6haitandimon/BSUSat2_simulator/docs/КД_CМКА/Файлы заказа/GNSS/StackUp_2L.jpg

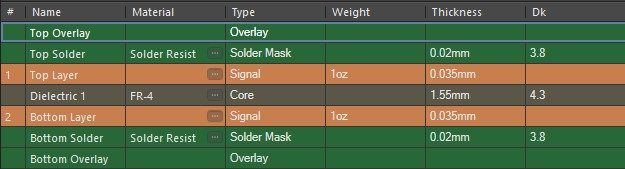
docs/КД_CМКА/Файлы заказа/GNSS/StackUp_2L.jpg
