6haitandimon/BSUSat2_simulator/docs/КД_CМКА/1_Ведомость-ВС_v1.docx

| | | Документация общая
| A4 | BY.ФДБИ 955.00.00.00 ПЗ | Пояснительная записка | 44
| A4 | BY.ФДБИ 955.00.00.00 ВО | Инженерная модель СМКА. Чертеж Общего вида | 1
| A4 | BY.ФДБИ 955.00.00.00 Э1 | Инженерная модель СМКА. Схема электрическая структурная | 2
| | | Документация по сборочным единицам
| A4 | BY.ФДБИ 955.01.00.00 СБ | Каркас инженерной модели СМКА. Сборочный чертеж | 2
| A2 | BY.ФДБИ 955.01.01.00 | Боковая сторона | 1
| A2 | BY.ФДБИ 955.01.02.00 | Верхняя сторона | 1
| A4 | BY.ФДБИ 955.01.03.00 | Опора | 1
| А2 | BY.ФДБИ 955.01.04.00 | Переборка | 1
| А4 | BY.ФДБИ 955.01.05.00 | Крепление датчика направления на солнце | 1
| *) | BY.ФДБИ 955.02.00.00 Э1 | Бортовая система энергоснабжения и коммуникации. Схема электрическая структурная | 9 | | А3, А4
| *) | BY.ФДБИ 955.02.00.00 Э3 | Бортовая система энергоснабжения и коммуникации. Схема электрическая принципиальная | 11 | | А3, А4
| А4 | BY.ФДБИ 955.02.00.00 ПЭ3 | Бортовая система энергоснабжения и коммуникации. Перечень элементов | 4
| А4 | BY.ФДБИ 955.02.00.00 СБ | Бортовая система энергоснабжения и коммуникации. Сборочный чертеж | 2
| А4 | BY.ФДБИ 955.02.01.00 Э1 | Модуль аккумуляторных батарей. Схема электрическая структурная | 2
| А4 | BY.ФДБИ 955.02.01.00 Э3 | Модуль аккумуляторных батарей. Схема электрическая принципиальная | 5
| А4 | BY.ФДБИ 955.02.01.00 ПЭ3 | Модуль аккумуляторных батарей. Перечень элементов | 3
| А4 | BY.ФДБИ 955.02.01.00 СБ | Модуль аккумуляторных батарей. Сборочный чертеж | 2
| А4 | BY.ФДБИ 955.03.00.00 Э1 | Модуль бортовой системы радиосвязи. Схема электрическая структурная | 2
| А4 | BY.ФДБИ 955.03.00.00 Э3 | Модуль бортовой системы радиосвязи. Схема электрическая принципиальная | 5
| А4 | BY.ФДБИ 955.03.00.00 ПЭ3 | Модуль бортовой системы радиосвязи. Перечень элементов | 2
| А4 | BY.ФДБИ 955.03.00.00 СБ | Модуль бортовой системы радиосвязи. Сборочный чертеж | 2
| А4 | BY.ФДБИ 955.04.00.00 Э1 | Модуль системы радионавигации. Схема электрическая структурная | 2
| А4 | BY.ФДБИ 955.04.00.00 Э3 | Модуль системы радионавигации. Схема электрическая принципиальная | 7
| А4 | BY.ФДБИ 955.04.00.00 ПЭ3 | Модуль системы радионавигации. Перечень элементов | 2
| А4 | BY.ФДБИ 955.04.00.00 СБ | Модуль системы радионавигации. Сборочный чертеж | 2
| А4 | BY.ФДБИ 955.05.00.00 Э1 | Модуль электромагнитной ориентации и стабилизации. Схема электрическая структурная | 2
| А4 | BY.ФДБИ 955.05.00.00 Э3 | Модуль электромагнитной ориентации и стабилизации. Схема электрическая принципиальная | 7
| А4 | BY.ФДБИ 955.05.00.00 ПЭ3 | Модуль электромагнитной ориентации и стабилизации. Перечень элементов | 3
| А4 | BY.ФДБИ 955.05.00.00 СБ | Модуль электромагнитной ориентации и стабилизации. Сборочный чертеж | 2
| А4 | BY.ФДБИ 955.06.00.00 Э1 | Модуль датчиков направления на Солнце и системы оптического трекинга. Схема электрическая структурная | 1
| А4 | BY.ФДБИ 955.06.00.00 Э3 | Модуль датчиков направления на Солнце и системы оптического трекинга. Схема электрическая принципиальная | 5
| А4 | BY.ФДБИ 955.06.00.00 ПЭ3 | Модуль датчиков направления на Солнце и системы оптического трекинга. Перечень элементов | 2
| А4 | BY.ФДБИ 955.06.00.00 СБ | Модуль датчиков направления на Солнце и системы оптического трекинга. Сборочный чертеж | 2
| А4 | BY.ФДБИ 955.07.00.00 Э1 | Модуль системы бортового компьютера Схема электрическая структурная | 2
| А4 | BY.ФДБИ 955.07.00.00 Э3 | Модуль системы бортового компьютера Схема электрическая принципиальная | 9
| А4 | BY.ФДБИ 955.07.00.00 ПЭ3 | Модуль системы бортового компьютера. Перечень элементов | 3
| А4 | BY.ФДБИ 955.07.00.00 СБ | Модуль системы бортового компьютера. Сборочный чертеж | 2

BY.ФДБИ 955.00.00.00 ВС Копировал: Лист 2 Изм Формат А4 Лист № докум. Подпись Дата Форма 8а ГОСТ 2.106-96

BY.ФДБИ 955.00.00.00 ВС Изм Лист № докум. Подпись Дата Разраб. Суровцев Инженерная модель СМКА Ведомость спецификаций Лит. Лист Листов Пров. Стецко О 1 2 БГУ Н. контр. Огурцов Утв. Копировал: Формат А4 Семенович Форма 8 ГОСТ 2.106-96

№ строки Формат Обозначение Наименование Кол. листов № экз. Приме- чание

№ строки Формат Обозначение Наименование Кол. листов № эк Приме- чание
