6haitandimon/BSUSat2_simulator/docs/КД_CМКА/Документы/Титул_ПЗ.pdf

Инв. № подл. Подп. и дата Взам. инв. № Инв. № дубл. Подп. и дата

УТВЕРЖДЕН
ФДБИ 955.00.00.00.053

Разработать аппаратно-программный комплекс инженерных моделей СМКА и НКУ для отработки группового полёта

Рабочая конструкторская документация на опытный образец инженерной модели сверхмалого космического аппарата

Пояснительная записка

договор № 395/15 от 03.08.2021

ФДБИ 955.00.00.00.053
