6haitandimon/BSUSat2_simulator/docs/КД_CМКА/Документы/Титул_РКД_СМКА.pdf

Инв. № подл. Подп. и дата Взам. инв. № Инв. № дубл. Подп. и дата

УТВЕРЖДЕН
ФДБИ 955.00.00.00.053

Разработать аппаратно-программный комплекс инженерных моделей СМКА И НКУ
для отработки группового полета

Комплект рабочей конструкторской документации
на опытный образец инженерной модели СМКА с литерой «О»

к договору № 395/15 от 03.08.2021

ФДБИ 955.00.00.00.053
