6haitandimon/BSUSat2_simulator/docs/КД_CМКА/Файлы заказа/Mainboard/Diff_pair_90.jpg

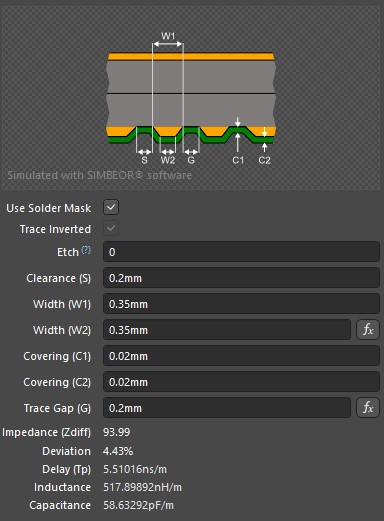
docs/КД_CМКА/Файлы заказа/Mainboard/Diff_pair_90.jpg
