6haitandimon/BSUSat2_simulator/docs/КД_CМКА/Файлы заказа/Mainboard/StackUp_4L.jpg

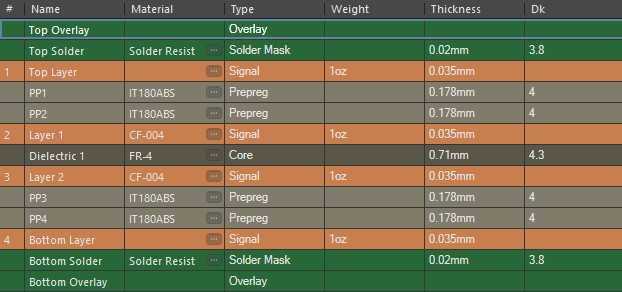
docs/КД_CМКА/Файлы заказа/Mainboard/StackUp_4L.jpg
