6haitandimon/BSUSat2_simulator/docs/КД_CМКА/Схемы/BY.ФДБИ 955.02.00.00 Э1_Э3.pdf

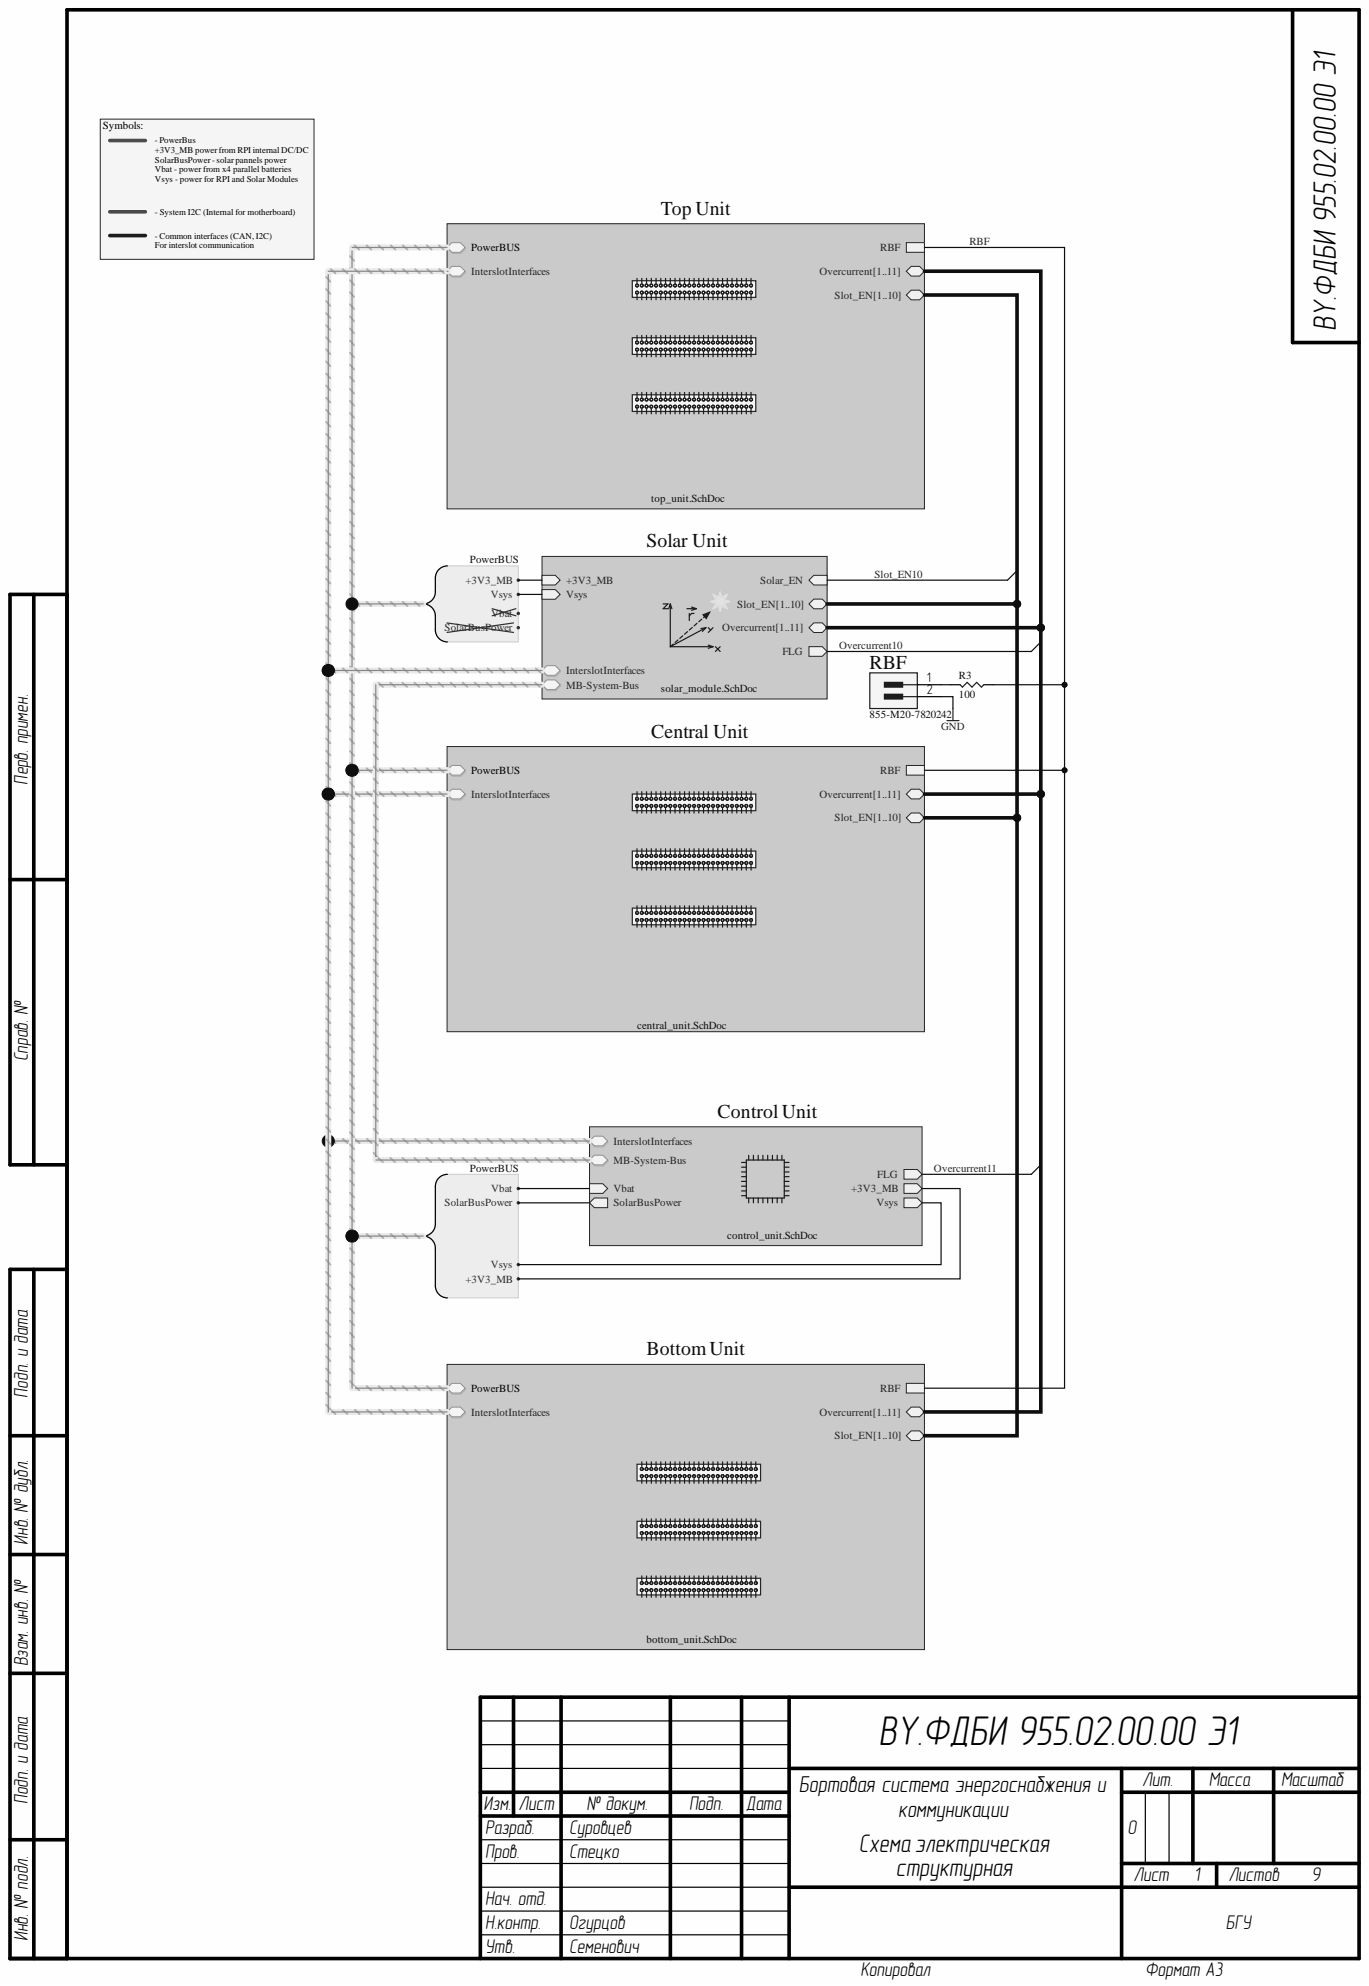
[picture p64: page 1]

- PowerBus
+3V3_MB power from RPI internal DC/DC
SolarBusPower -solar pannels power
Vbat - power from x4 parallel batteries
Vsys - power for RPI and Solar Modules

- System I2C (Internal for motherboard)

SolarBusPower Vsys

control_unit.SchDoc

BY.ФДБИ 955.02.00.00 Э1

Лит. | Масса | Масштаб

Изм. | Лист | № докум. | Подп. | Дата | | О
Разраб. | | Суровцев
Пров. | | Стецко

Лист | Листов 9

Нач. отд. | | | | | БГУ
Н.контр. | Огурцов
Утв. | Семенович

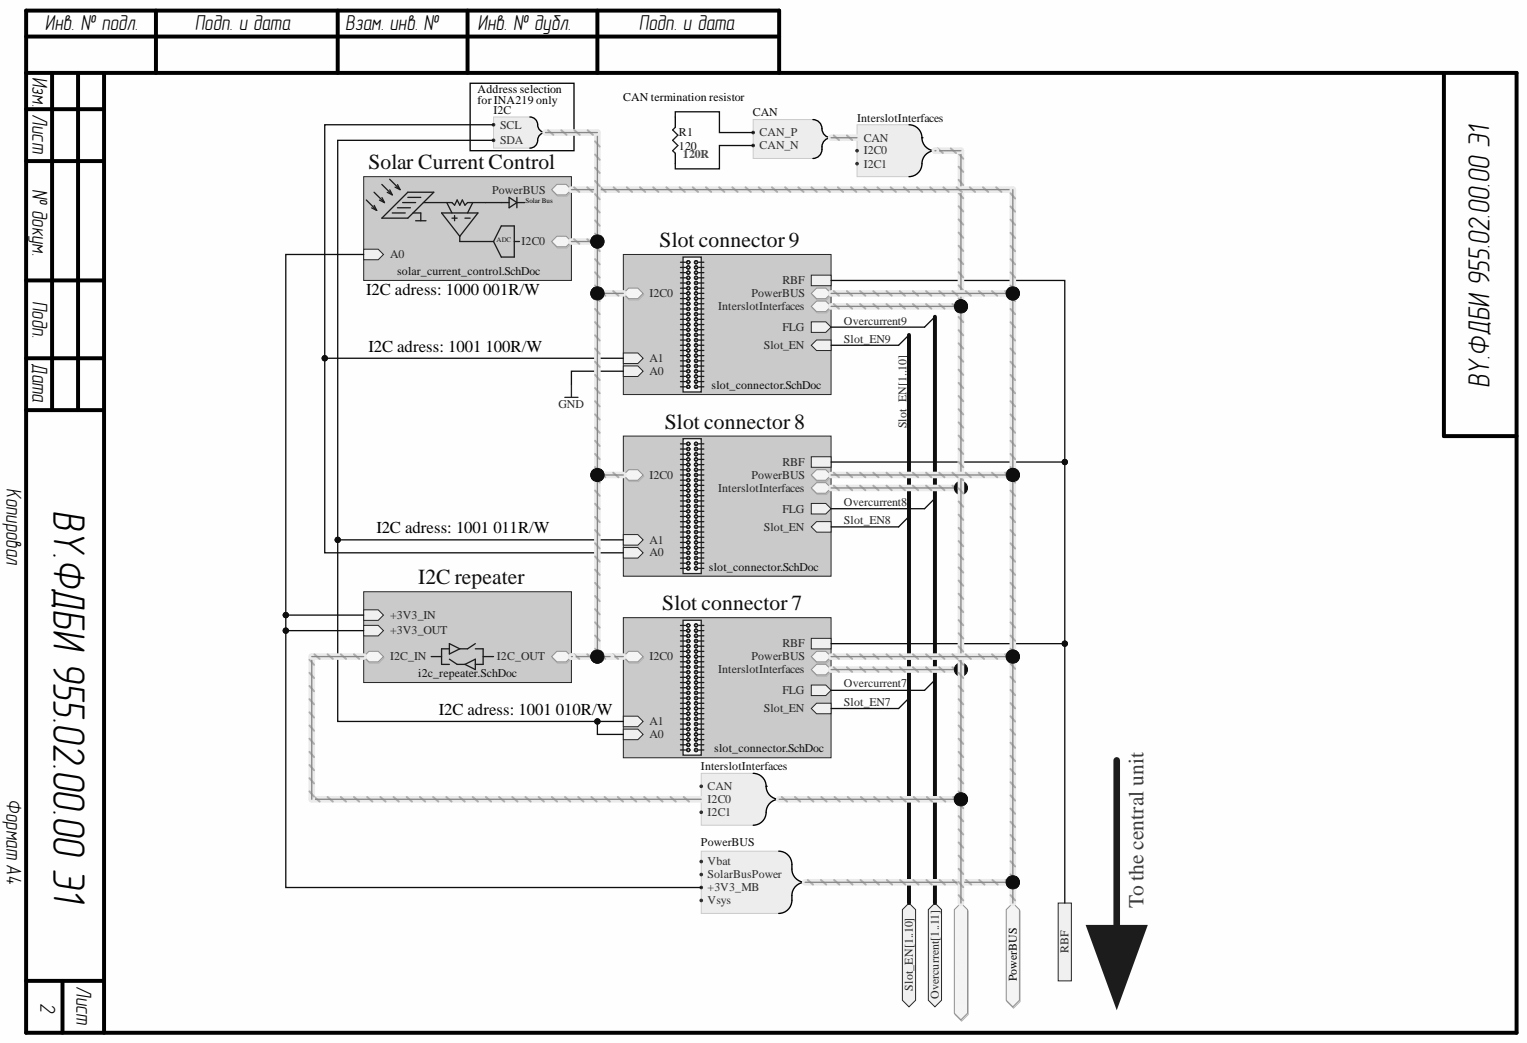
[picture p65: page 2]

Solar Current Control

PowerBUS

Slot connector 9

I2C0 A1 A0 | PowerBUS InterslotInterfaces FLG Slot_EN slot_connector.SchDoc

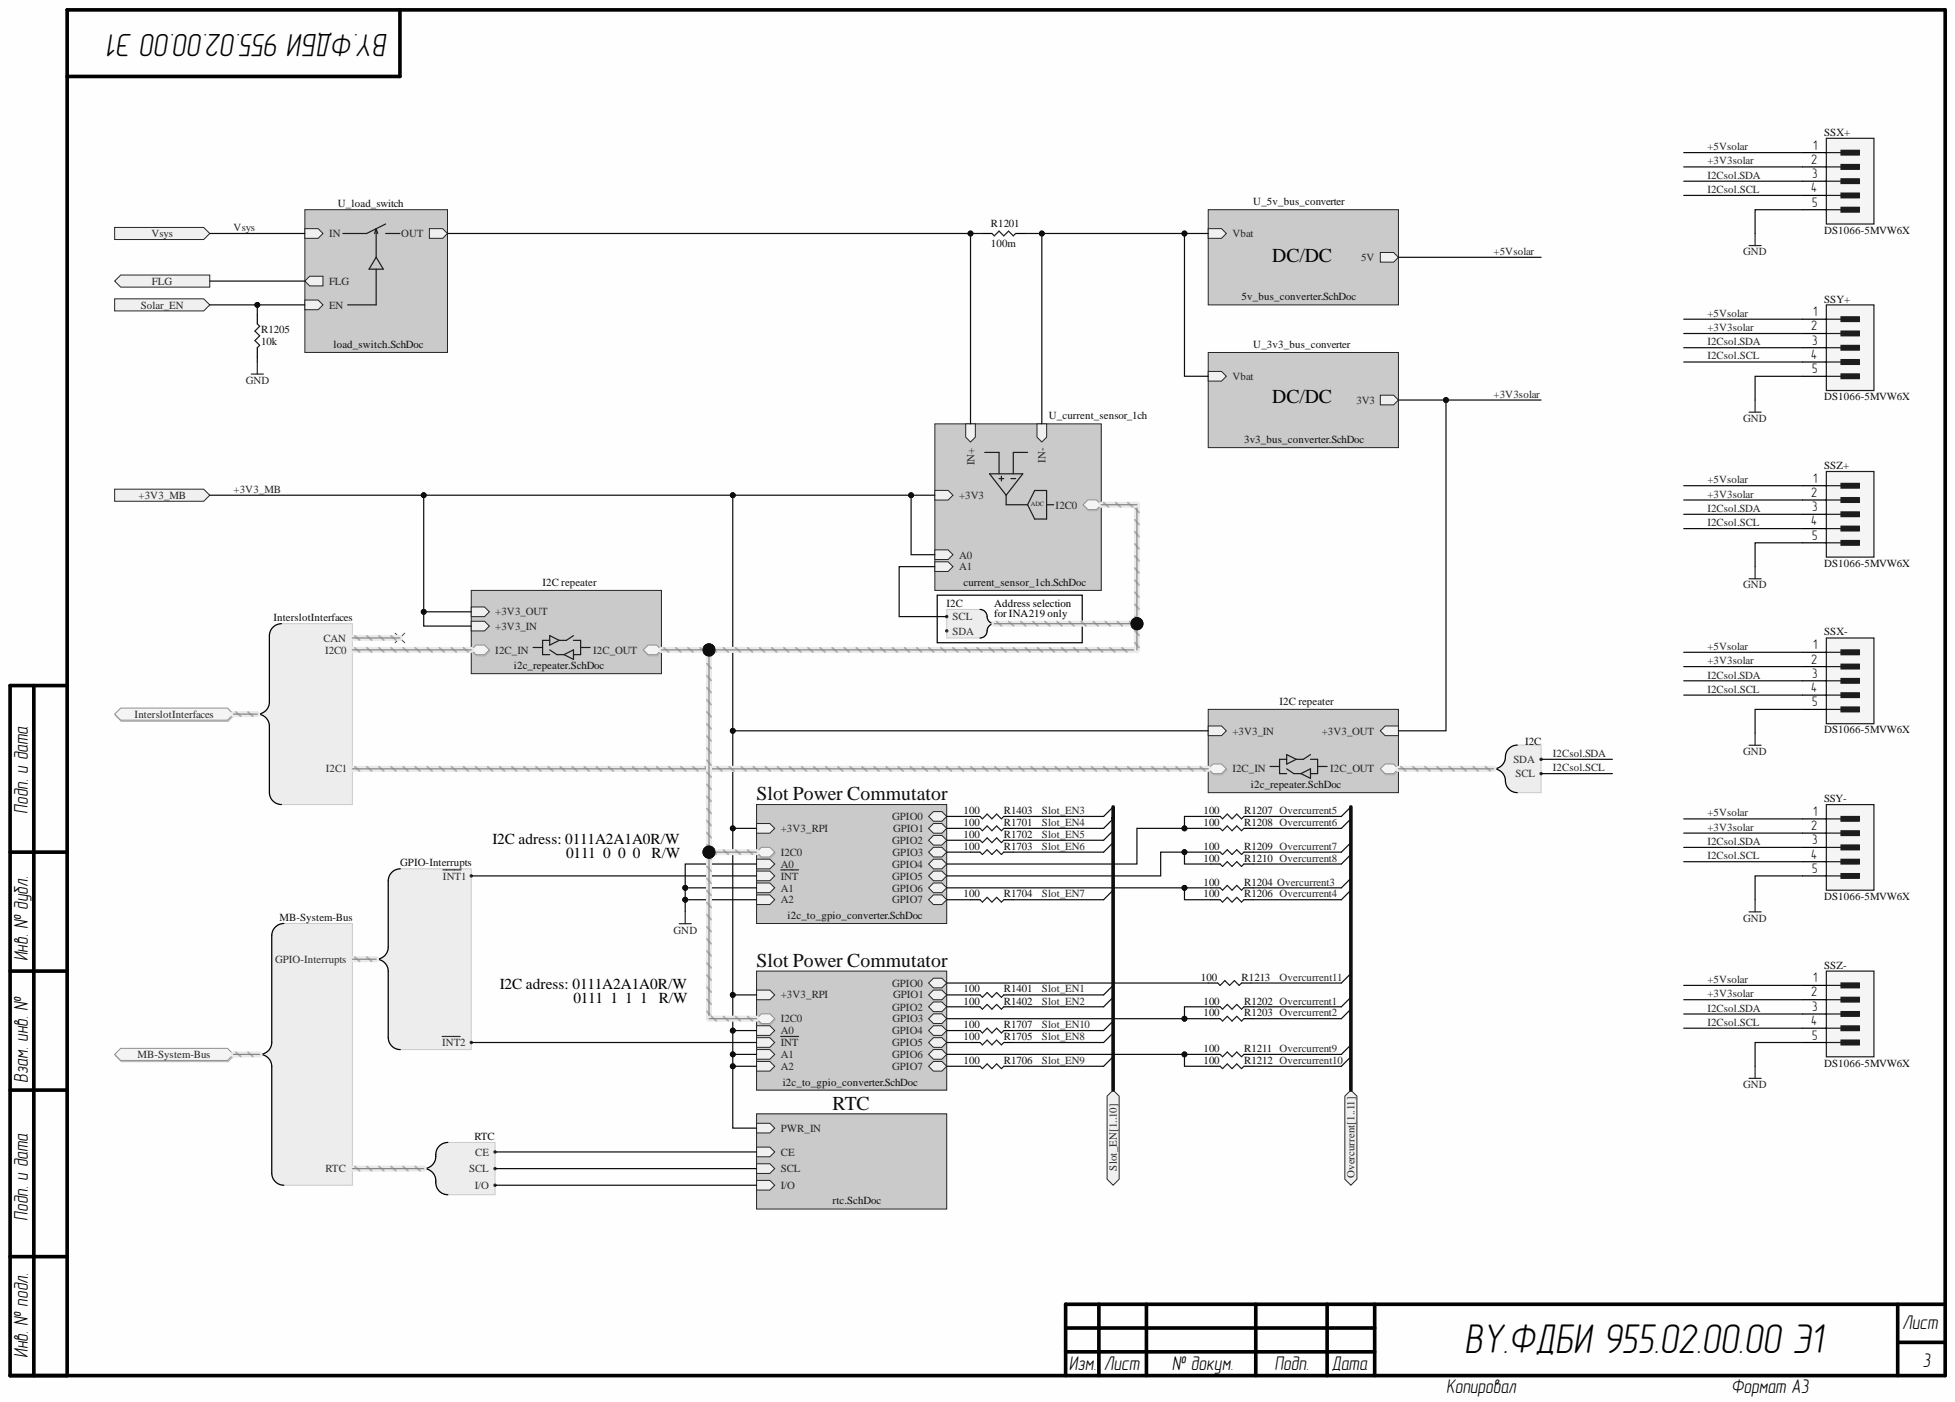
[picture p66: page 3]

Инв. № подл. Инв. № дубл. Подп. и дата Взам. инв. № Подп. и дата

BY.ФДБИ 955.02.00.00 Э1

Изм. Лист | № докум. | Подп. | Дата

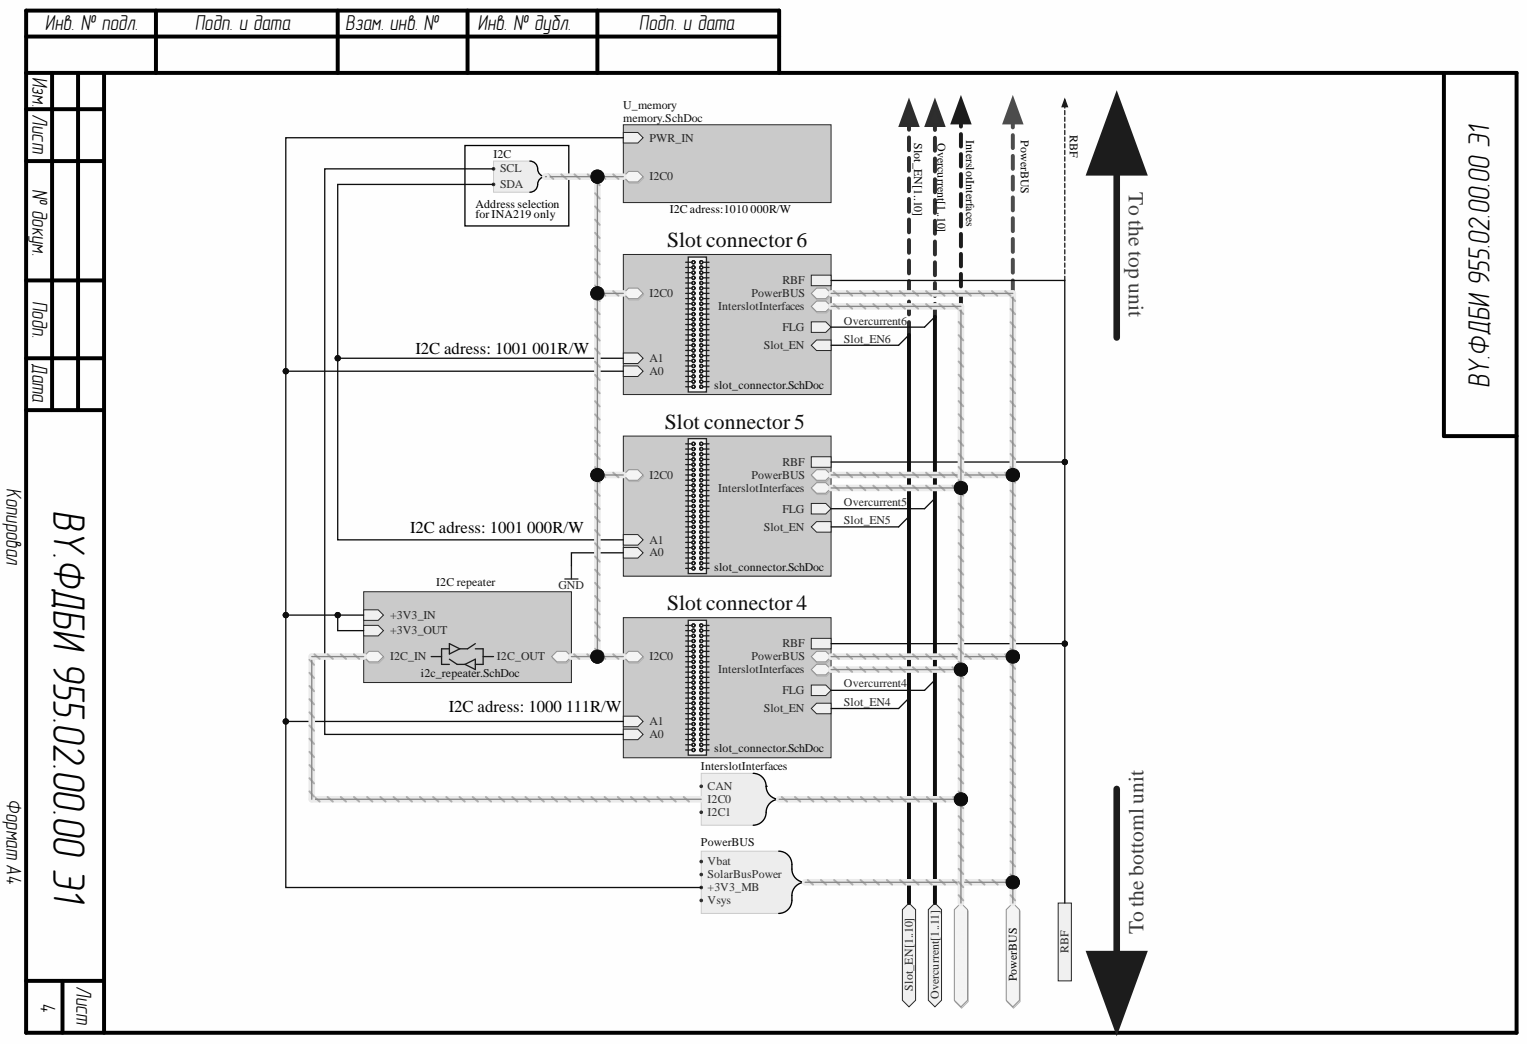
[picture p67: page 4]

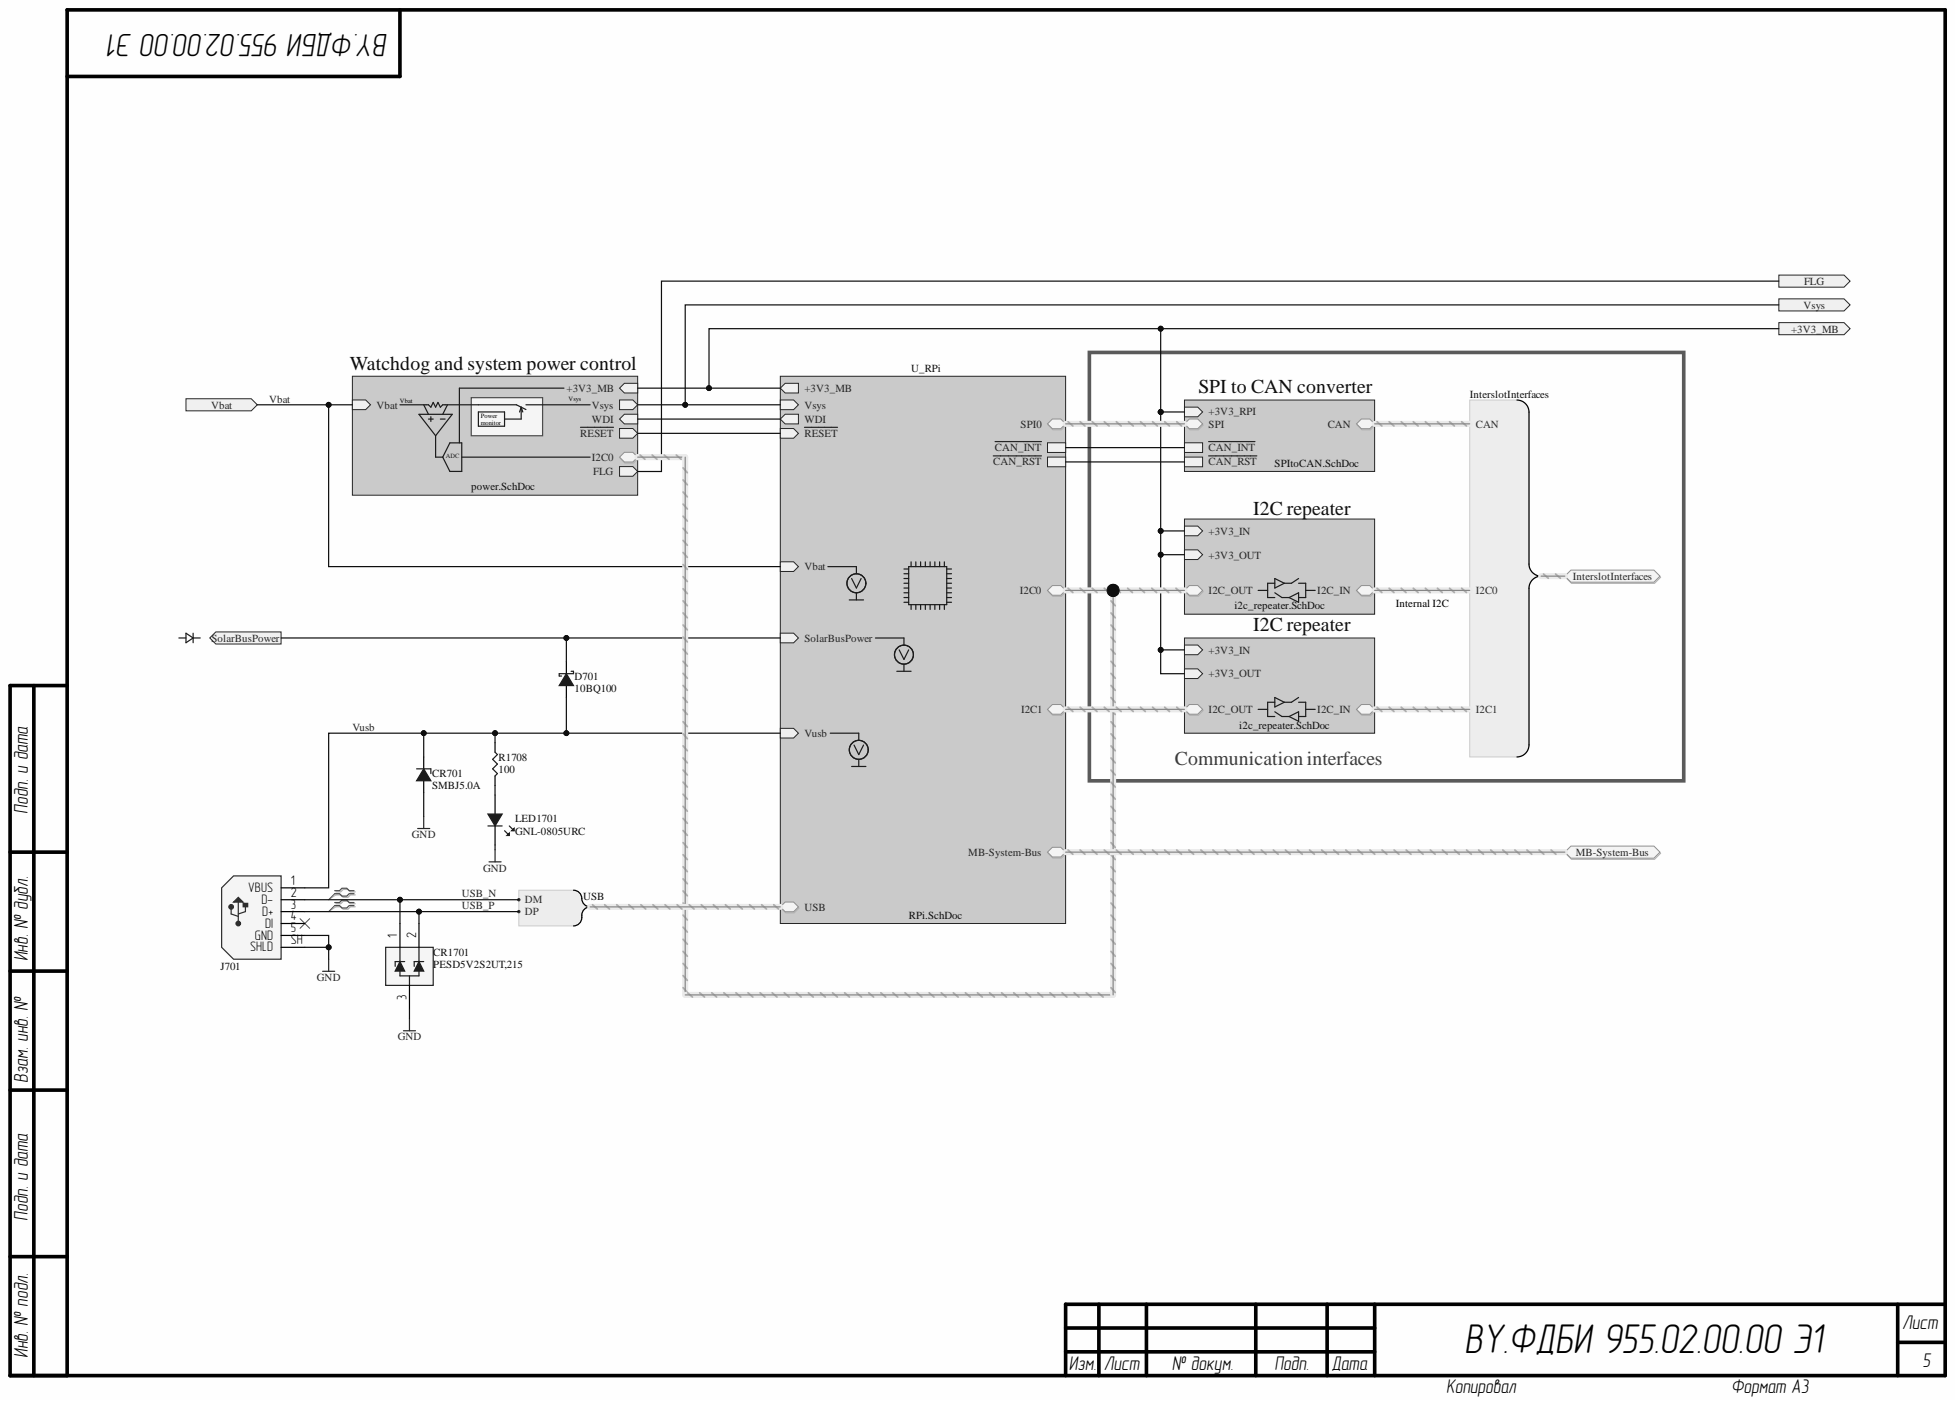
[picture p68: page 5]

SPI to CAN co

Инв. № подл. Инв. № дубл. Подп. и дата Взам. инв. № Подп. и дата

BY.ФДБИ 955.02.00.00 Э1

Изм. Лист | № докум. | Подп. | Дата

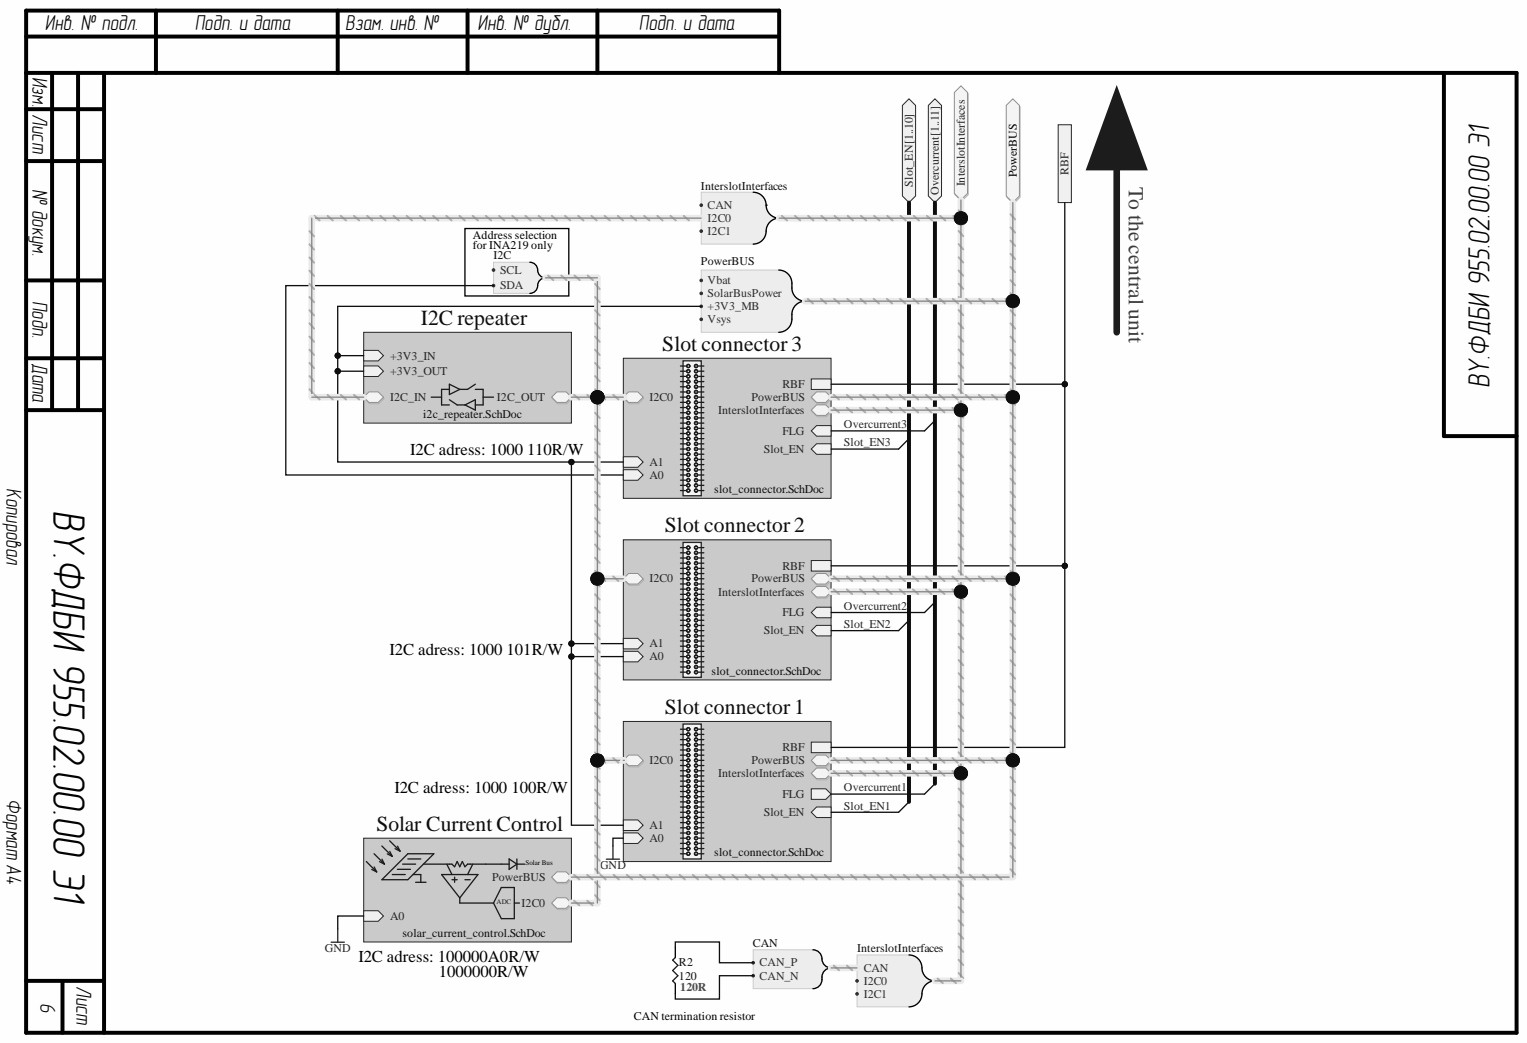
[picture p69: page 6]

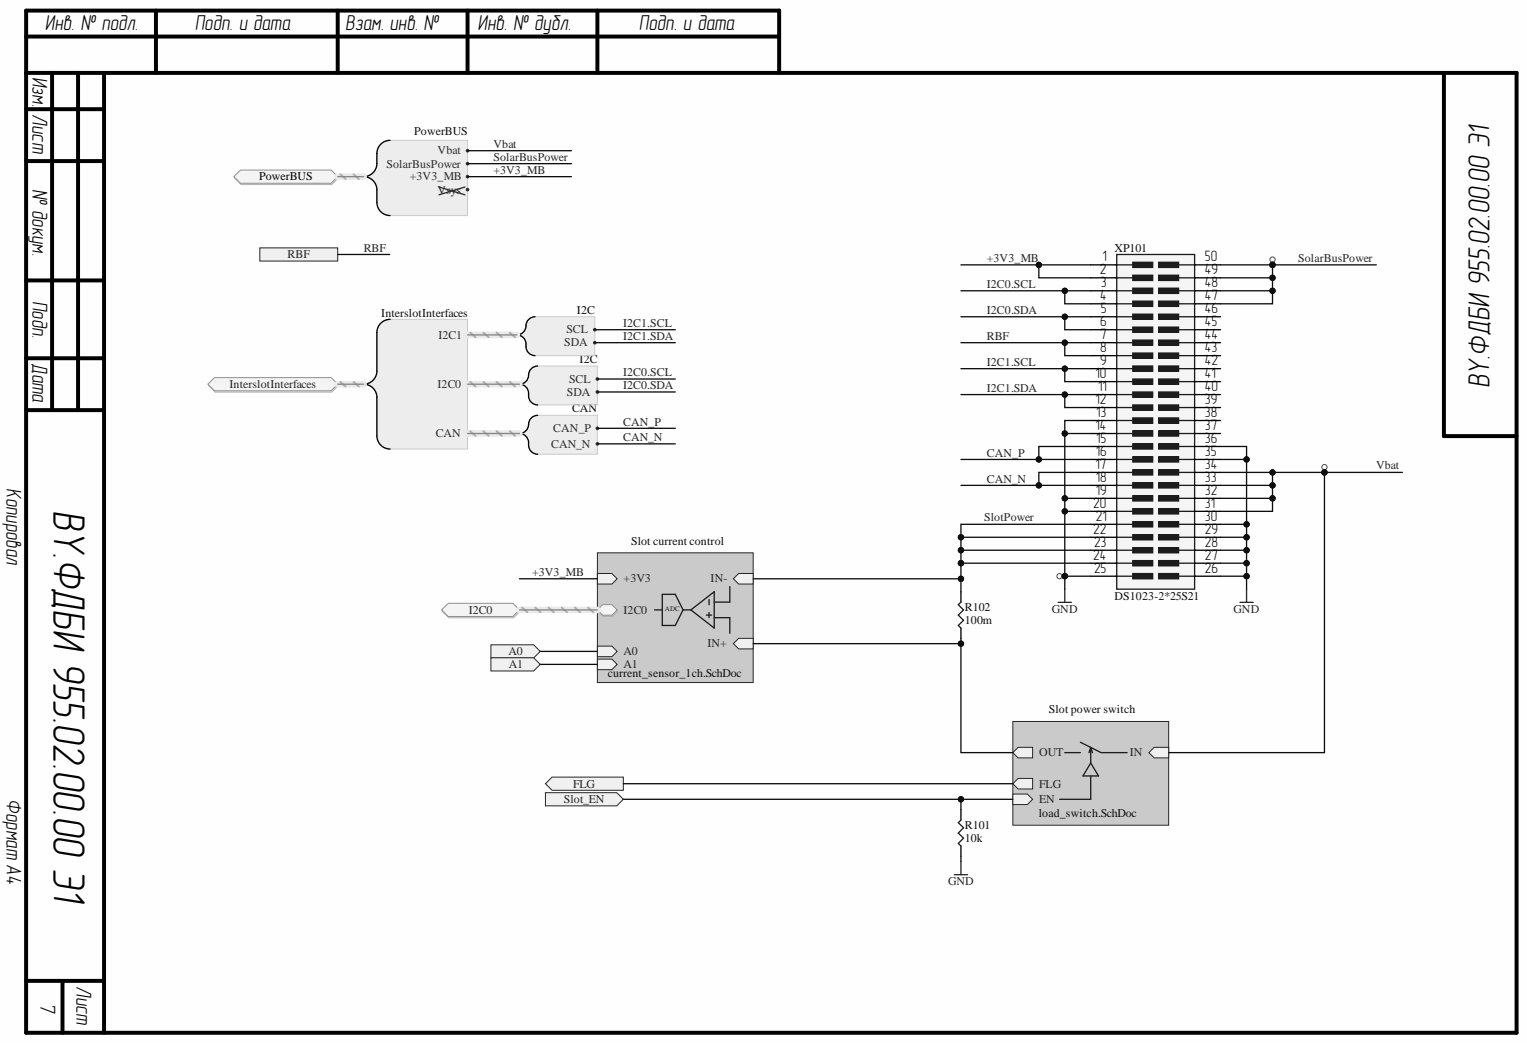
[picture p70: page 7]

48
47

35
34 33
32
31
30
29
28

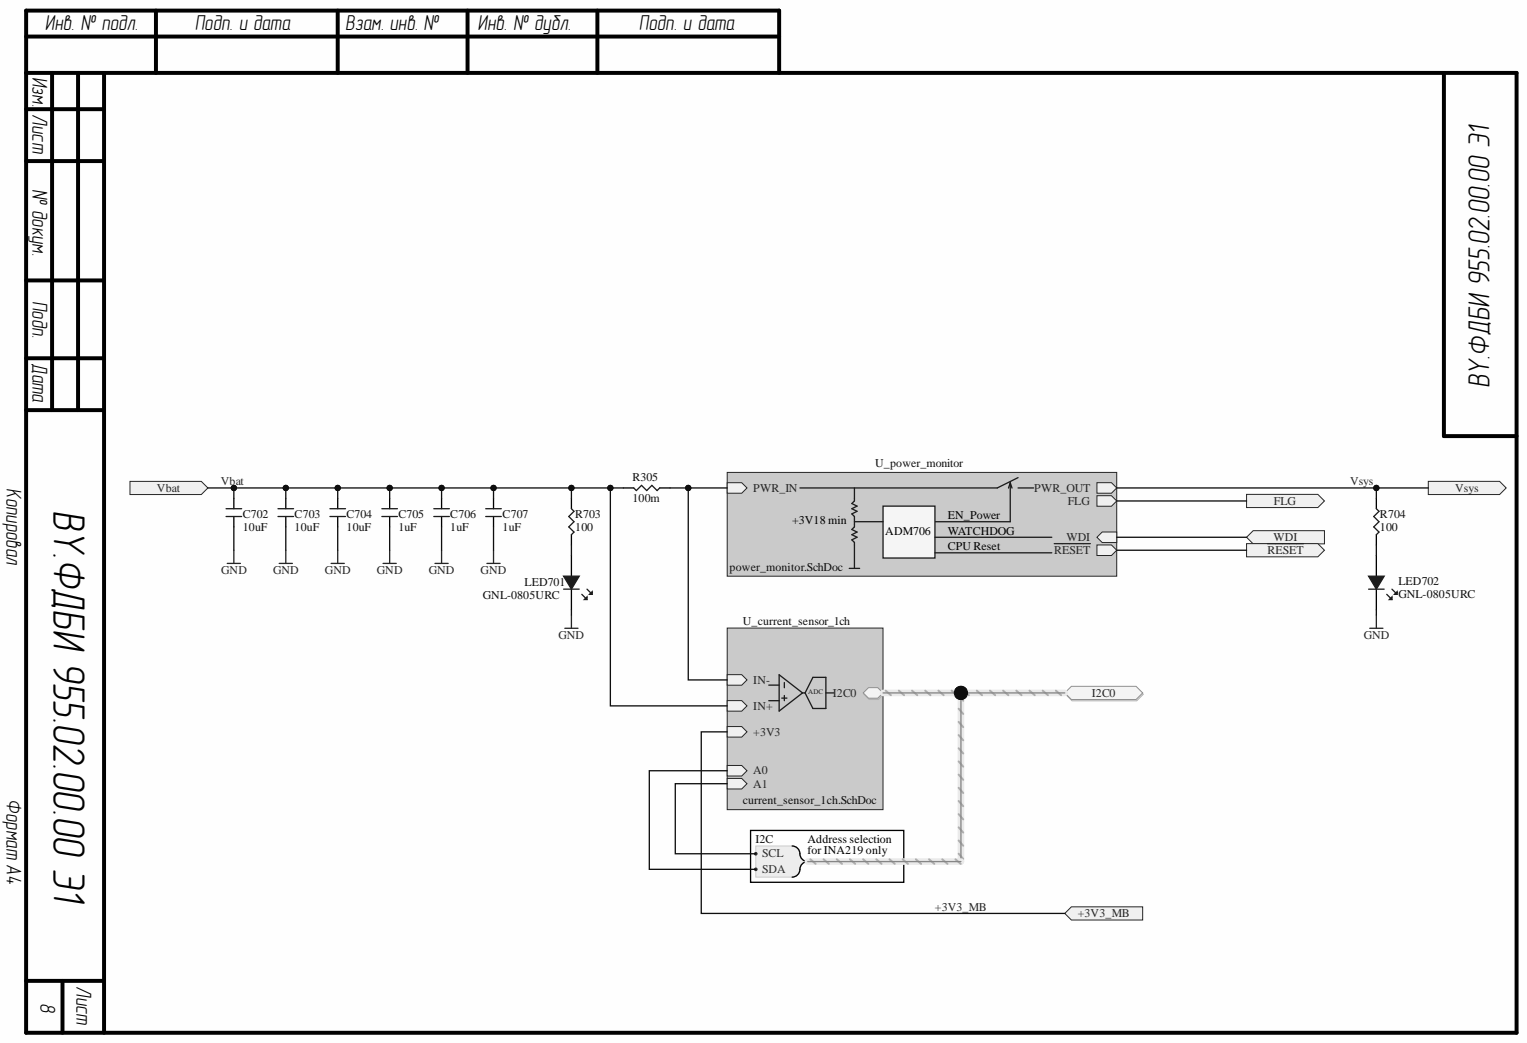
[picture p71: page 8]

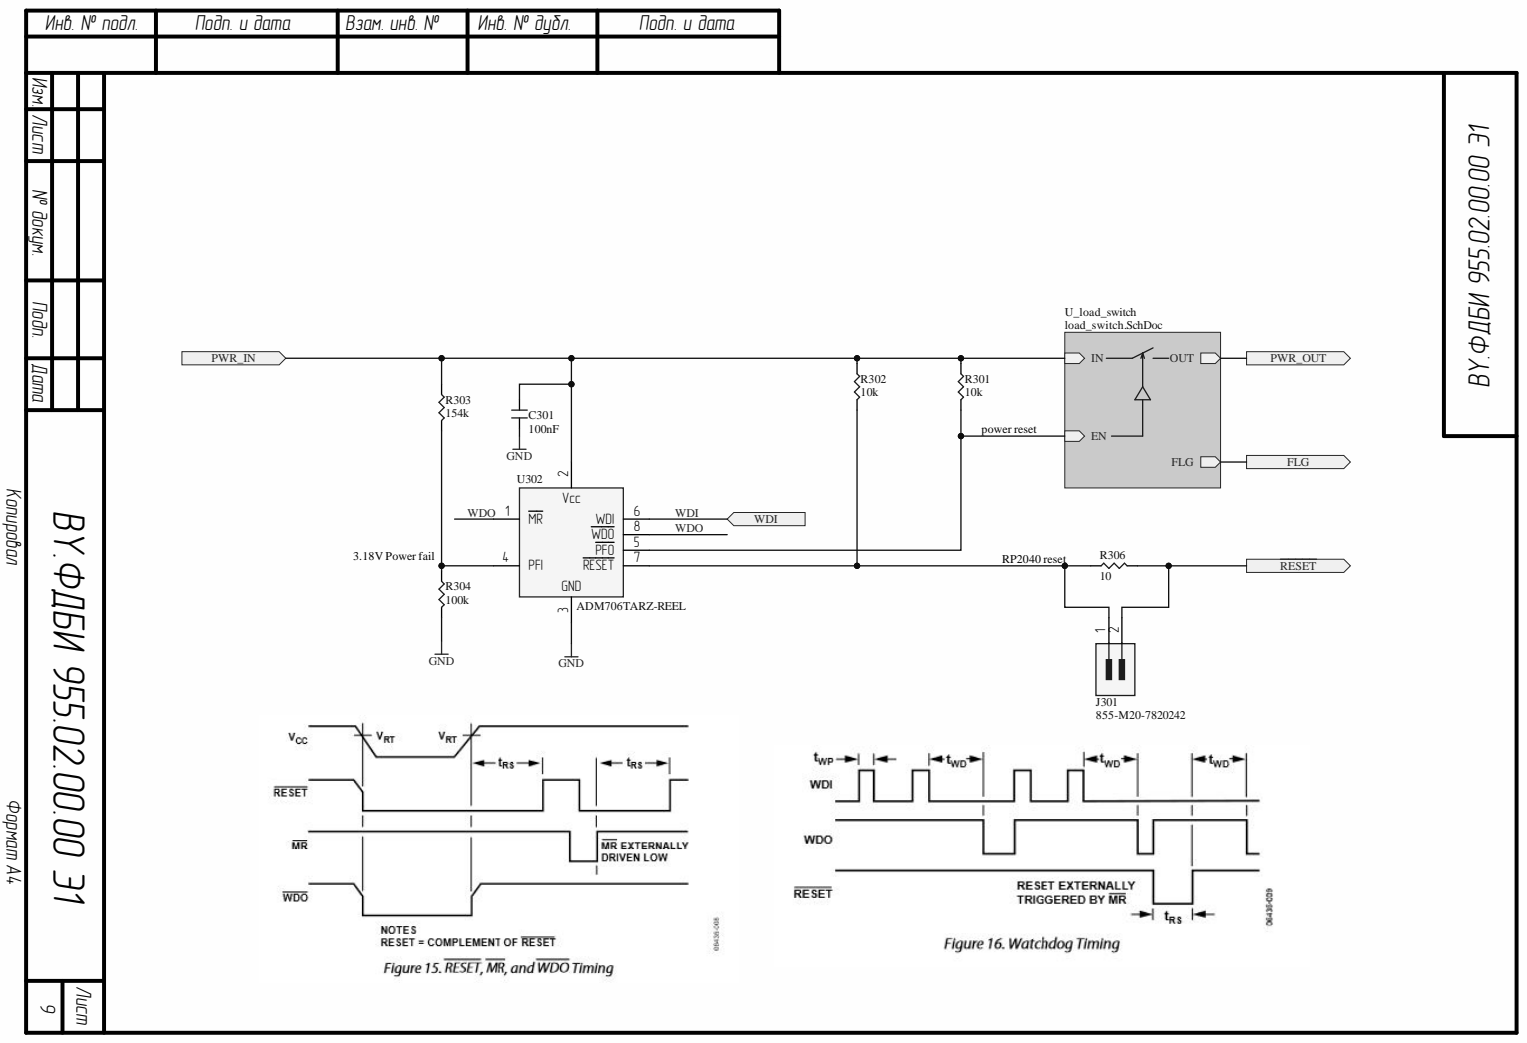
[picture p72: page 9]

№ докум. Лист Изм. Подп. Дата

U _ l oad _ s w i t c h l oad _ s w i tch . S c h D o c

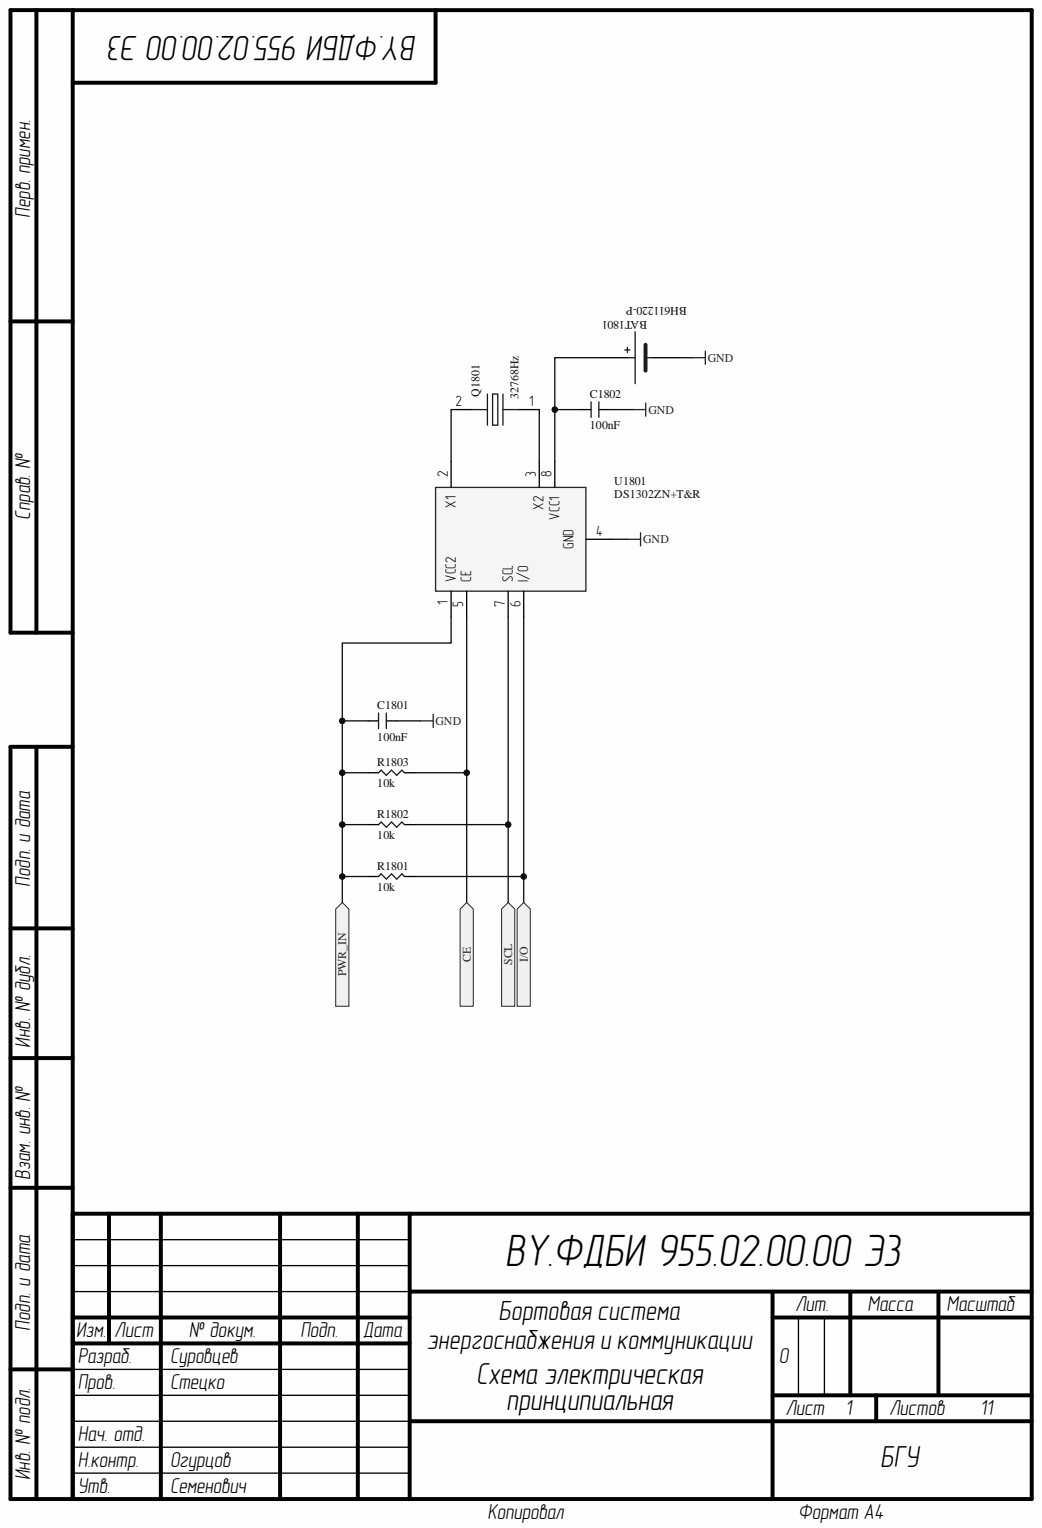
[picture p73: page 10]

BY.ФДБИ 955.02.00.00 Э3

Лит. | Масса | Масштаб

Изм. | Лист | № докум. | Подп. | Дата | | О
Разраб. | | Суровцев
Пров. | Стецко
Нач. отд. | | БГУ
Н.контр. | Огурцов
Утв. | Семенович

Лист | Листов 11

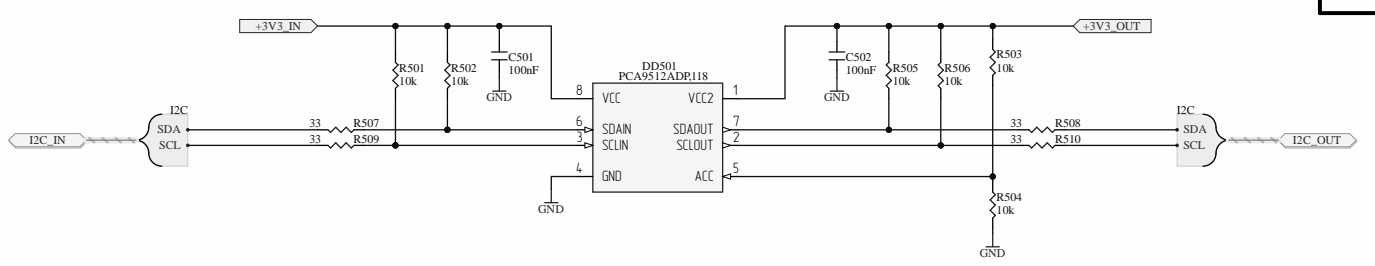
[picture p74: page 11]

№ докум. Лист Изм. Подп. Дата

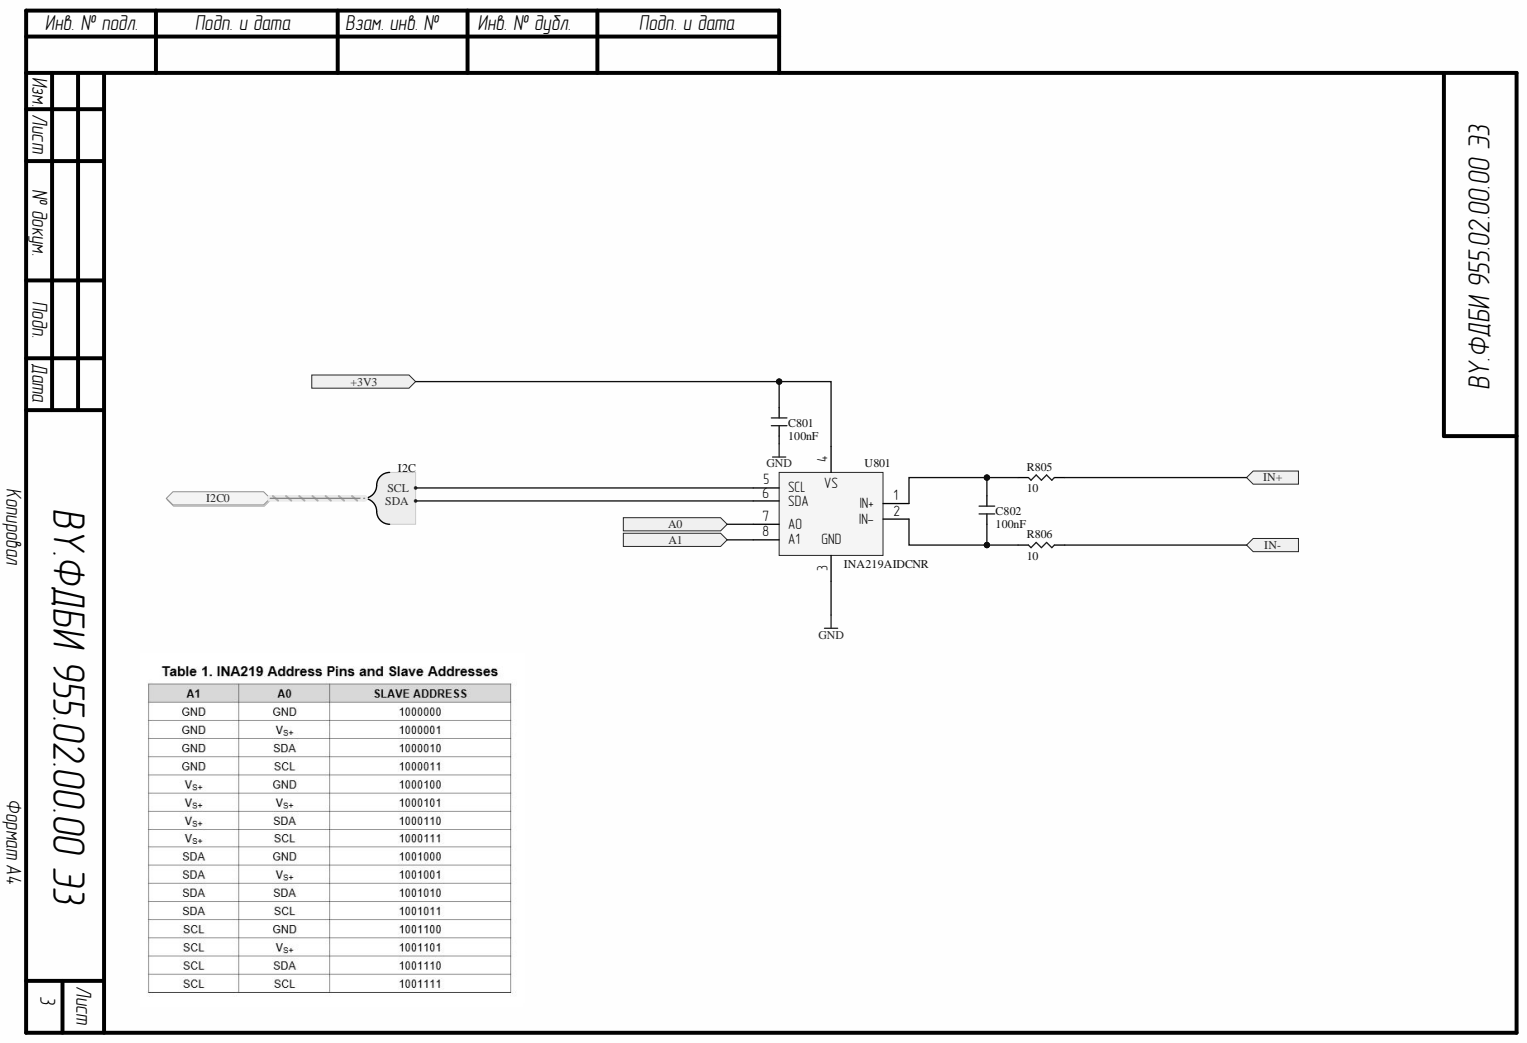
[picture p75: page 12]

№ докум. Лист Изм. Подп. Дата

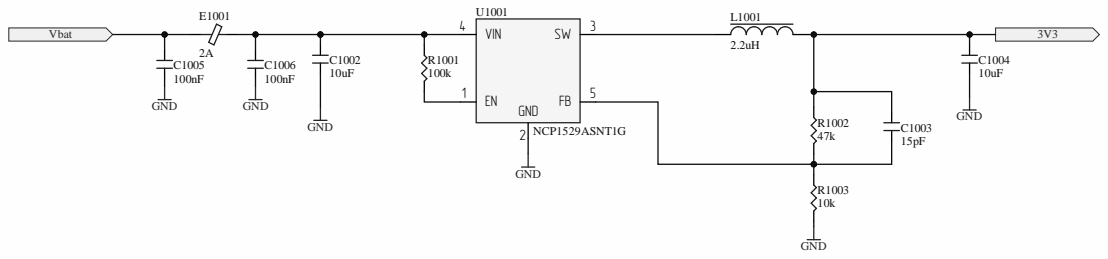
[picture p76: page 13]

№ докум. Лист Изм. Подп. Дата

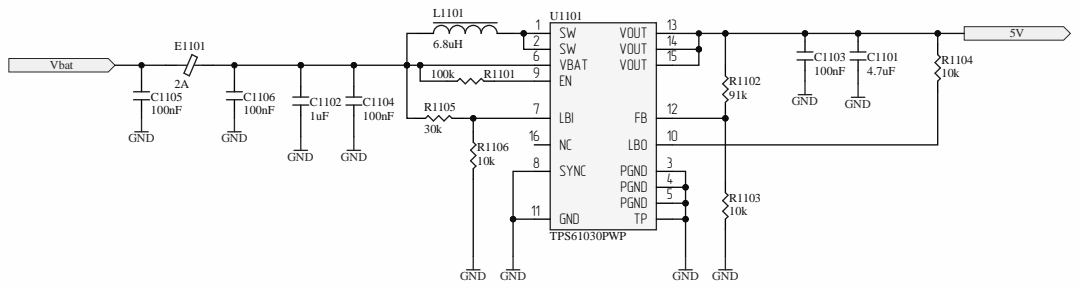
[picture p77: page 14]

№ докум. Лист Изм. Подп. Дата

GND 11 | 4

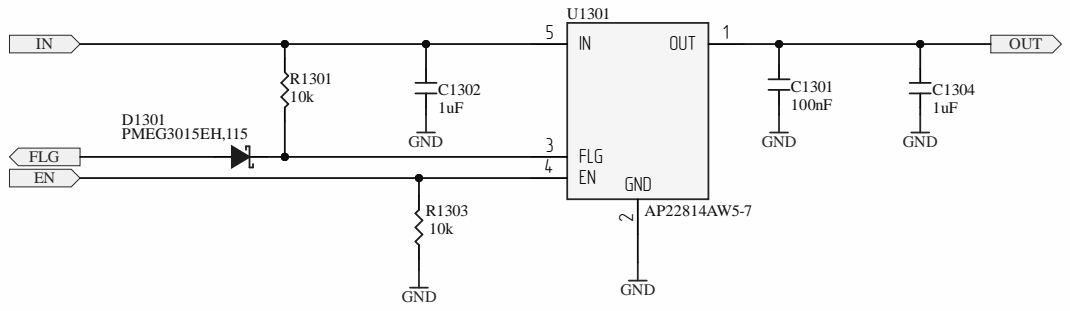
[picture p78: page 15]

№ докум. Лист Изм. Подп. Дата

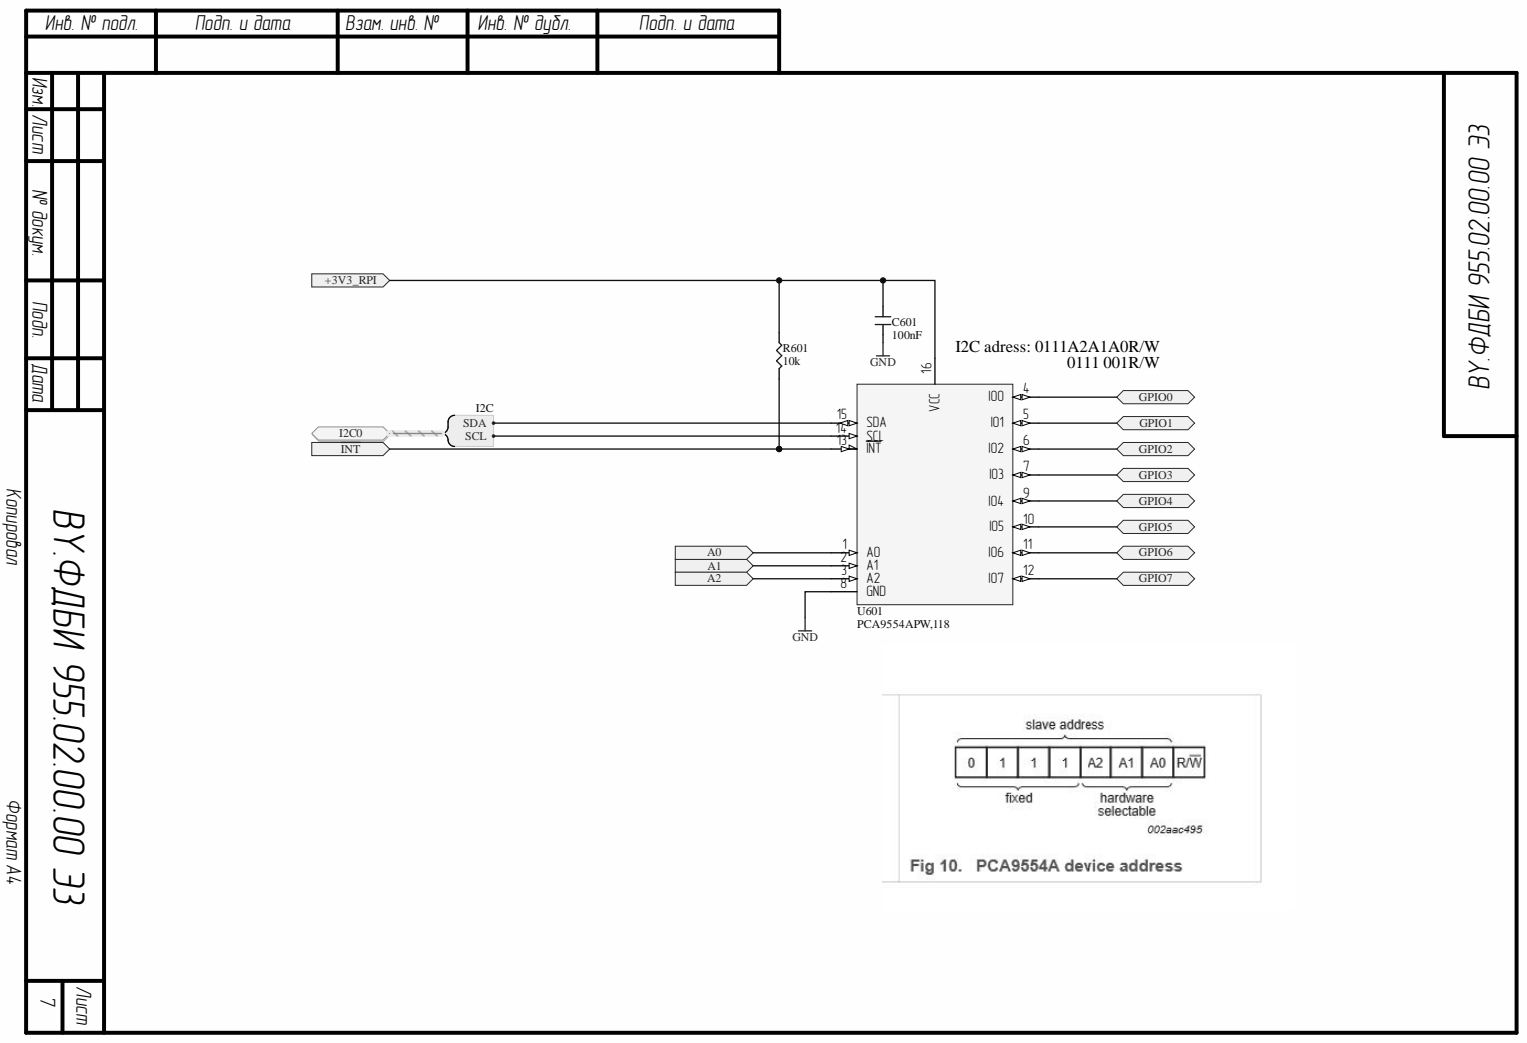
[picture p79: page 16]

№ докум. Лист Изм. Подп. Дата

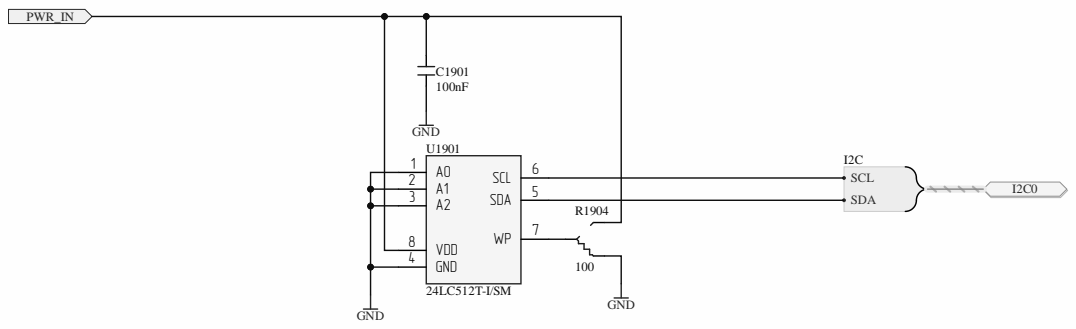
[picture p80: page 17]

№ докум. Лист Изм. Подп. Дата

8 | WP VDD GND

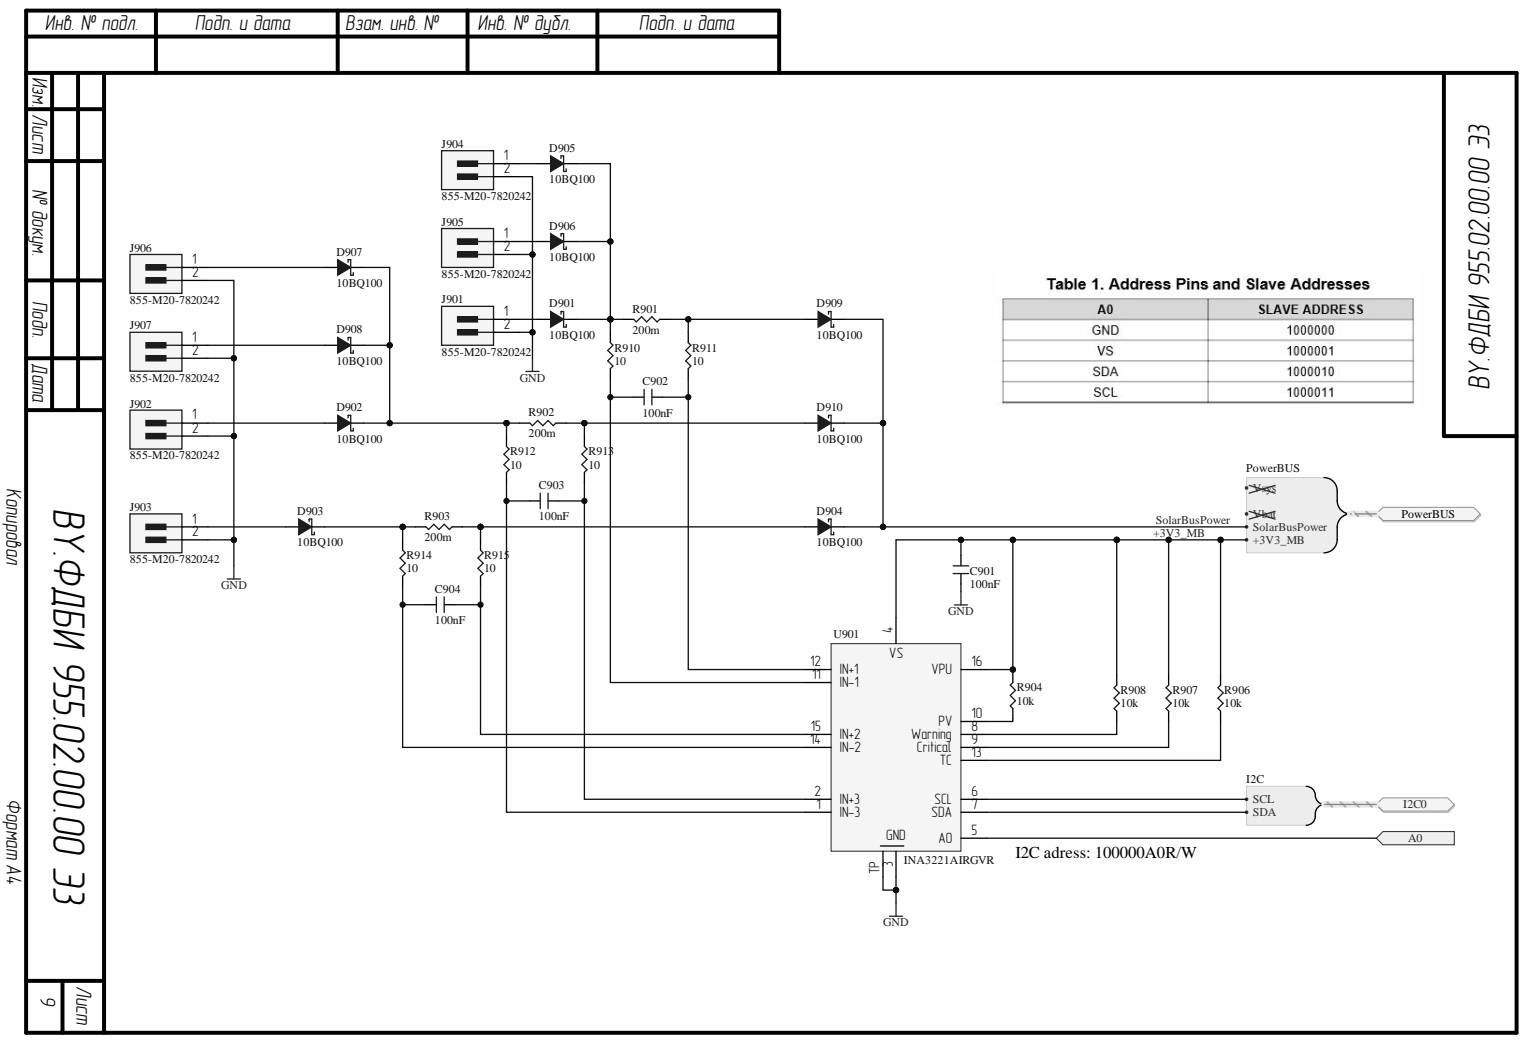
[picture p81: page 18]

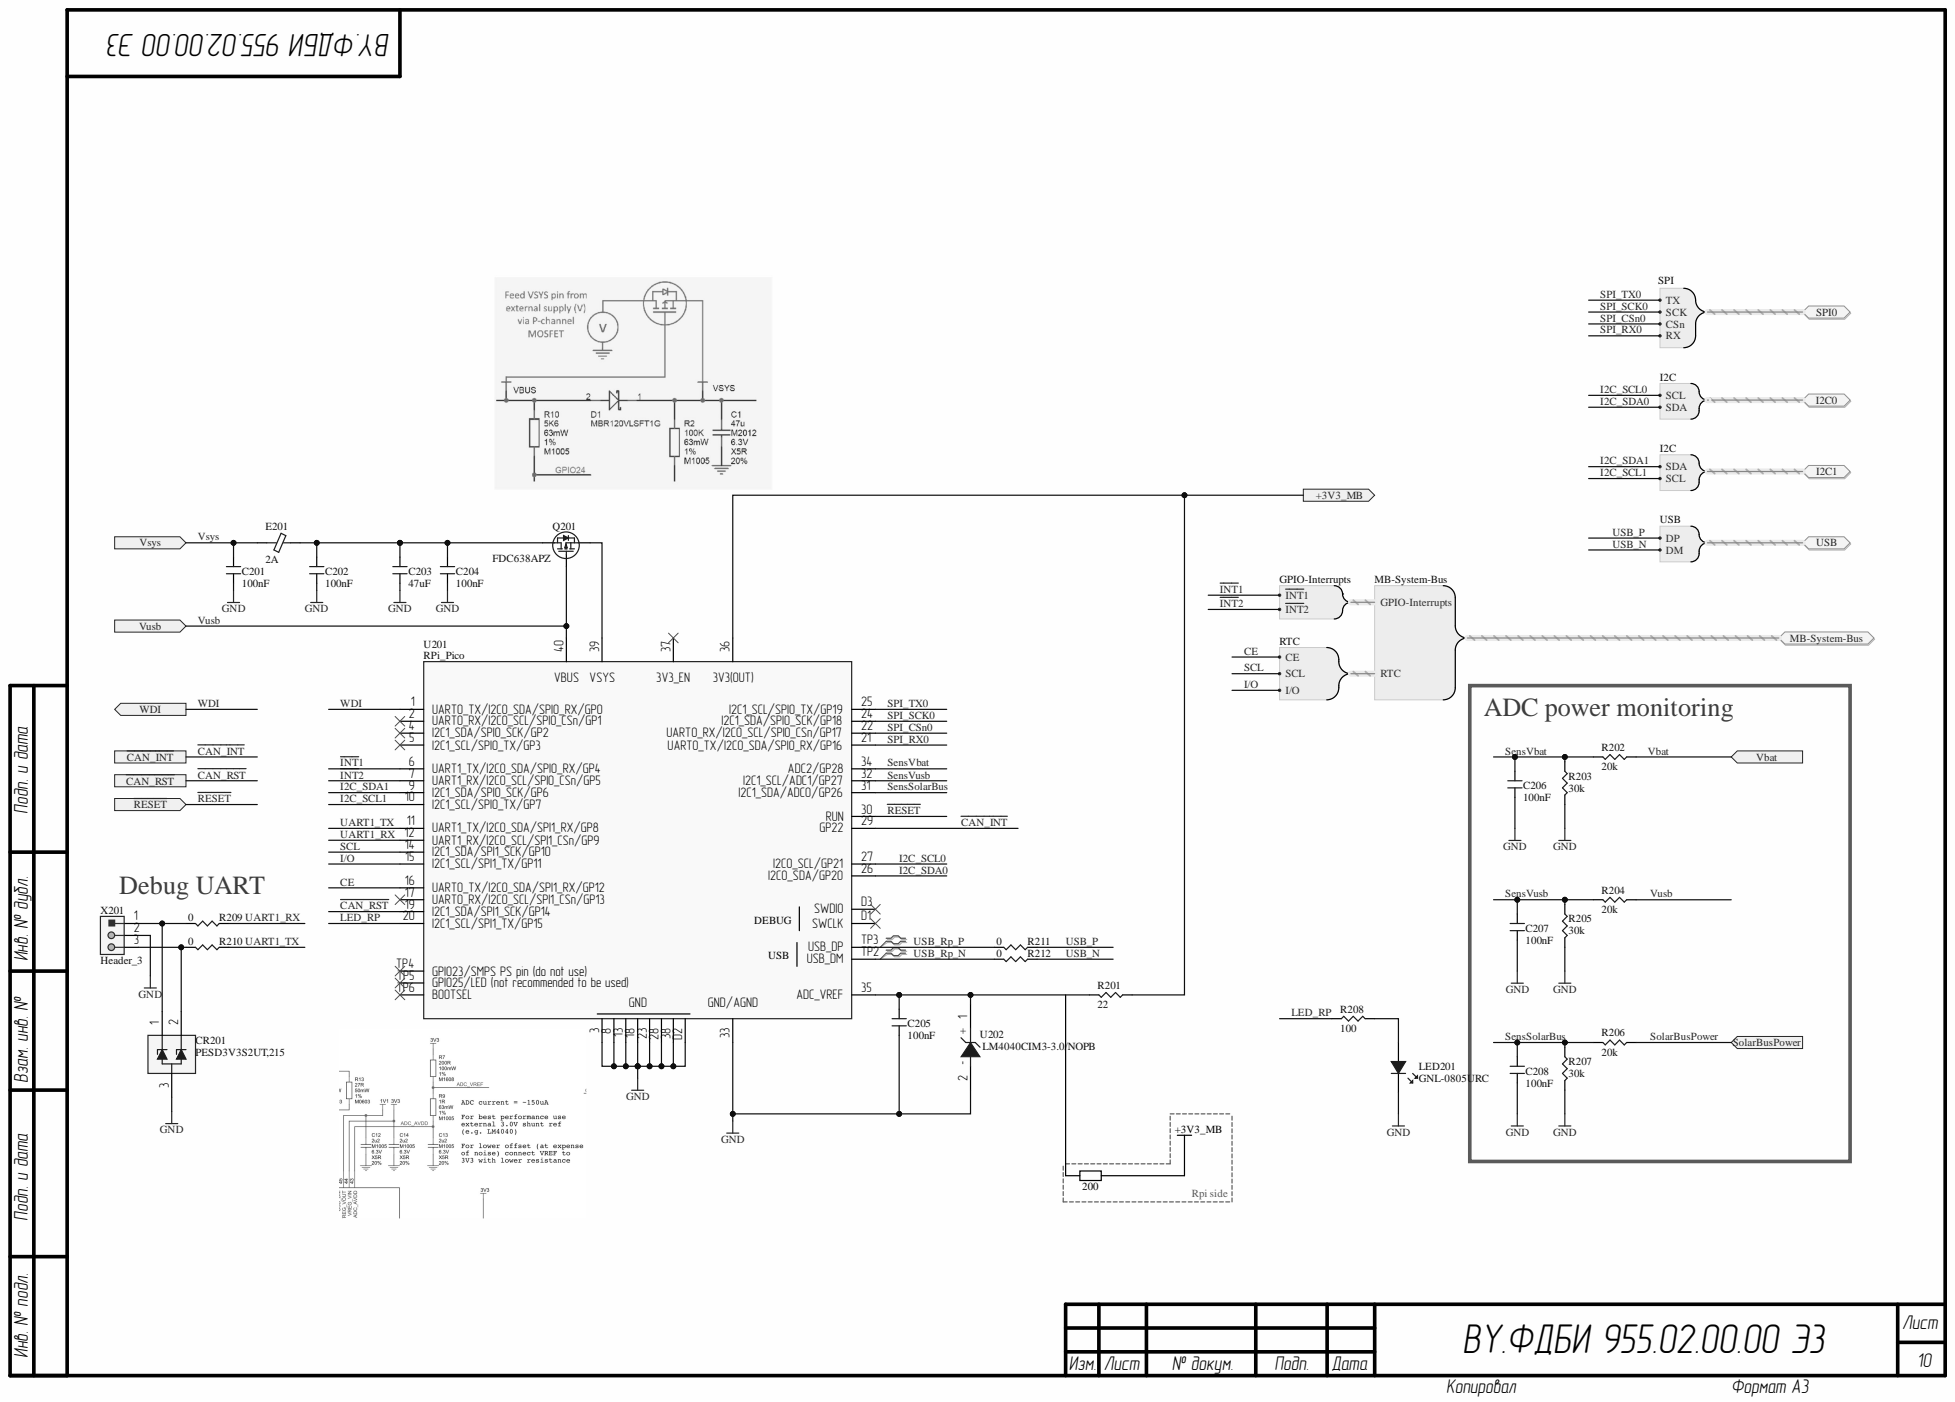
[picture p82: page 19]

GPIO23/SMPS PS pin (do not use) TP4
GPIO25/LED (not recommended to be used) TP5
BOOTSEL TP6

BY.ФДБИ 955.02.00.00 Э3

Изм. Лист | № докум. | Подп. | Дата

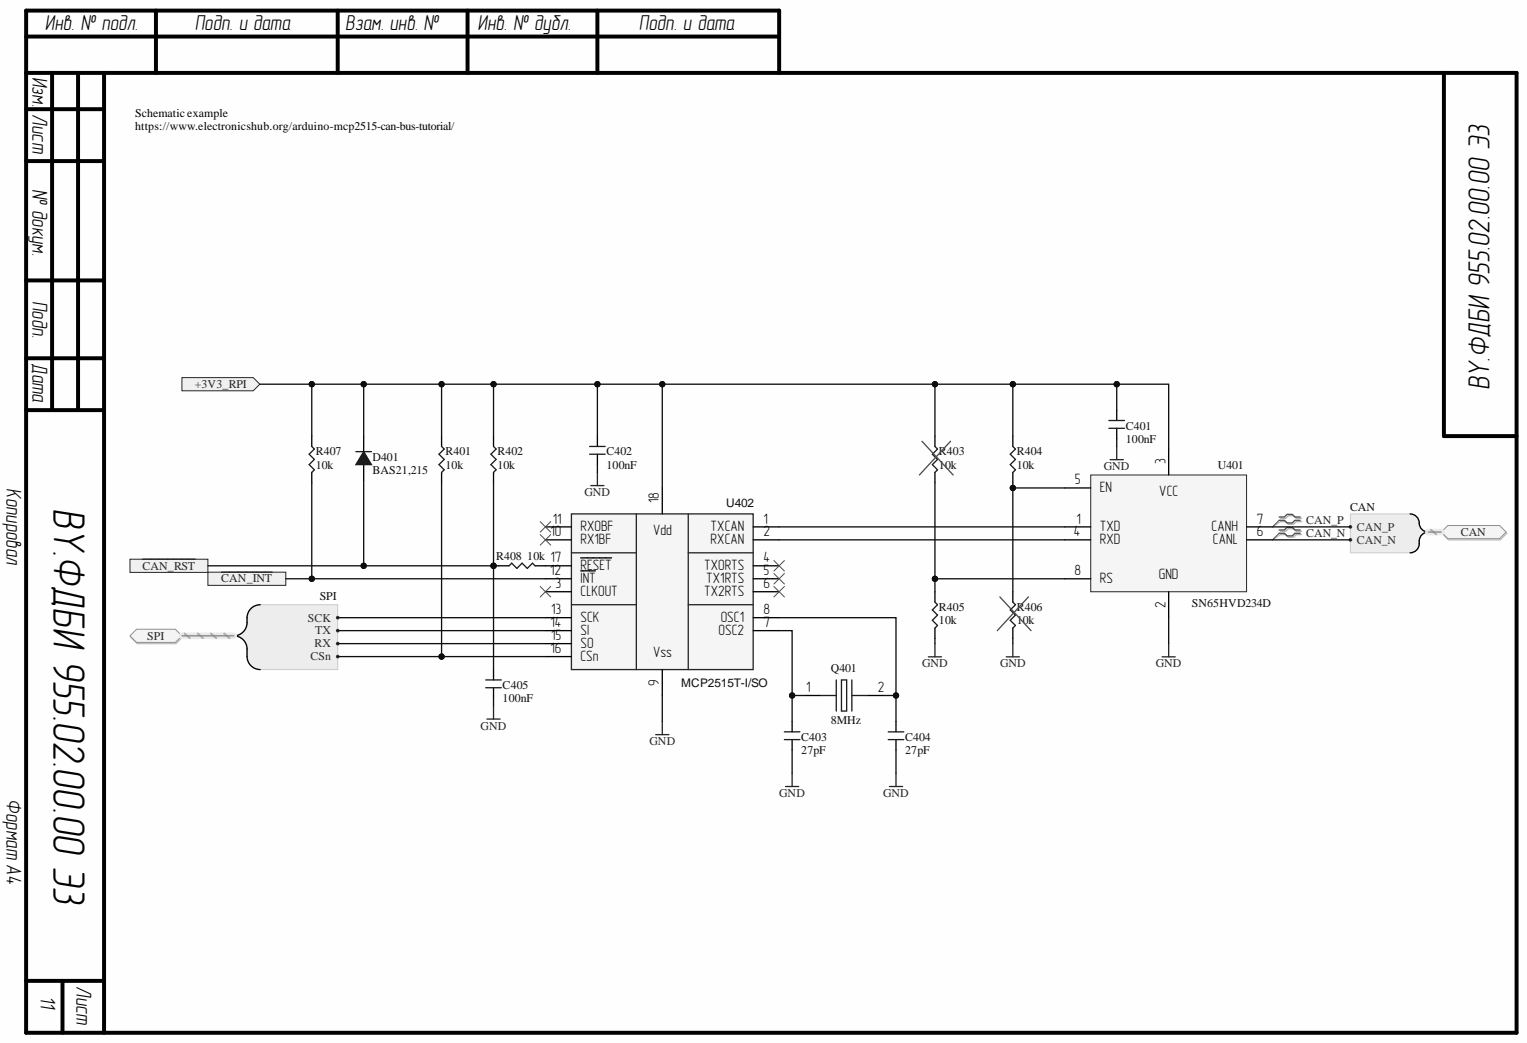
[picture p83: page 20]

№ докум. Лист Изм. Подп. Дата

RX0BF 11 RESET 17 INT 12 CLKOUT | | TXCAN TX0RTS TX1RTS TX2RTS | 1 Vss9 Vdd18

RXCA N | 2 RX1BF 10

SI 14 SCK 13 | OSC2
SO 15
