6haitandimon/BSUSat2_simulator/docs/КД_CМКА/СБ/BY.ФДБИ 955.04.00.00 СБ.pdf

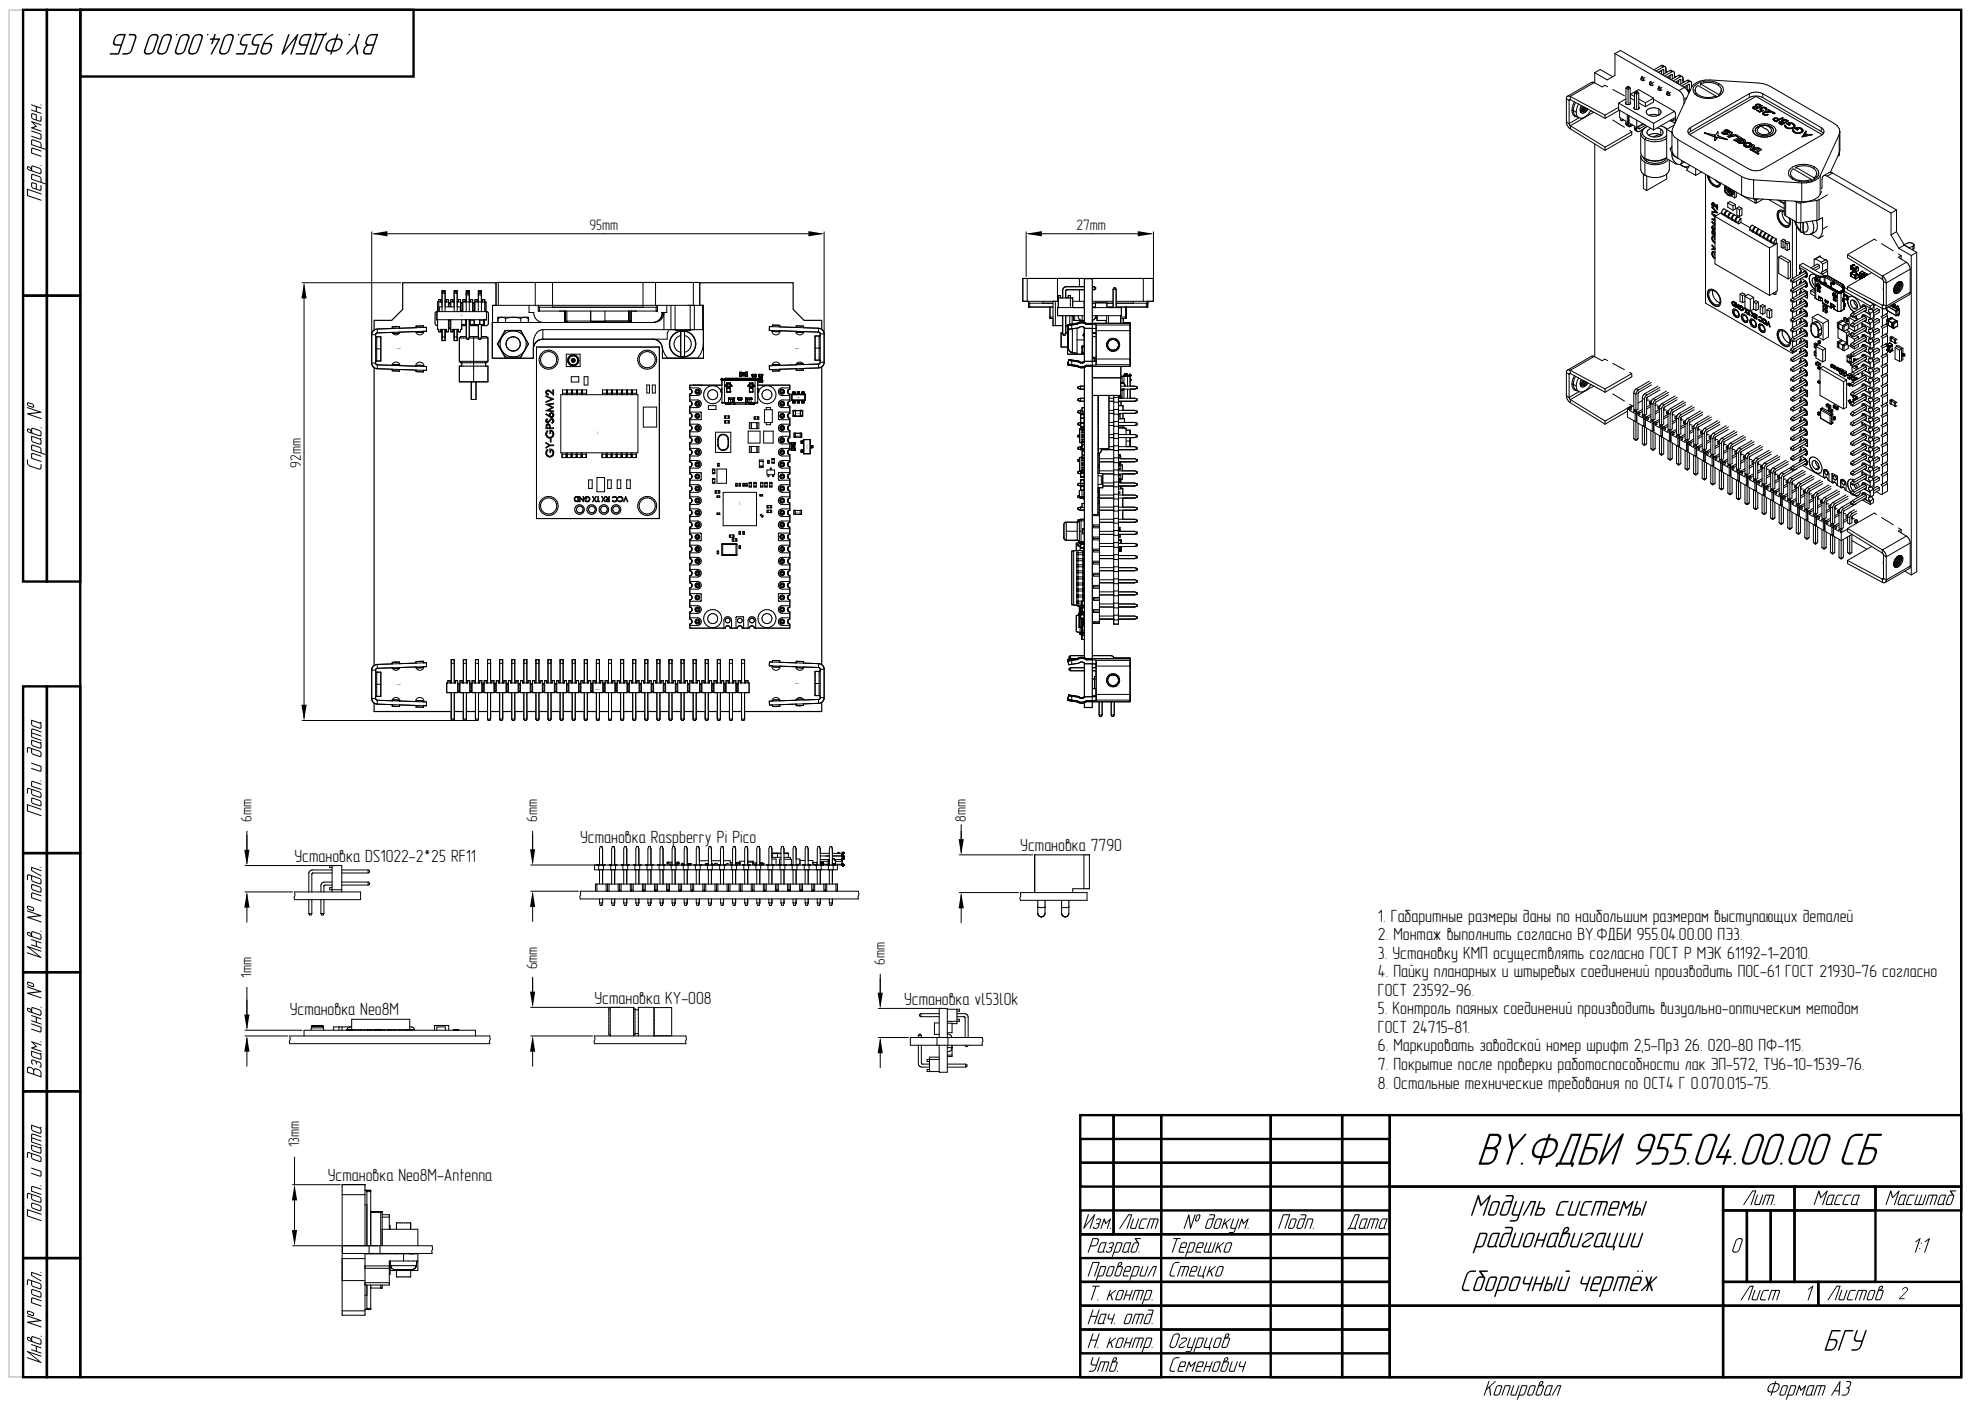
[picture p86: page 1]

Установка Raspberry Pi Pico

1. Габаритные размеры даны по наибольшим размерам выступающих деталей
2. Монтаж выполнить согласно BY.ФДБИ 955.04.00.00 ПЭ3.
3. Установку КМП осуществлять согласно ГОСТ Р МЭК 61192-1-2010.
4. Пайку планарных и штыревых соединений производить ПОС-61 ГОСТ 21930-76 согласно
ГОСТ 23592-96.
5. Контроль паяных соединений производить визуально-оптическим методом
ГОСТ 24715-81.
6. Маркировать заводской номер шрифт 2,5-Пр3 26. 020-80 ПФ-115.
7. Покрытие после проверки работоспособности лак ЭП-572, ТУ6-10-1539-76.
8. Остальные технические требования по ОСТ4 Г 0.070.015-75.

Вид сверху (Масштаб 2:1) | Вид снизу (Масштаб 2:1)

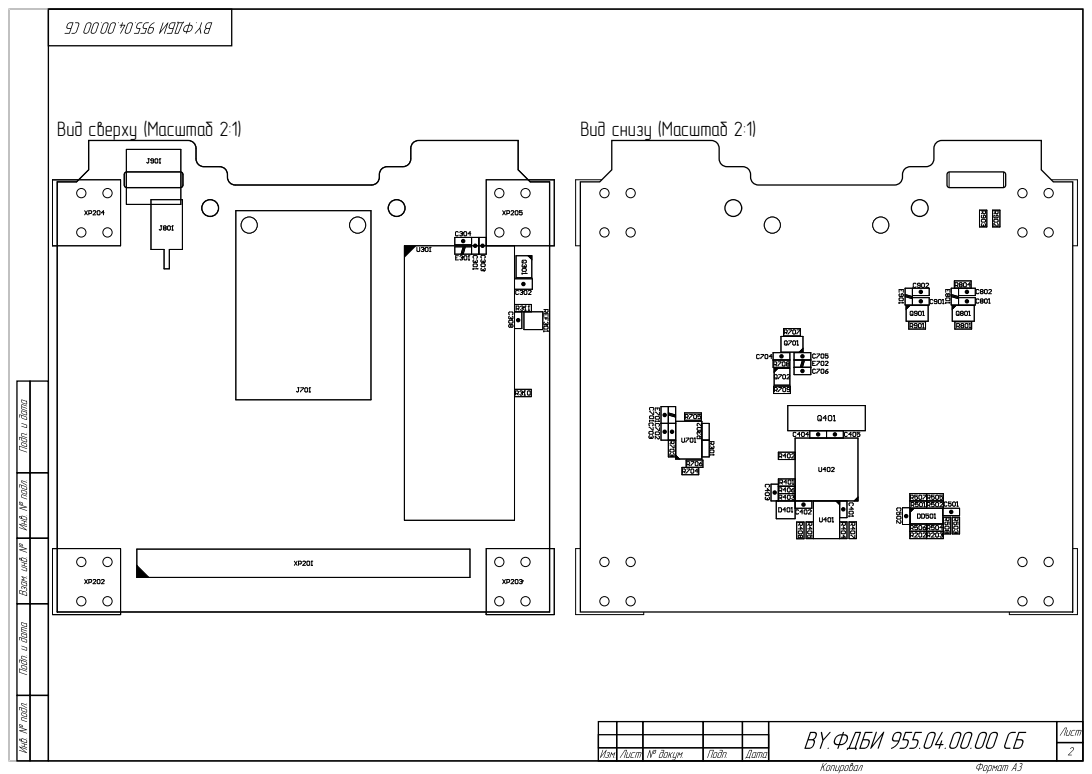
[picture p87: page 2]
