6haitandimon/BSUSat2_simulator/docs/КД_CМКА/Схемы/BY.ФДБИ 955.02.01.00 Э1_Э3.pdf

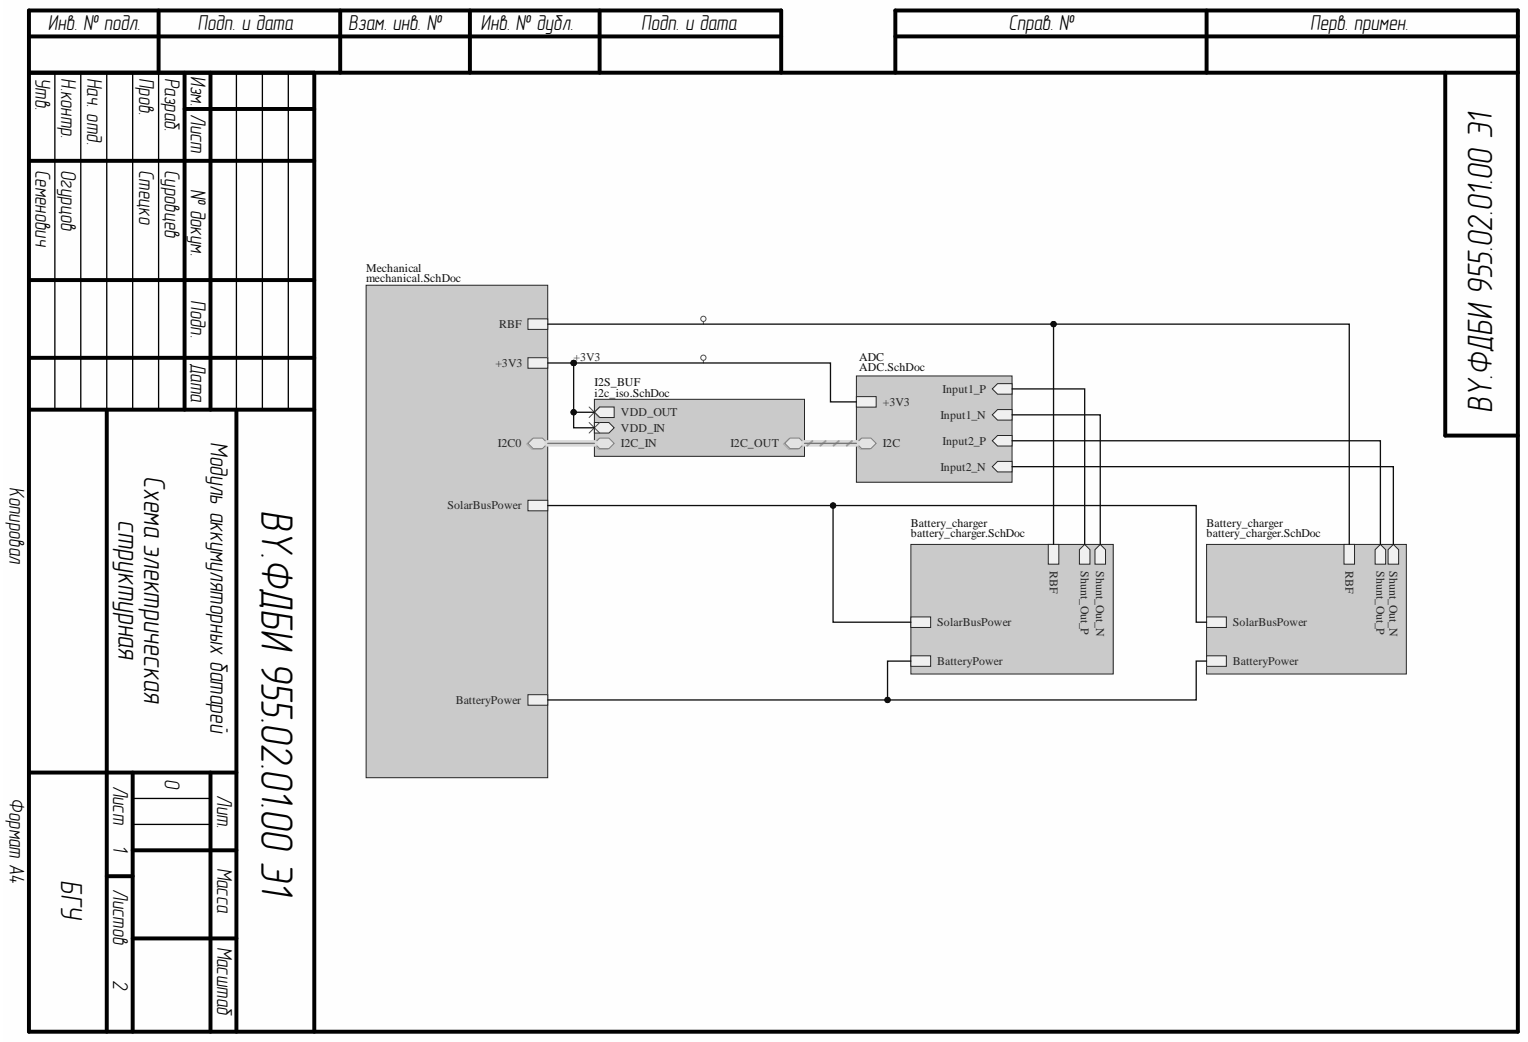
[picture p92: page 1]

I2S_BUF i2c_iso.SchDoc

VDD_OUT VDD_IN I2C_IN I2C_OUT

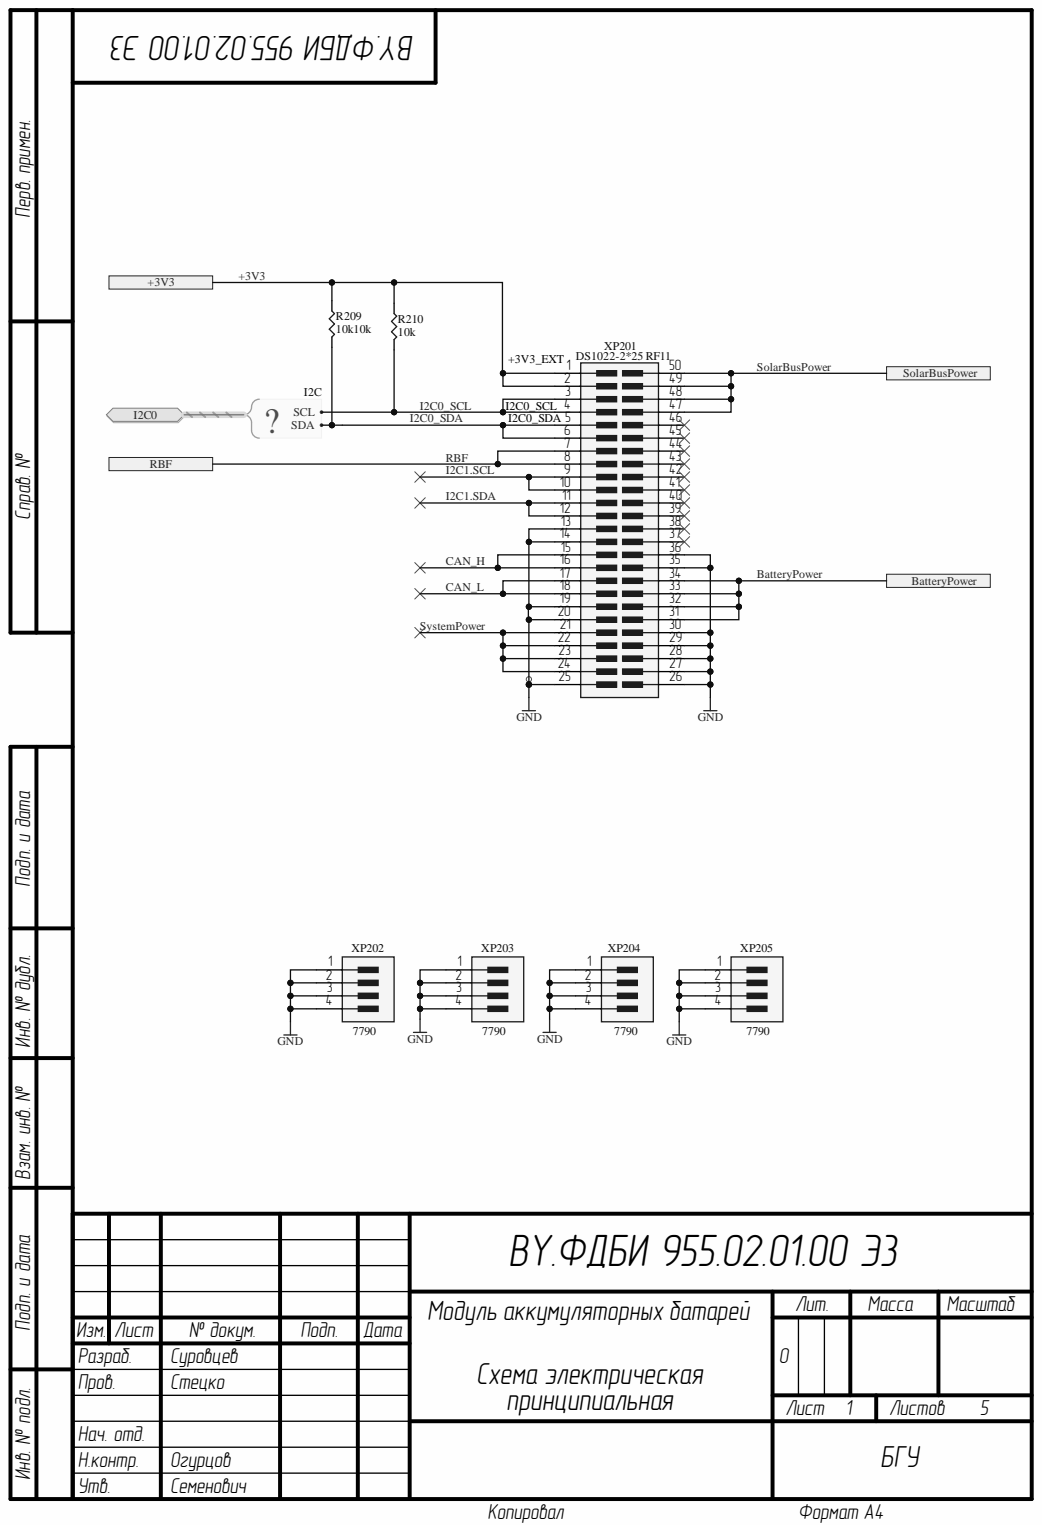
[picture p93: page 2]

BY.ФДБИ 955.02.01.00 Э3

Лит. | Масса | Масштаб

Изм. | Лист | № докум. | Подп. | Дата | | О
Разраб. | | Суровцев
Пров. | Стецко
Нач. отд. | | БГУ
Н.контр. | Огурцов
Утв. | Семенович

Лист | Листов 5

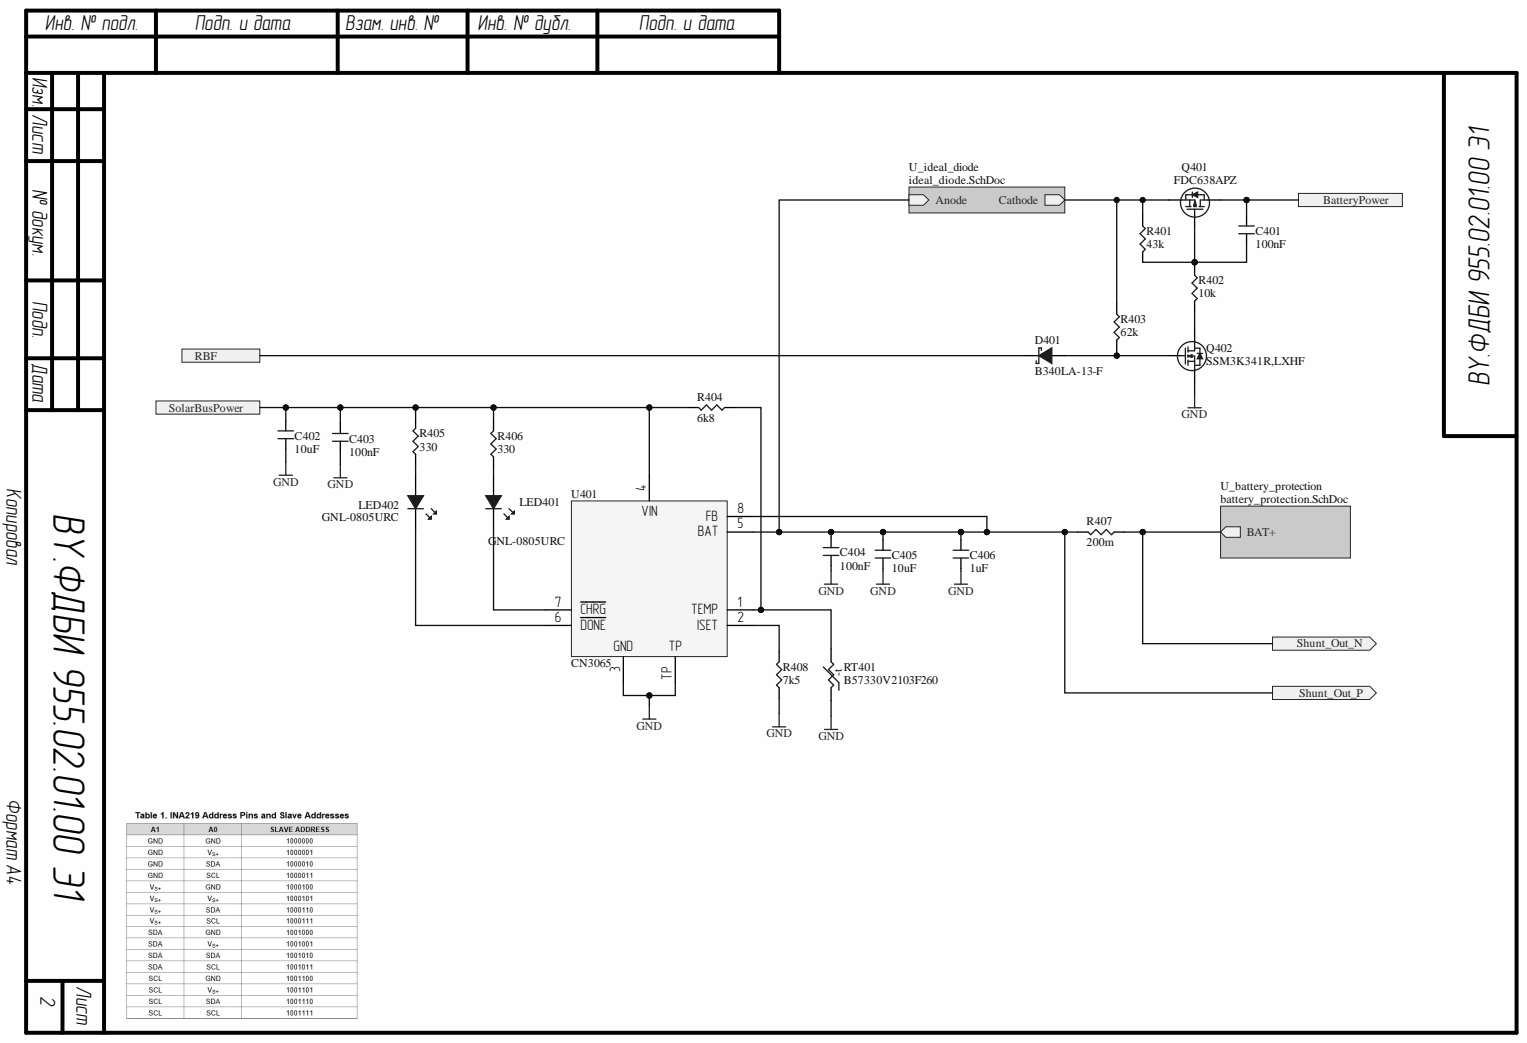
[picture p94: page 3]

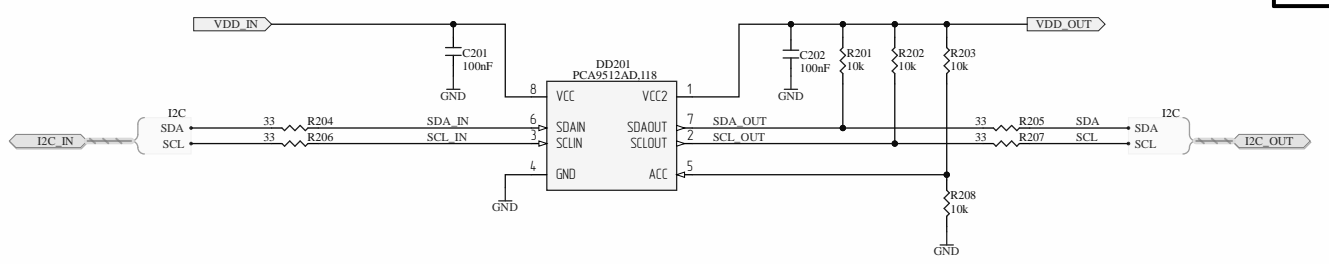
[picture p95: page 4]

№ докум. Лист Изм. Подп. Дата

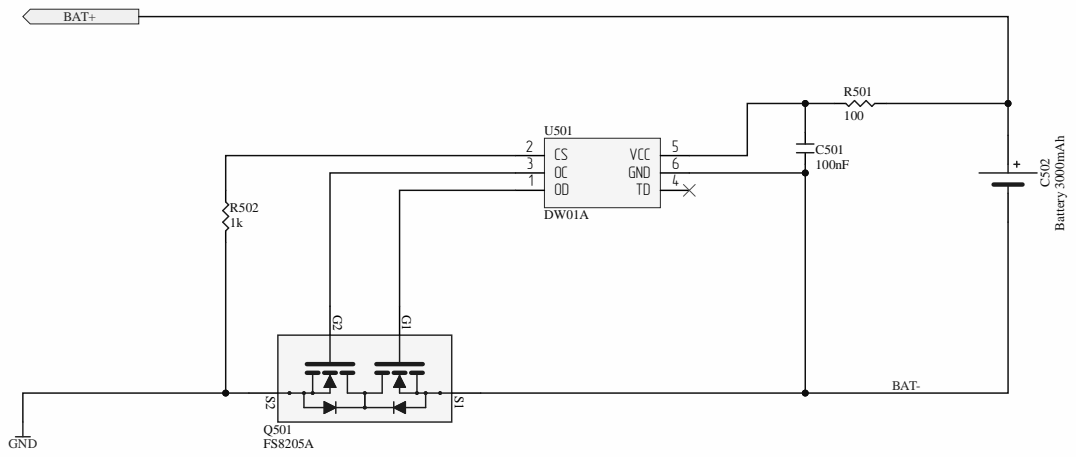
[picture p96: page 5]

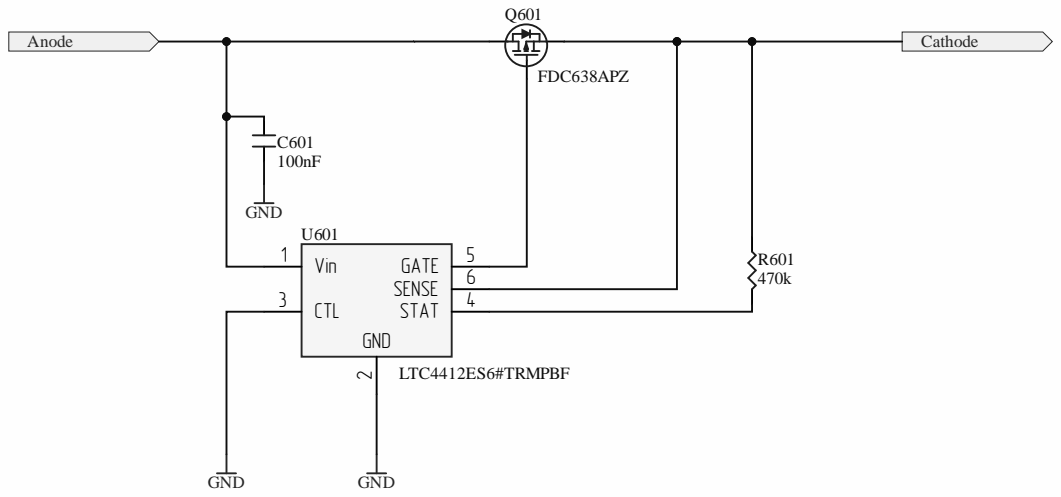
[picture p97: page 6]

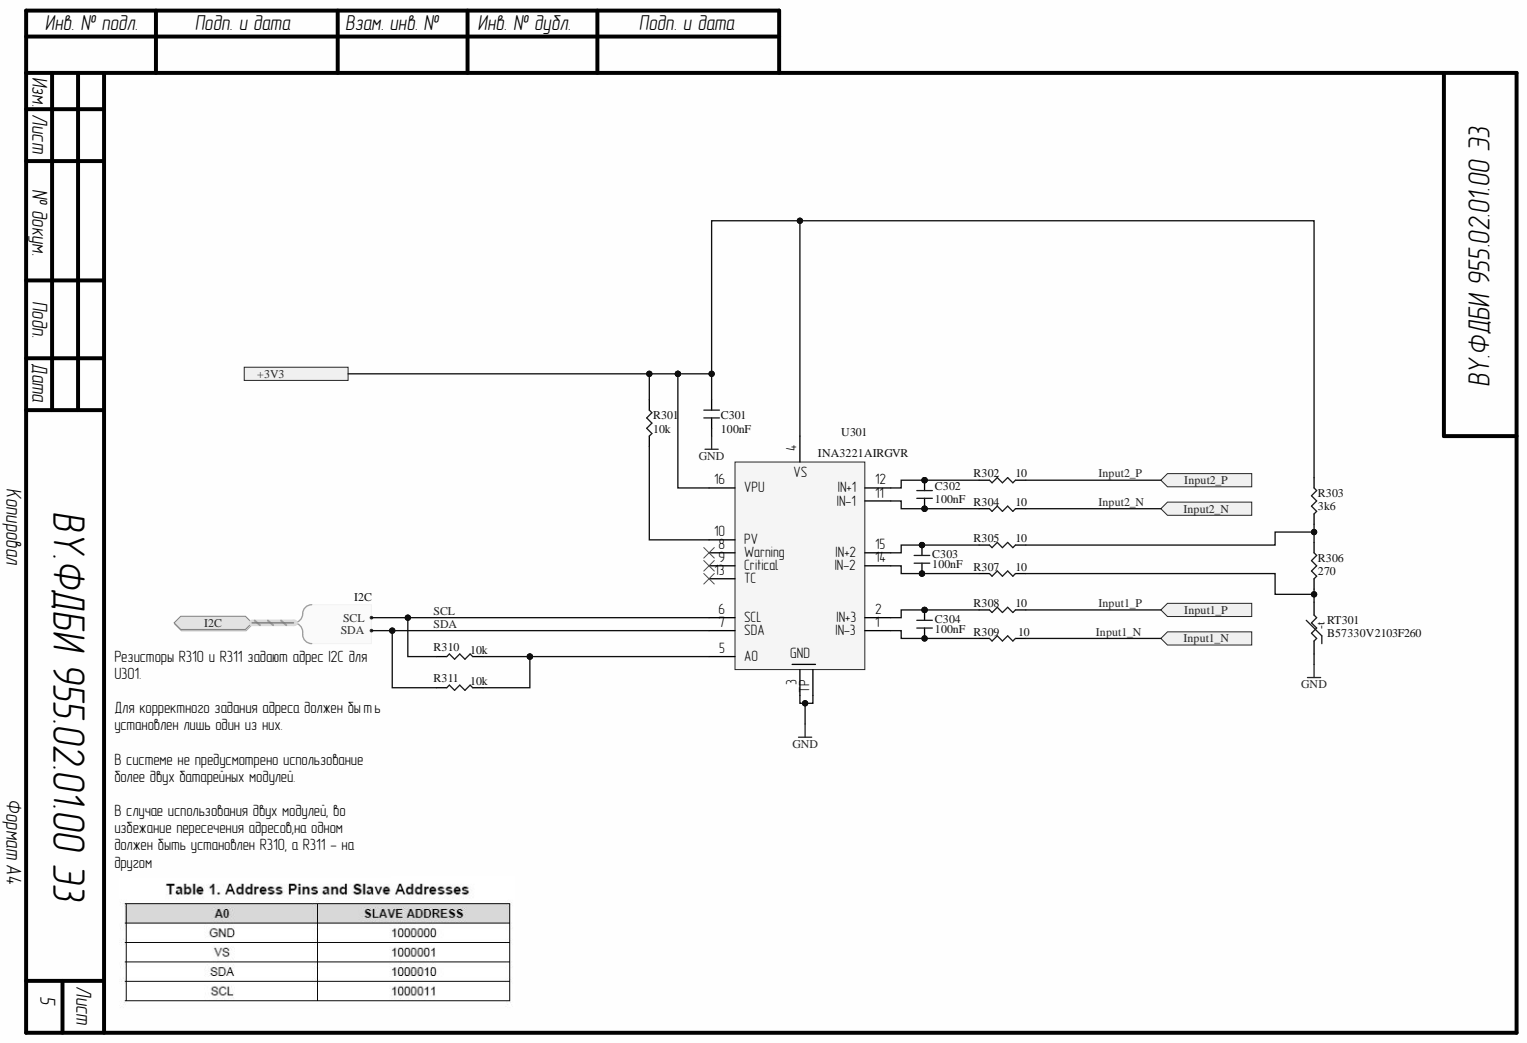
[picture p98: page 7]

№ докум. Лист Изм. Подп. Дата
