6haitandimon/BSUSat2_simulator/docs/КД_CМКА/Схемы/BY.ФДБИ 955.05.00.00 Э1_Э3.pdf

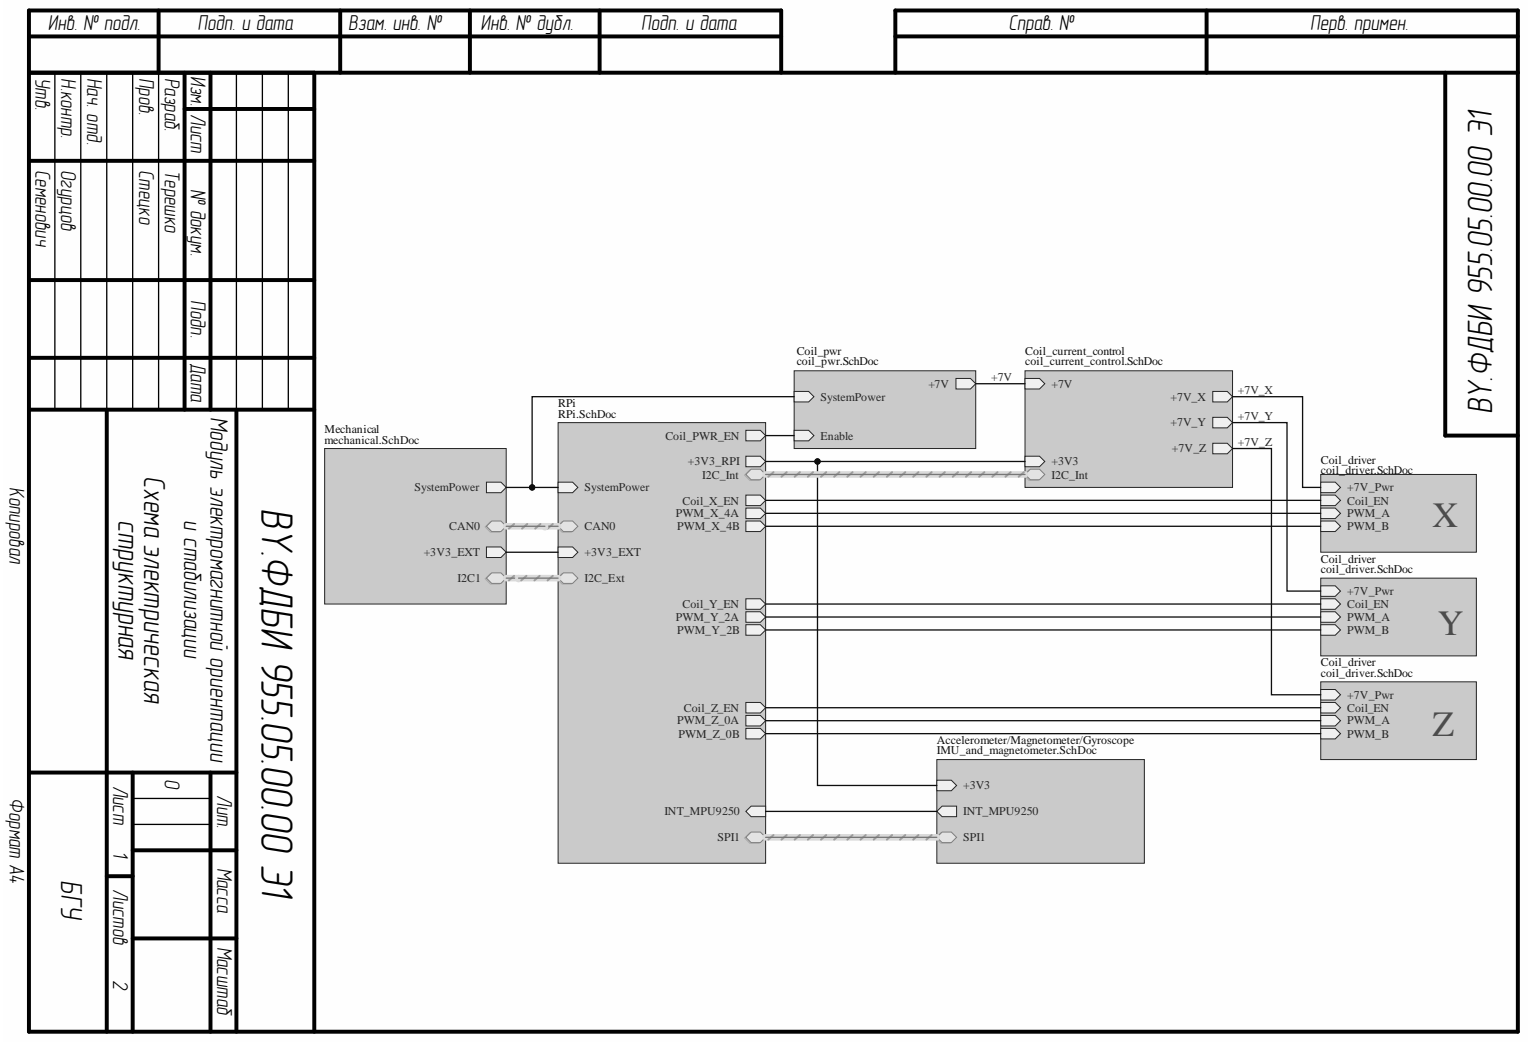
[picture p99: page 1]

Accelerometer/Magnetometer/Gyroscope IMU_and_magnetometer.SchDoc

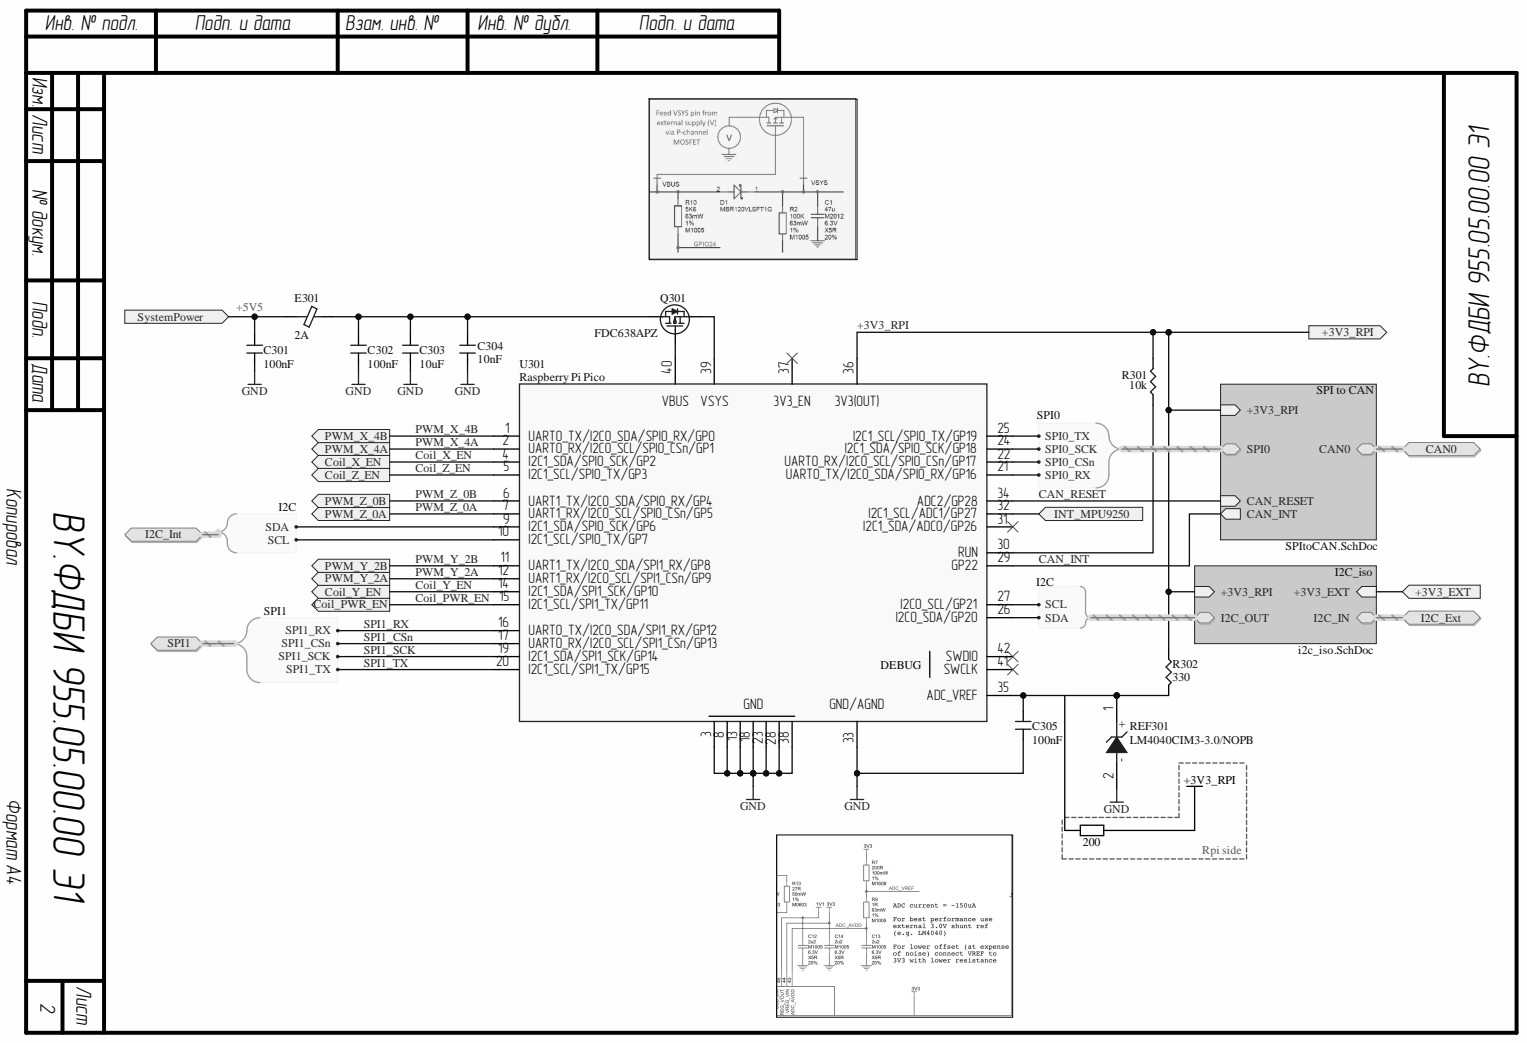
[picture p100: page 2]

№ докум. Лист Изм. Подп. Дата

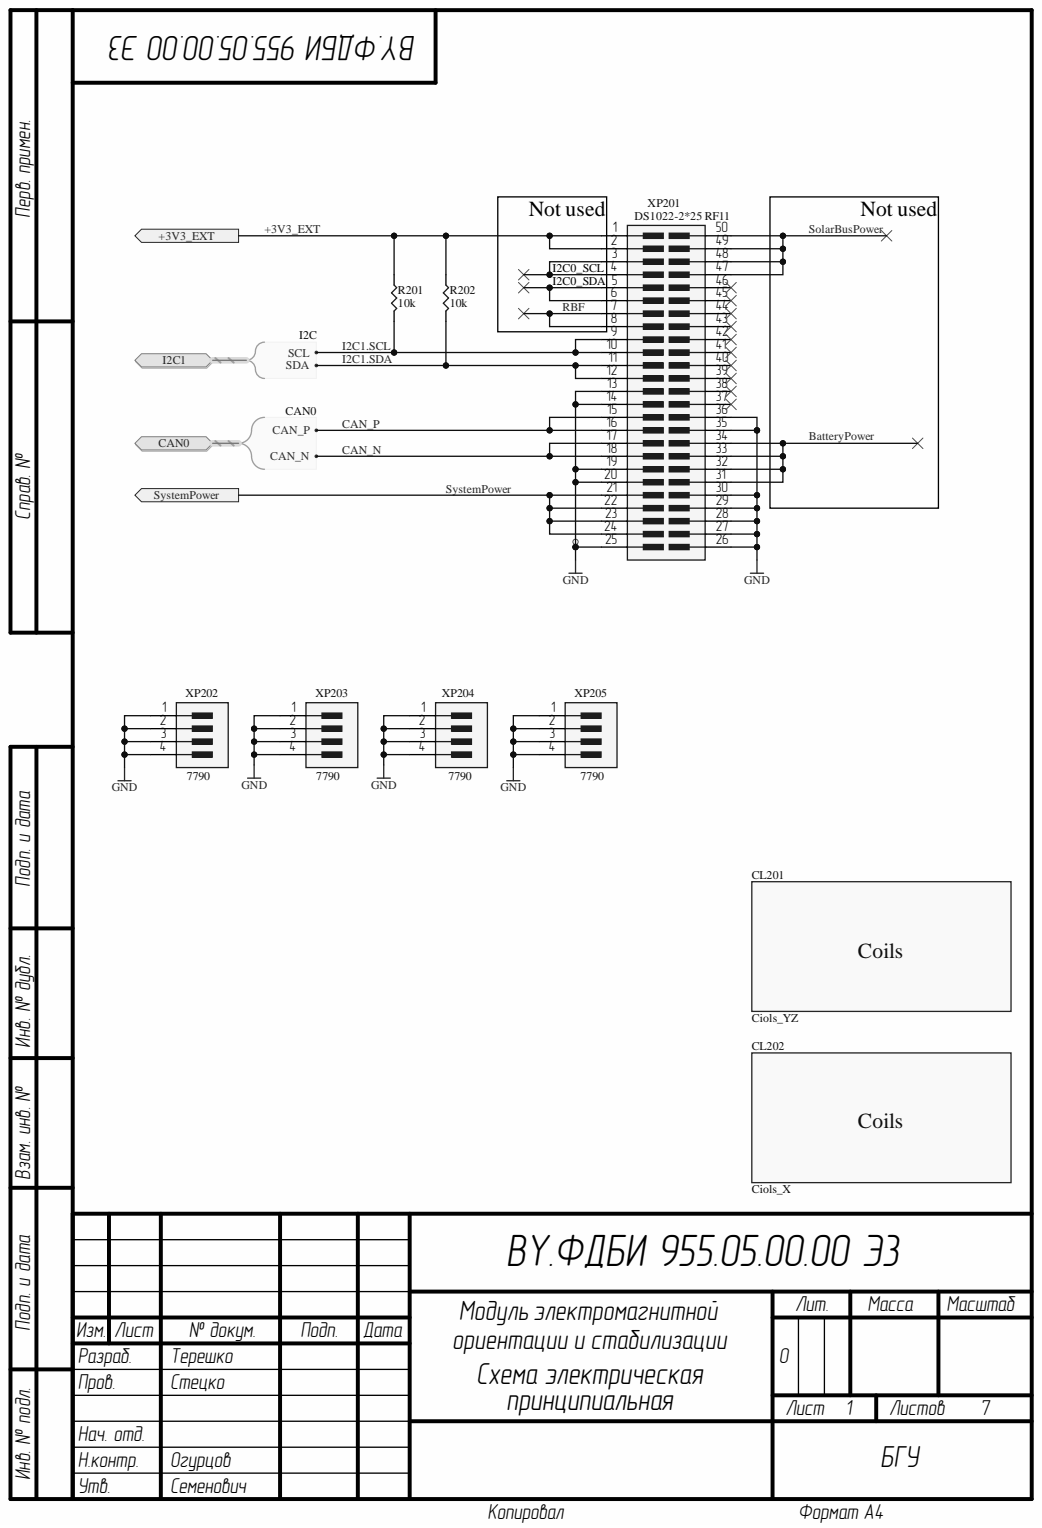
[picture p101: page 3]

BY.ФДБИ 955.05.00.00 Э3

Лит. | Масса | Масштаб

Изм. | Лист | № докум. | Подп. | Дата | | О
Разраб. | | Терешко
Пров. | Стецко
Нач. отд. | | БГУ
Н.контр. | Огурцов
Утв. | Семенович

Лист | Листов 7

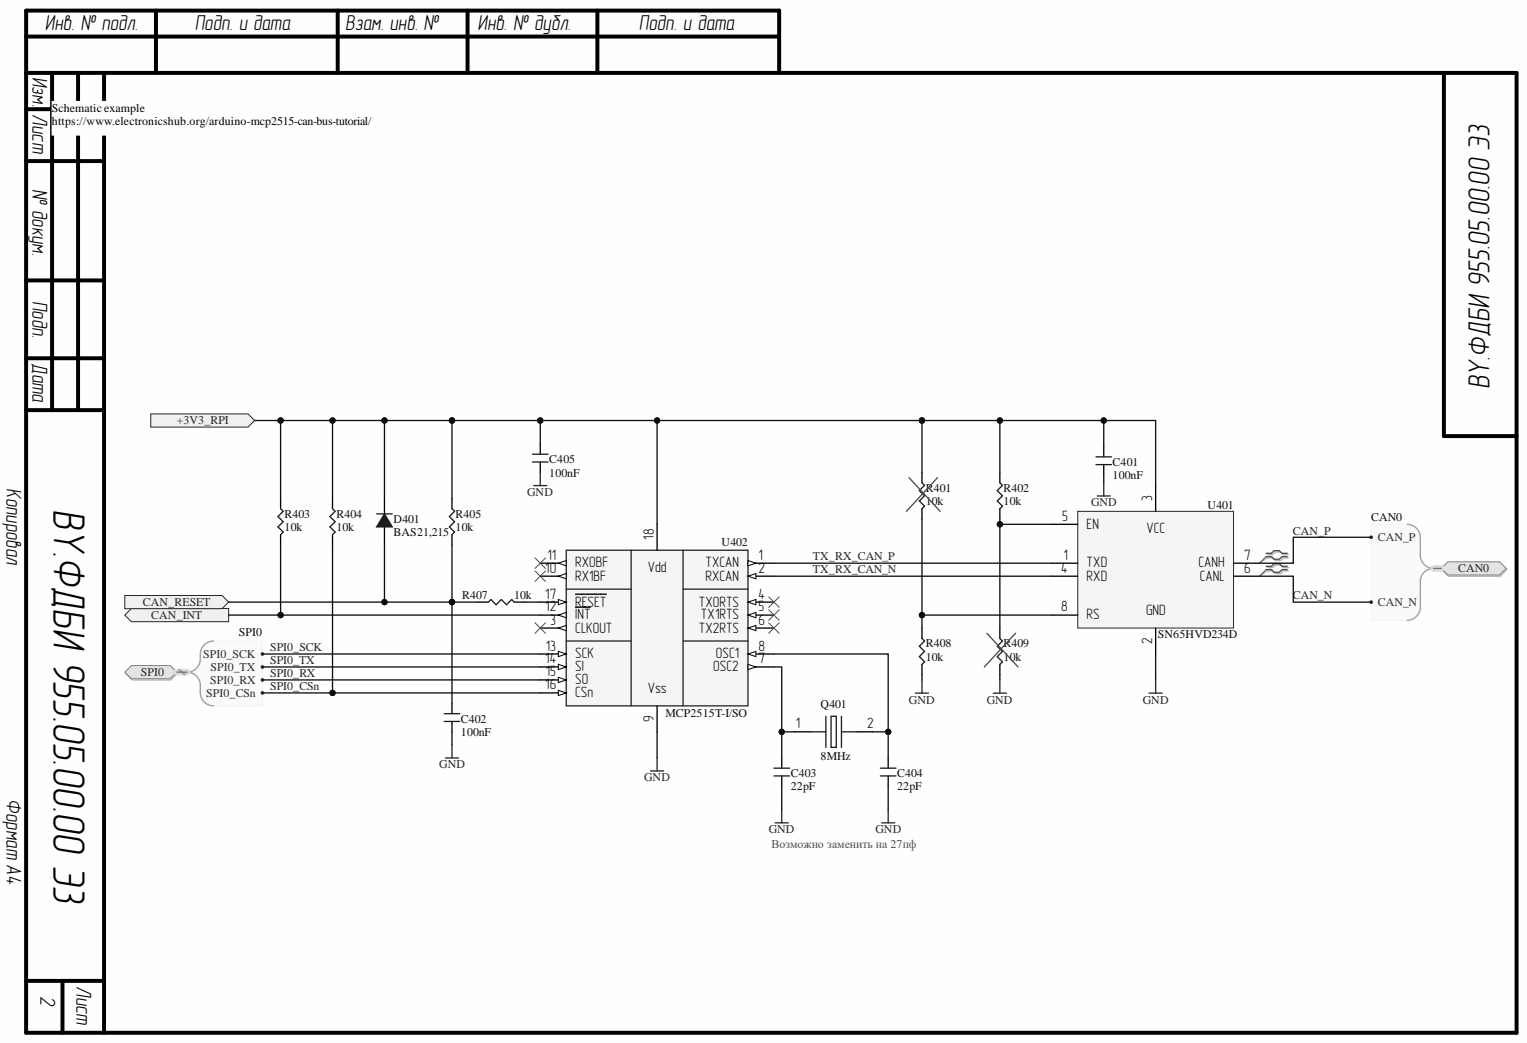
[picture p102: page 4]

№ докум. Лист Изм. Подп. Дата

Schemat | ic examp | l e w.electro n ics h u b.org /ard u i n o-mcp 2 5 1 5 -c an -b u s -tu t o ri al/
h t t p s | : / / w w

RXCA N | 2 RX1BF 10

RX0BF 11 RESET 17 INT 12 CLKOUT | TXCAN TX0RTS TX1RTS TX2RTS | 1 Vss9 Vdd18

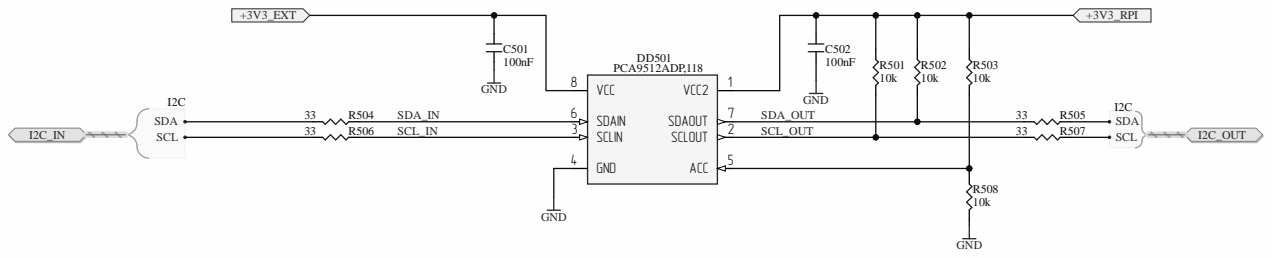
[picture p103: page 5]

№ докум. Лист Изм. Подп. Дата

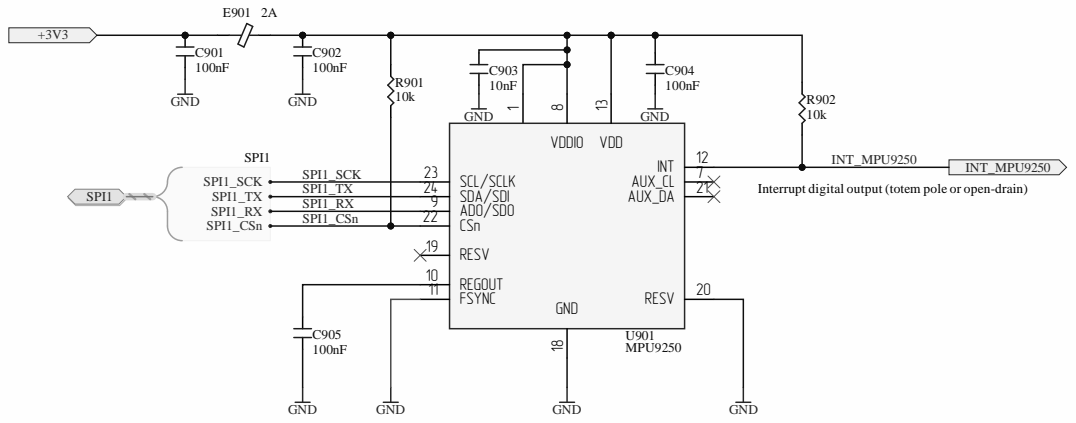
[picture p104: page 6]

Interrupt digital output (totem pole or open-drain)

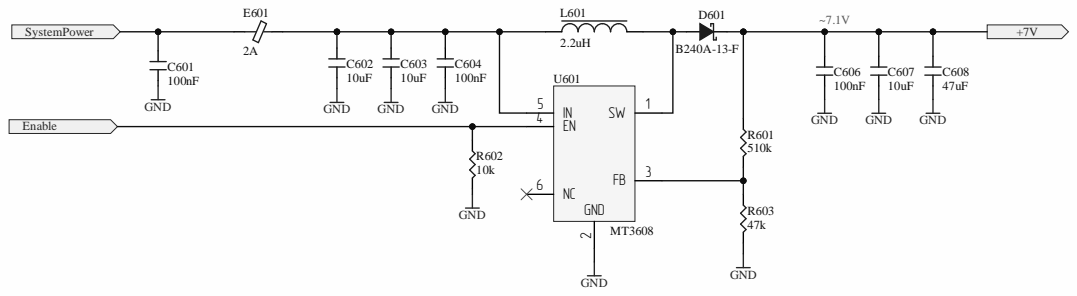
[picture p105: page 7]

№ докум. Лист Изм. Подп. Дата

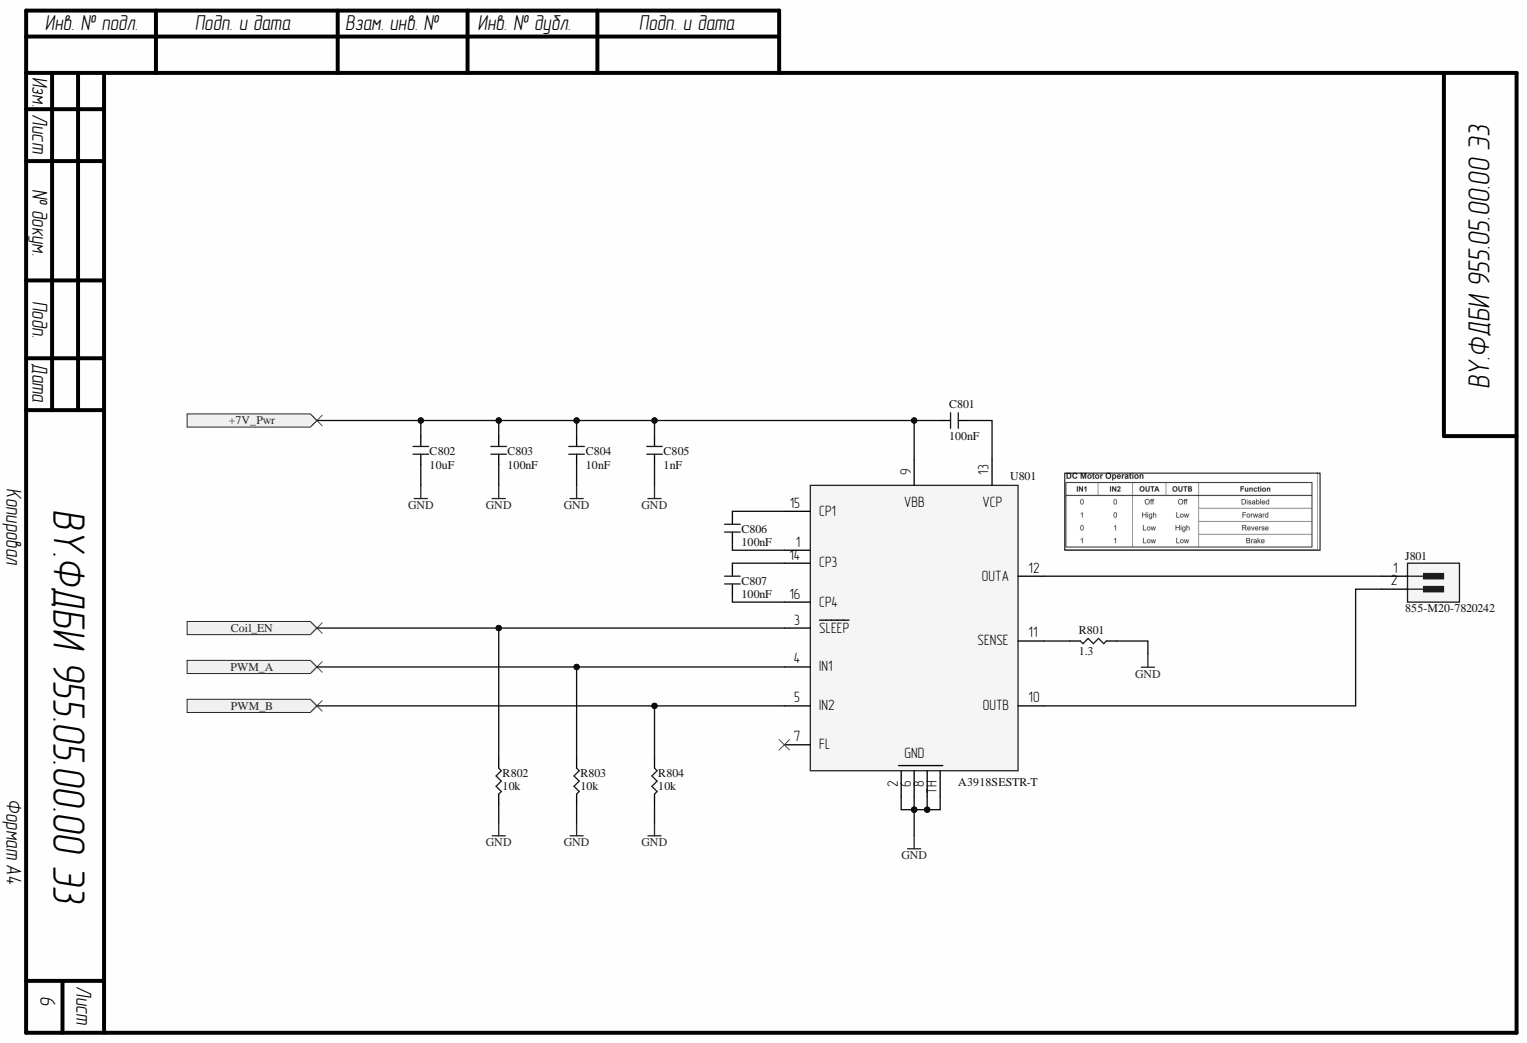
[picture p106: page 8]

№ докум. Лист Изм. Подп. Дата

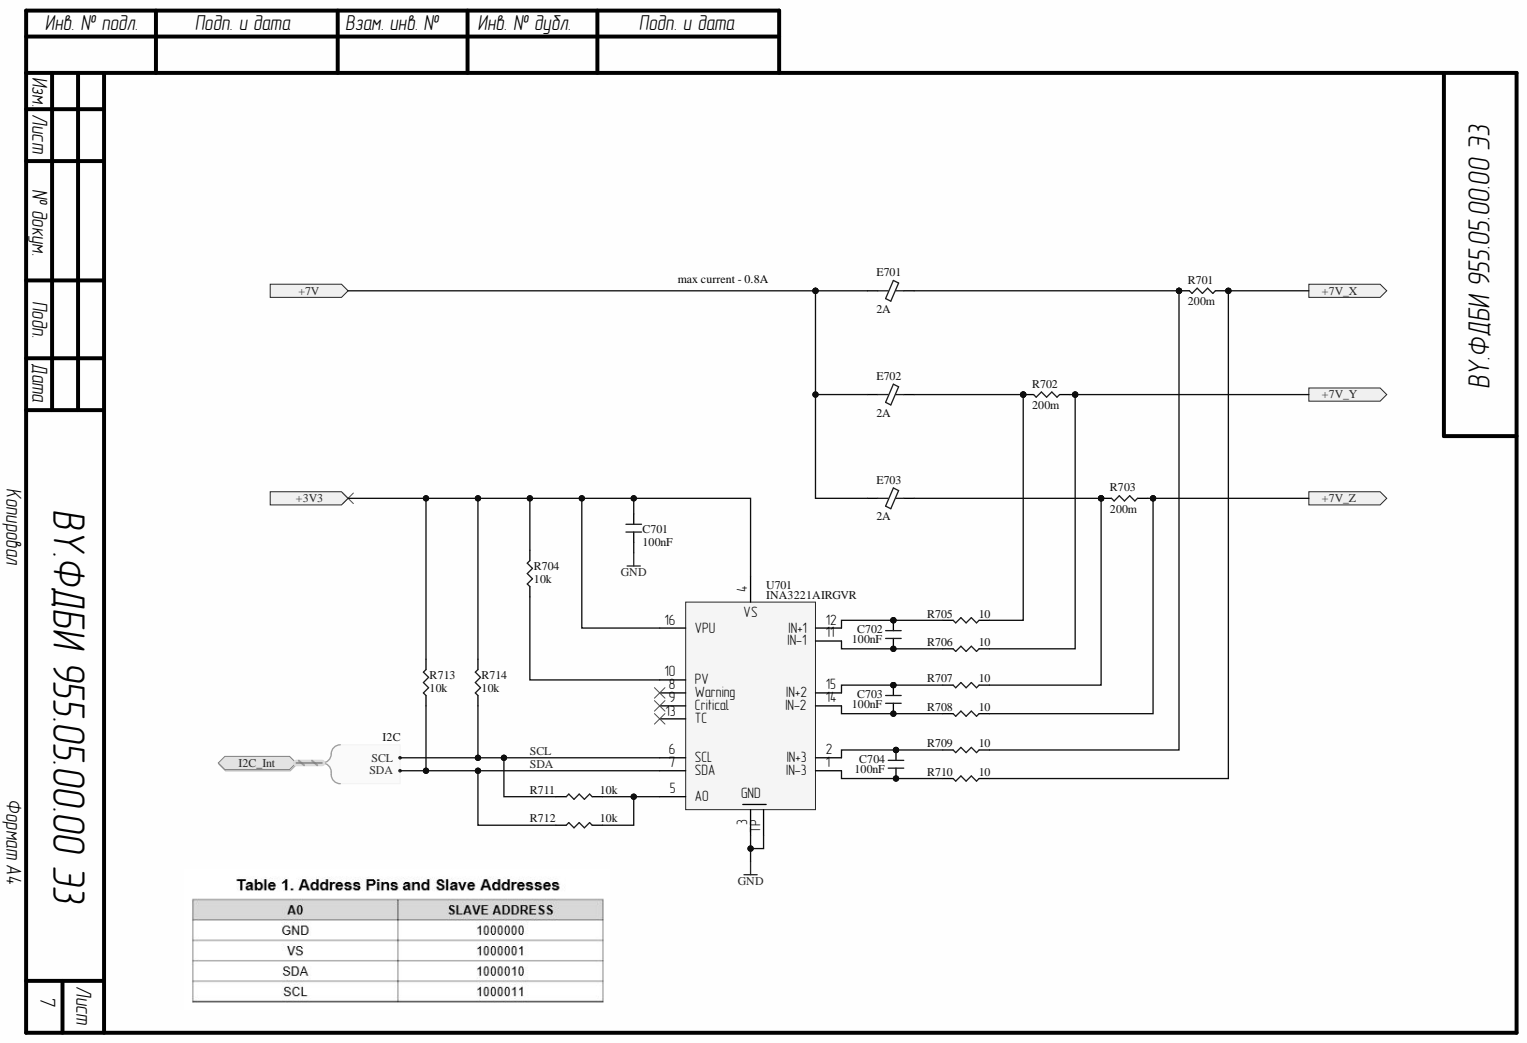
[picture p107: page 9]
