6haitandimon/BSUSat2_simulator/docs/КД_CМКА/Схемы/BY.ФДБИ 955.06.00.00 Э1-Э3.pdf

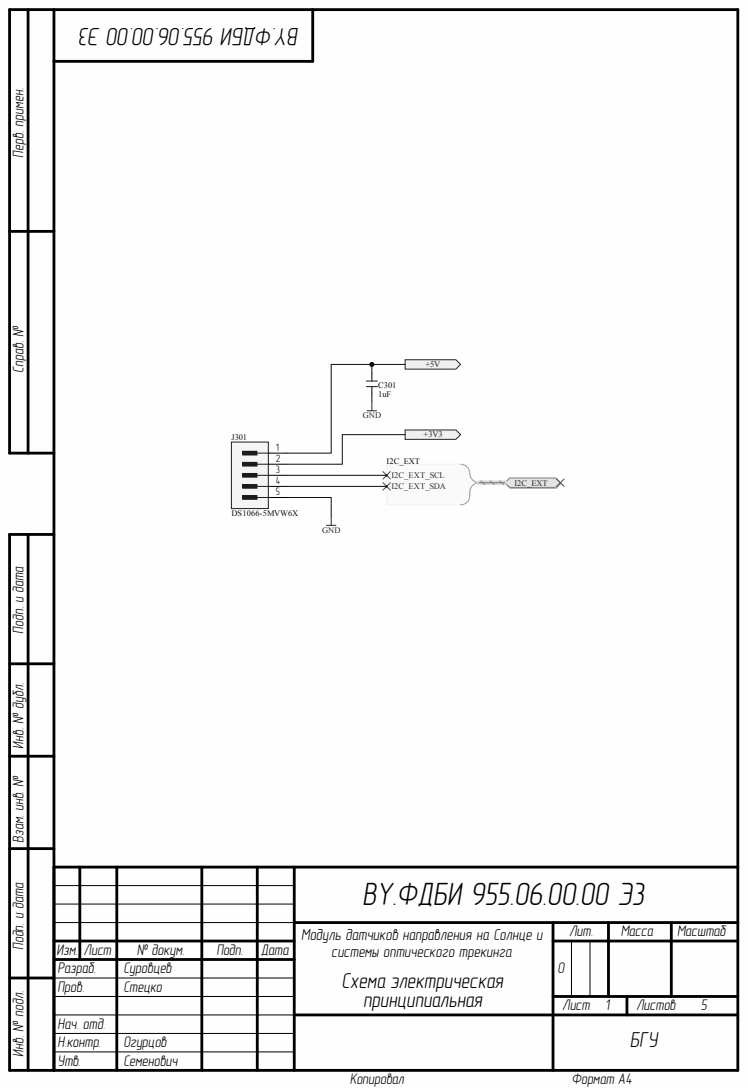
[picture p108: page 1]

BY.ФДБИ 955.06.00.00 Э3

Лит. | Масса | Масштаб

Модуль датчиков направления на Солнце и
системы оптического трекинга
Схема электрическая
принципиальная

Изм. | Лист | № докум. | Подп. | Дата | | О
Разраб. | | Суровцев
Пров. | Стецко
Нач. отд. | | БГУ
Н.контр. | Огурцов
Утв. | Семенович

Лист | Листов 5

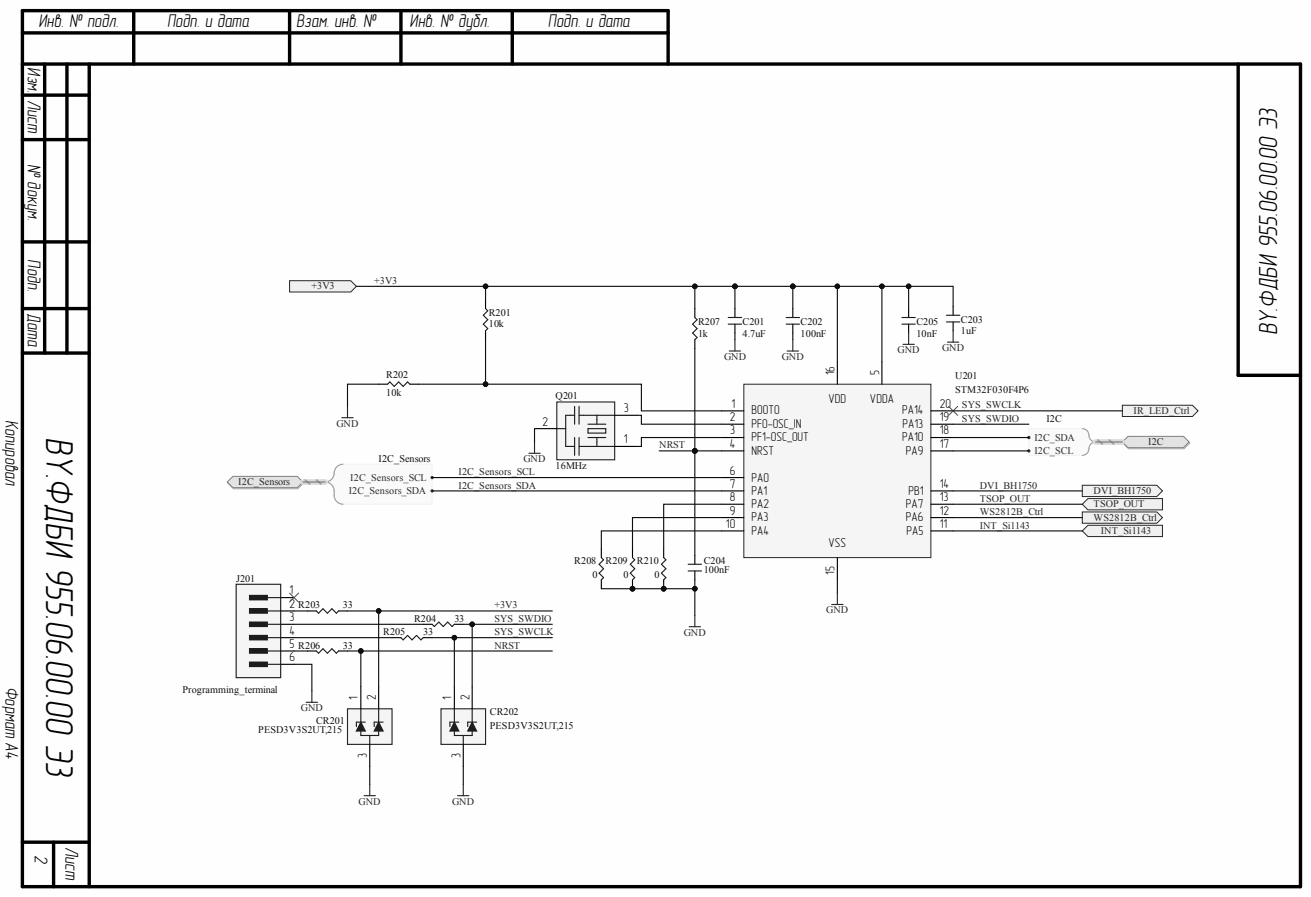
[picture p109: page 2]

PF1aOSC_OUT 3

NRST | | NRST 4

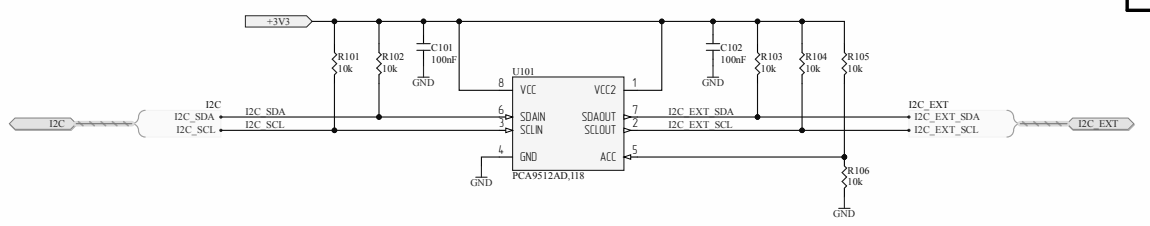
[picture p110: page 3]

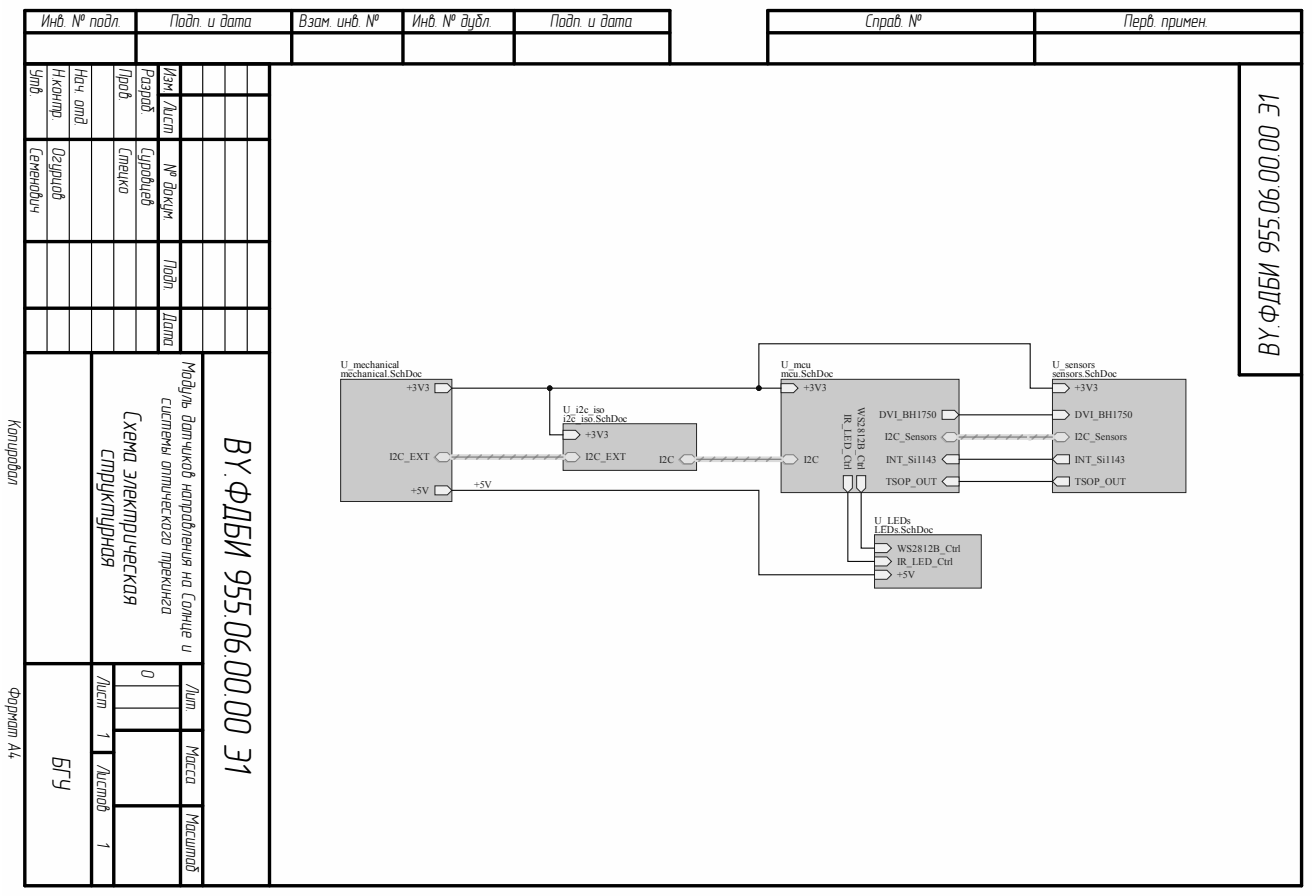
[picture p111: page 4]

Модуль датчиков направления на Солнце и

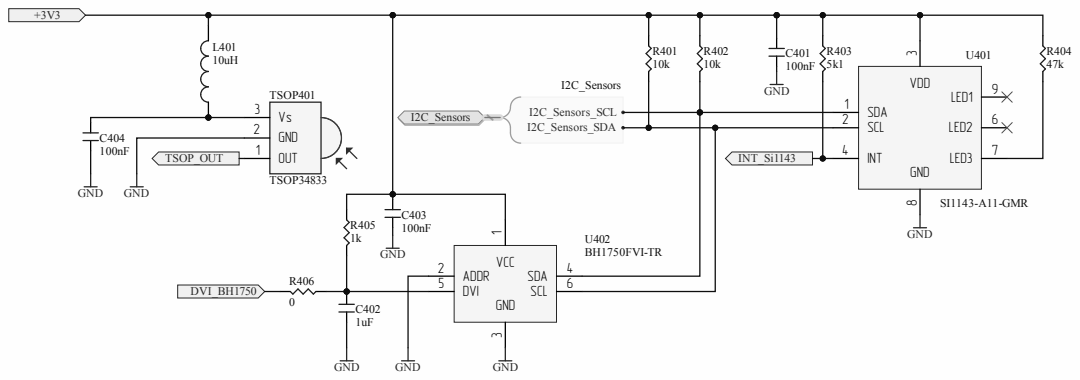
[picture p112: page 5]

GND

SCL 2

GND 2

TSOP_OUT | OUT 1

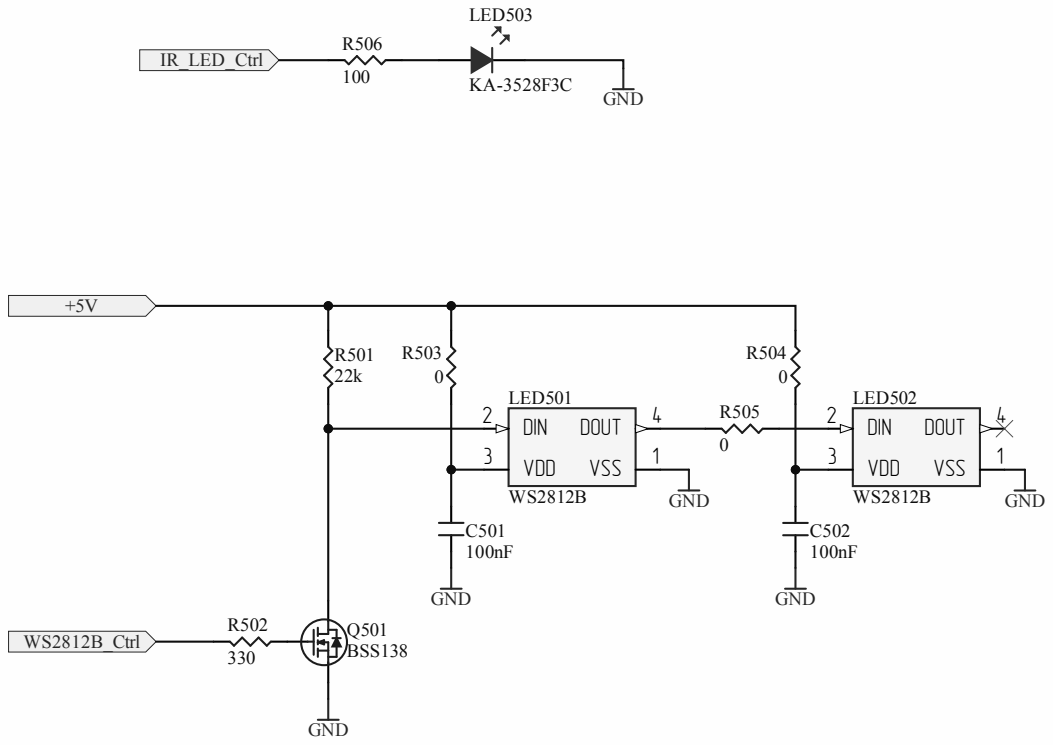
[picture p113: page 6]
