6haitandimon/BSUSat2_simulator/docs/КД_CМКА/Схемы/BY.ФДБИ 955.07.00.00 Э1_Э3.pdf

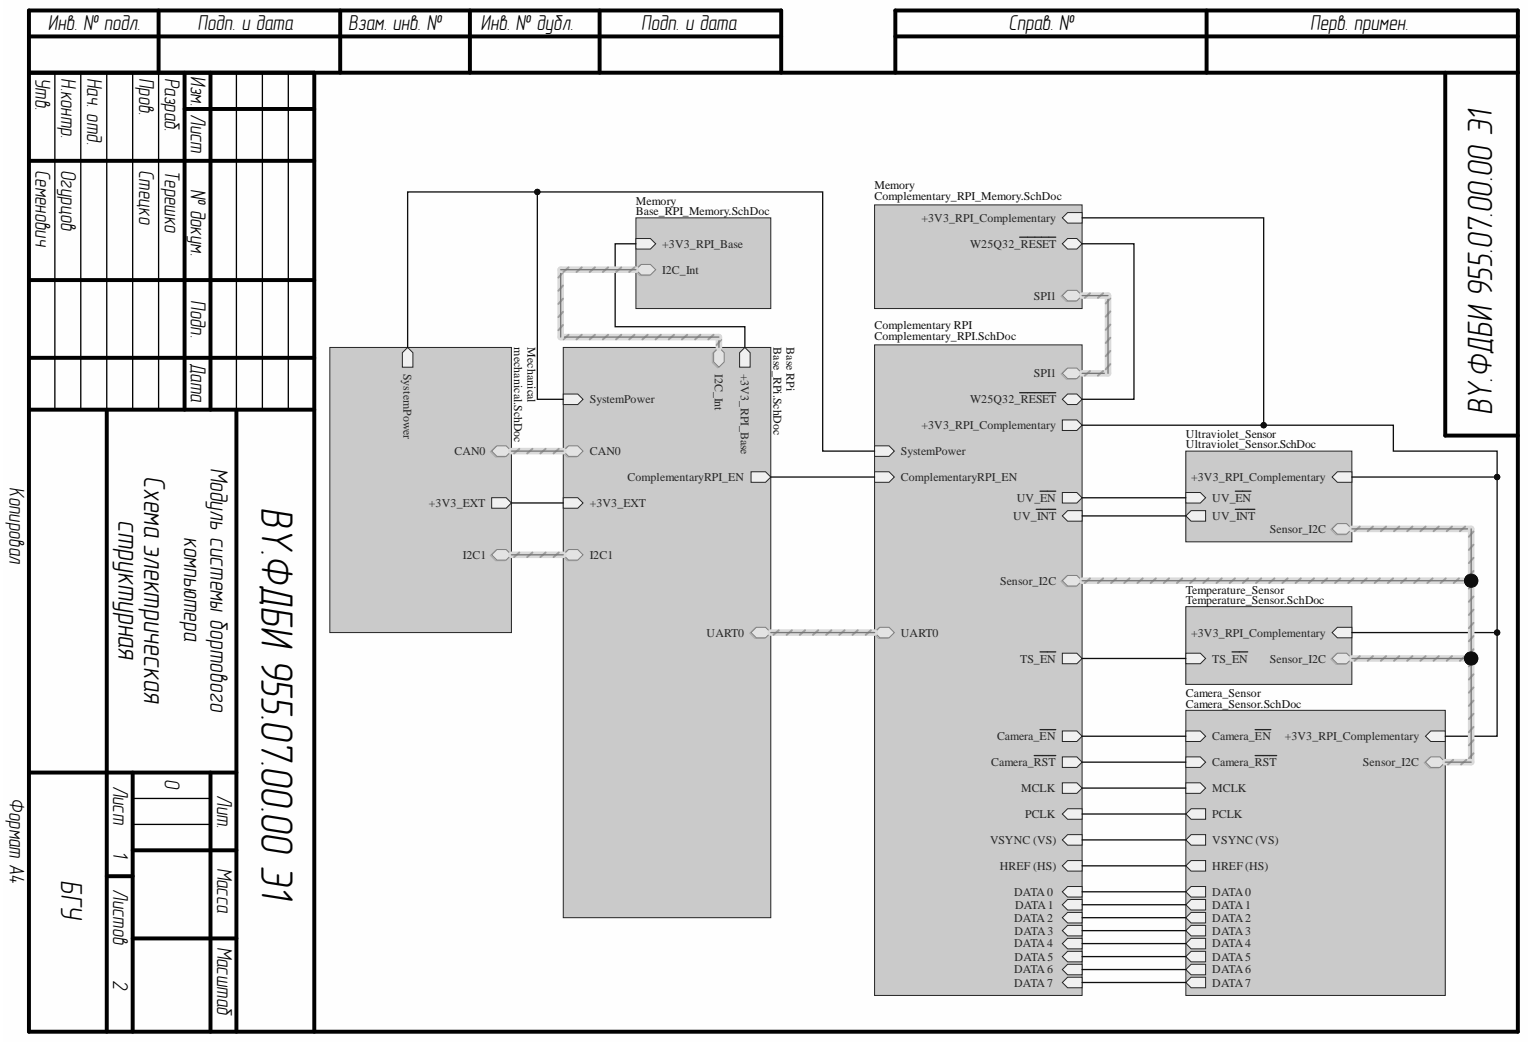
[picture p114: page 1]

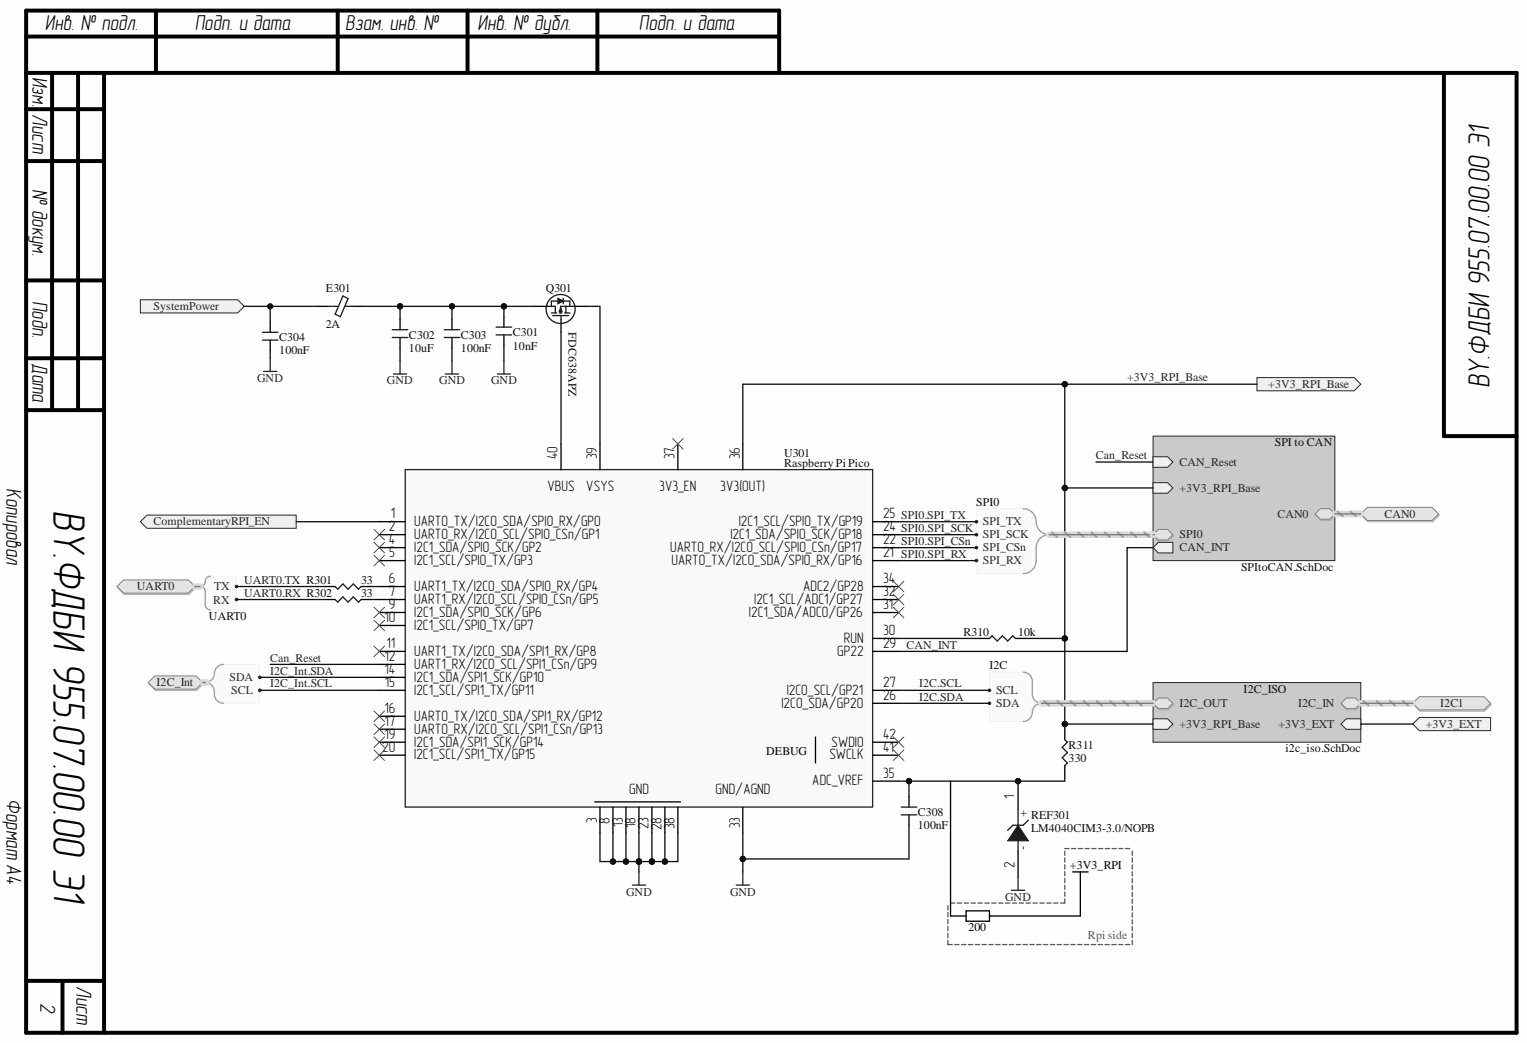
[picture p115: page 2]

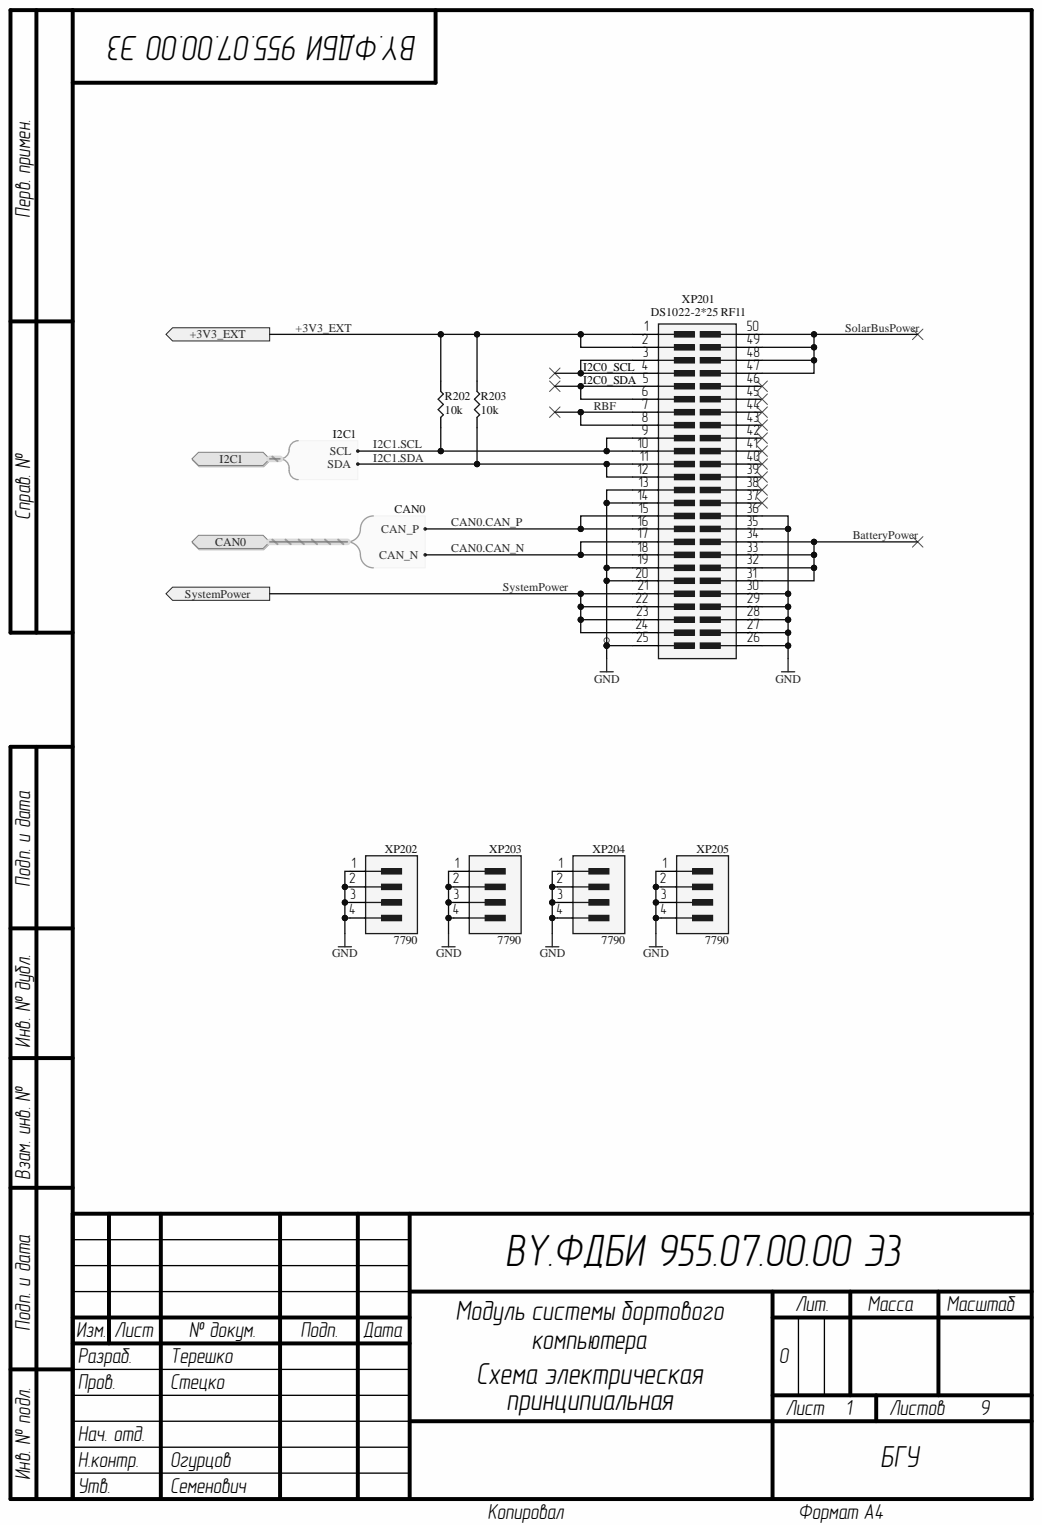
[picture p116: page 3]

BY.ФДБИ 955.07.00.00 Э3

Лит. | Масса | Масштаб

Изм. | Лист | № докум. | Подп. | Дата | | О
Разраб. | | Терешко
Пров. | Стецко
Нач. отд. | | БГУ
Н.контр. | Огурцов
Утв. | Семенович

Лист | Листов 9

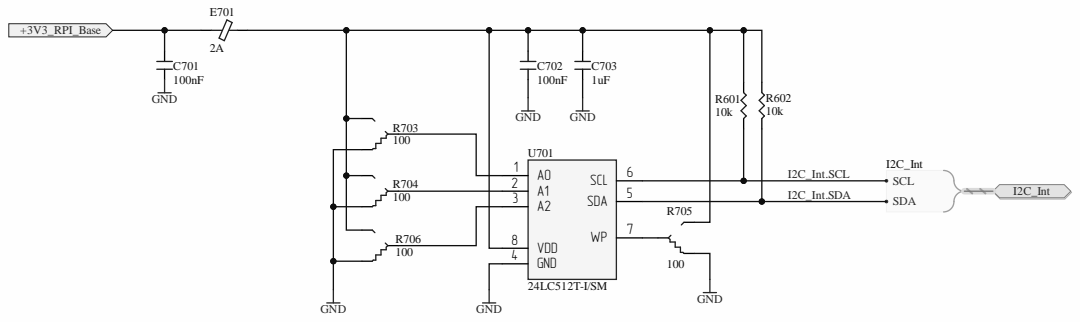
[picture p117: page 4]

№ докум. Лист Изм. Подп. Дата

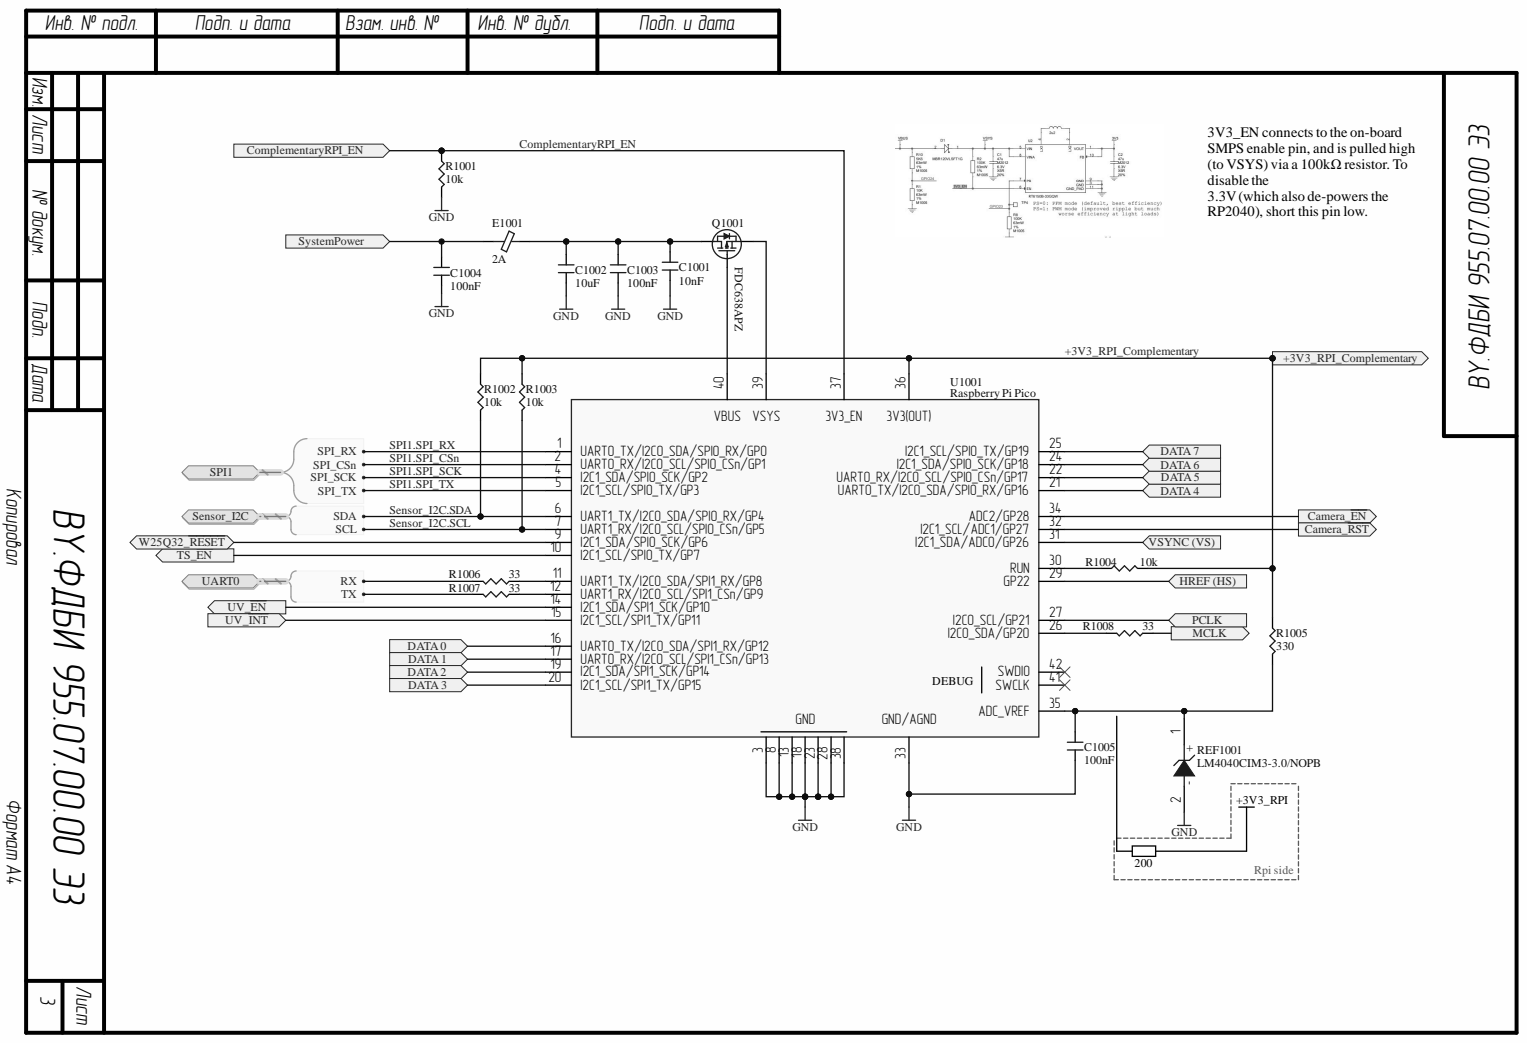
[picture p118: page 5]

3V3_EN connects to the on-board
SMPS enable pin, and is pulled high
(to VSYS) via a 100kΩ resistor. To
disable the
3.3V(which also de-powers the
RP2040), short this pin low.

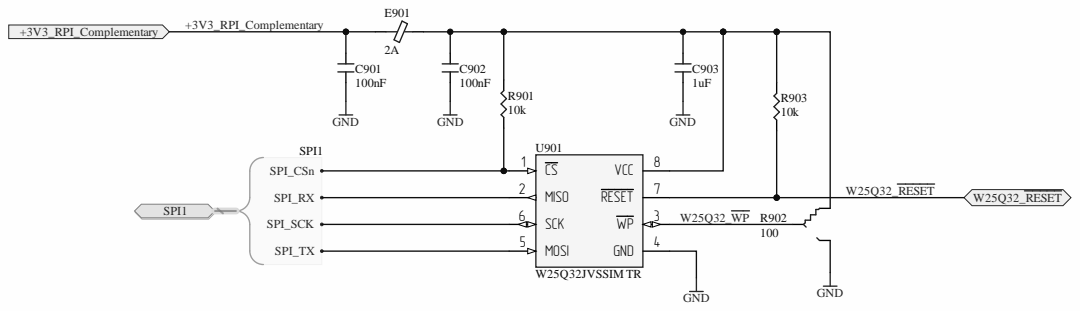
[picture p119: page 6]

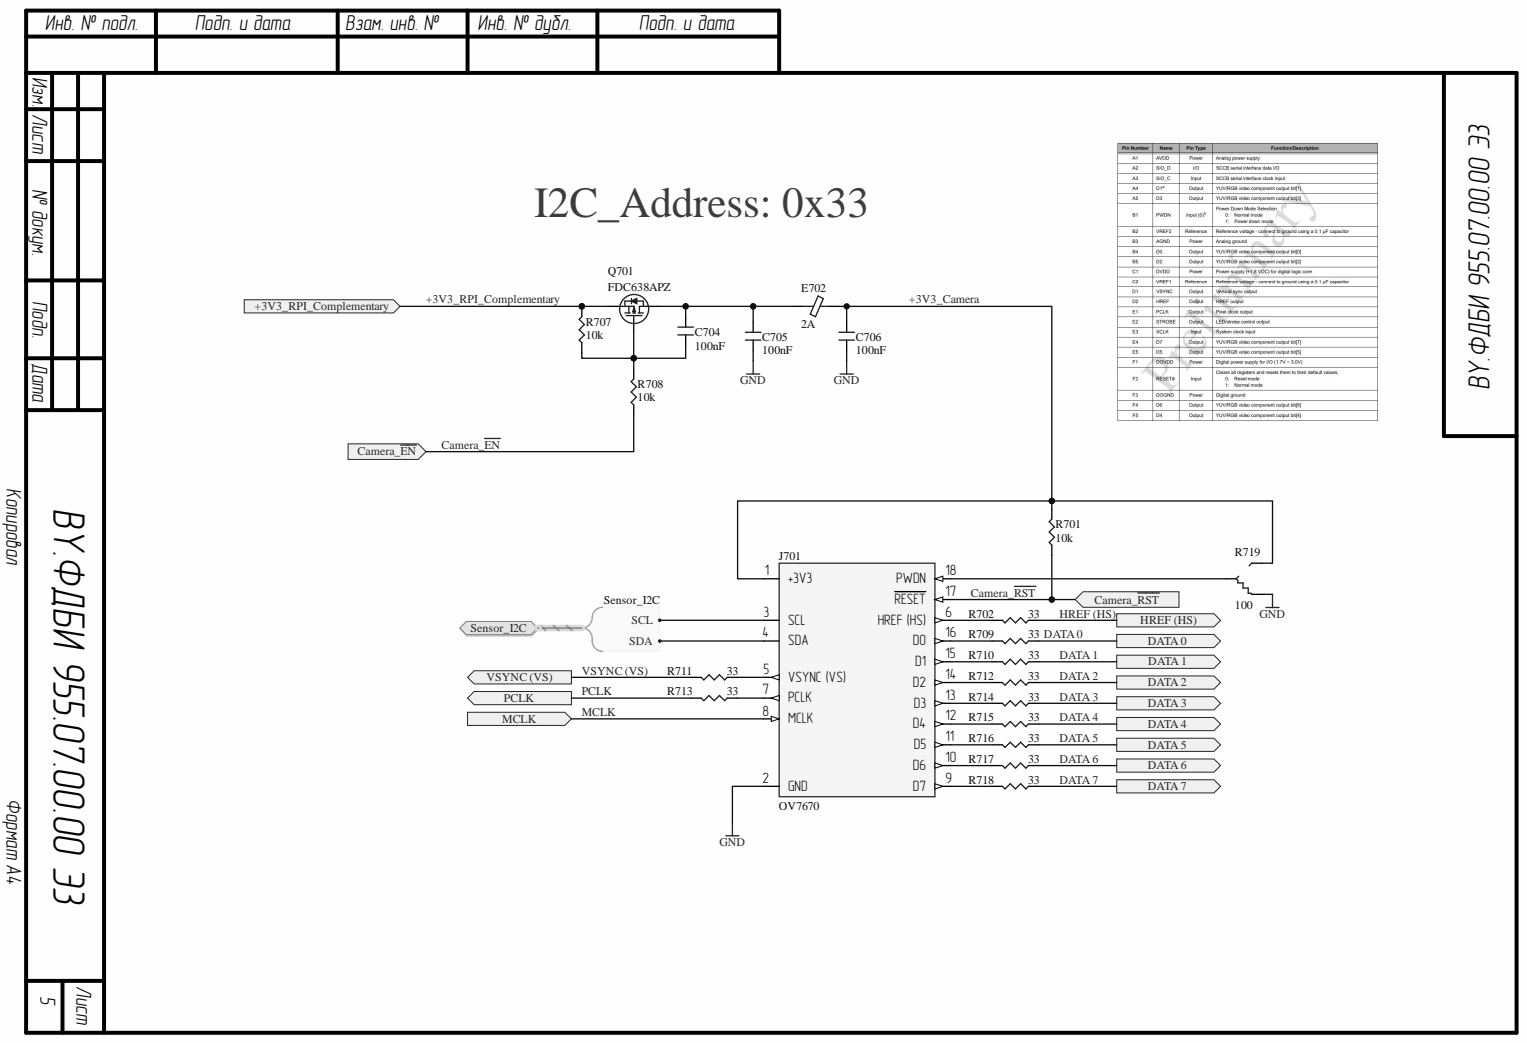
[picture p120: page 7]

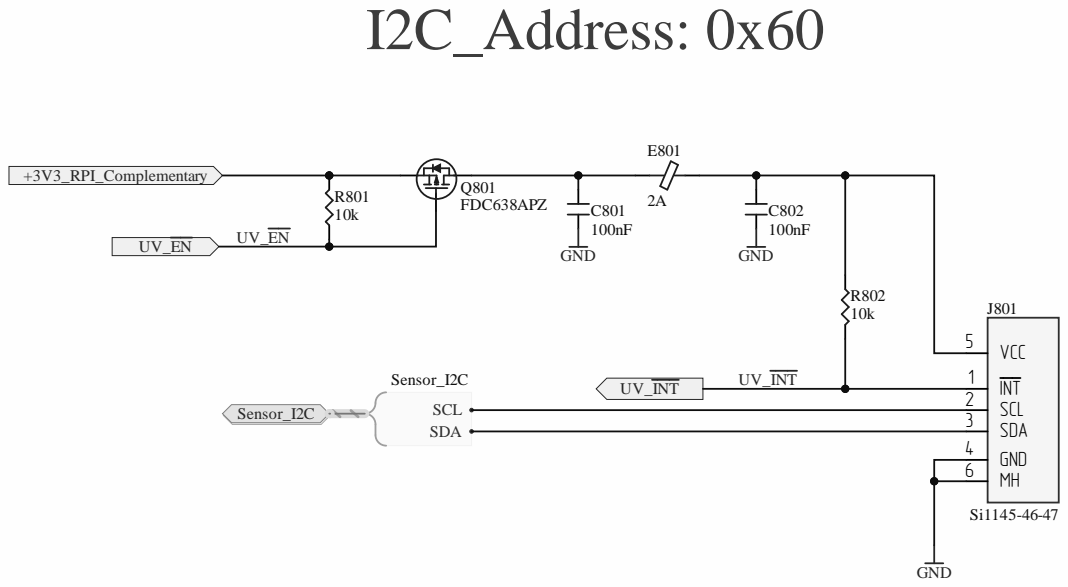
[picture p121: page 8]

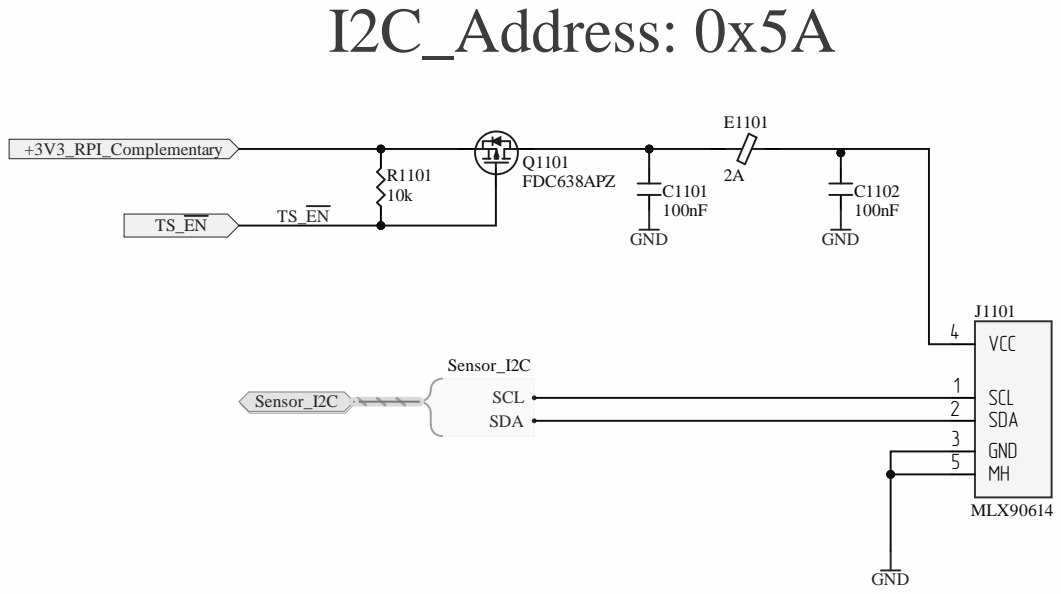
[picture p122: page 9]

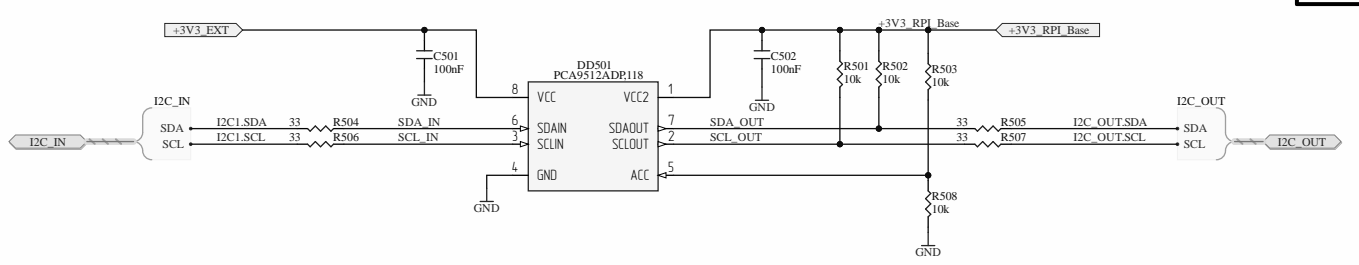
[picture p123: page 10]

№ докум. Лист Изм. Подп. Дата

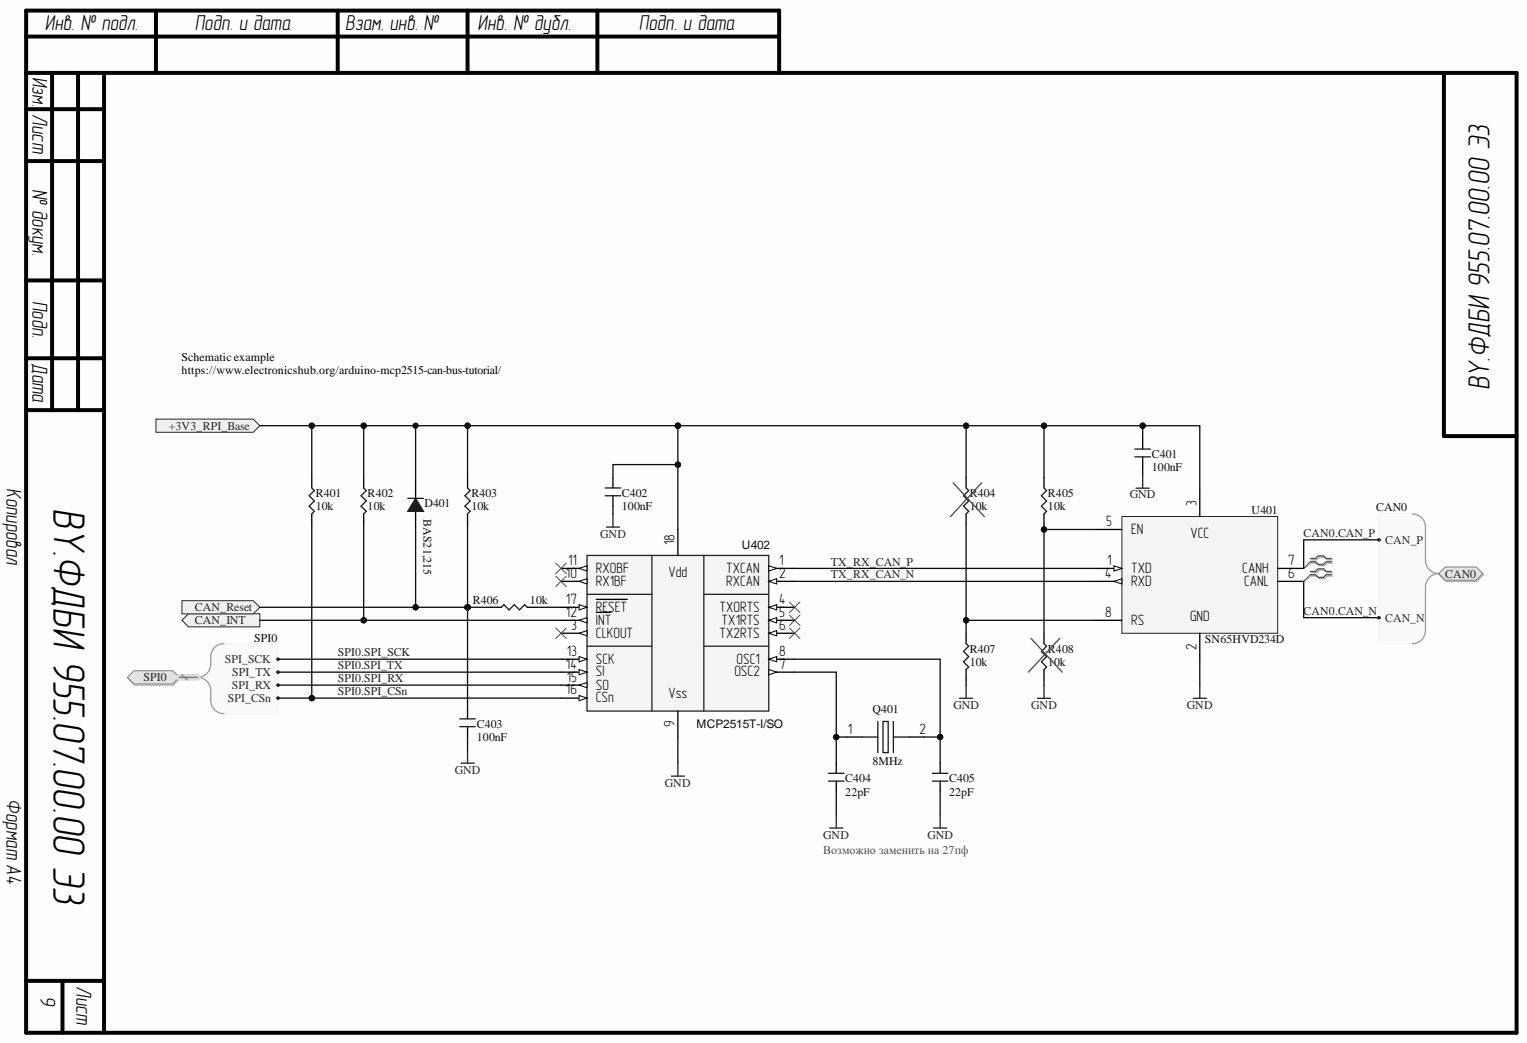
[picture p124: page 11]

№ докум. Лист Изм. Подп. Дата

RXCA N | 2 RX1BF 10

RX0BF 11 RESET 17 INT 12 CLKOUT | TXCAN TX0RTS TX1RTS TX2RTS | 1 Vss9 Vdd18

SI 14 SCK 13 SO 15 CSn 16 | OSC2
