6haitandimon/BSUSat2_simulator/docs/КД_CМКА/Схемы/BY.ФДБИ 955.03.00.00 Э1_Э3.PDF

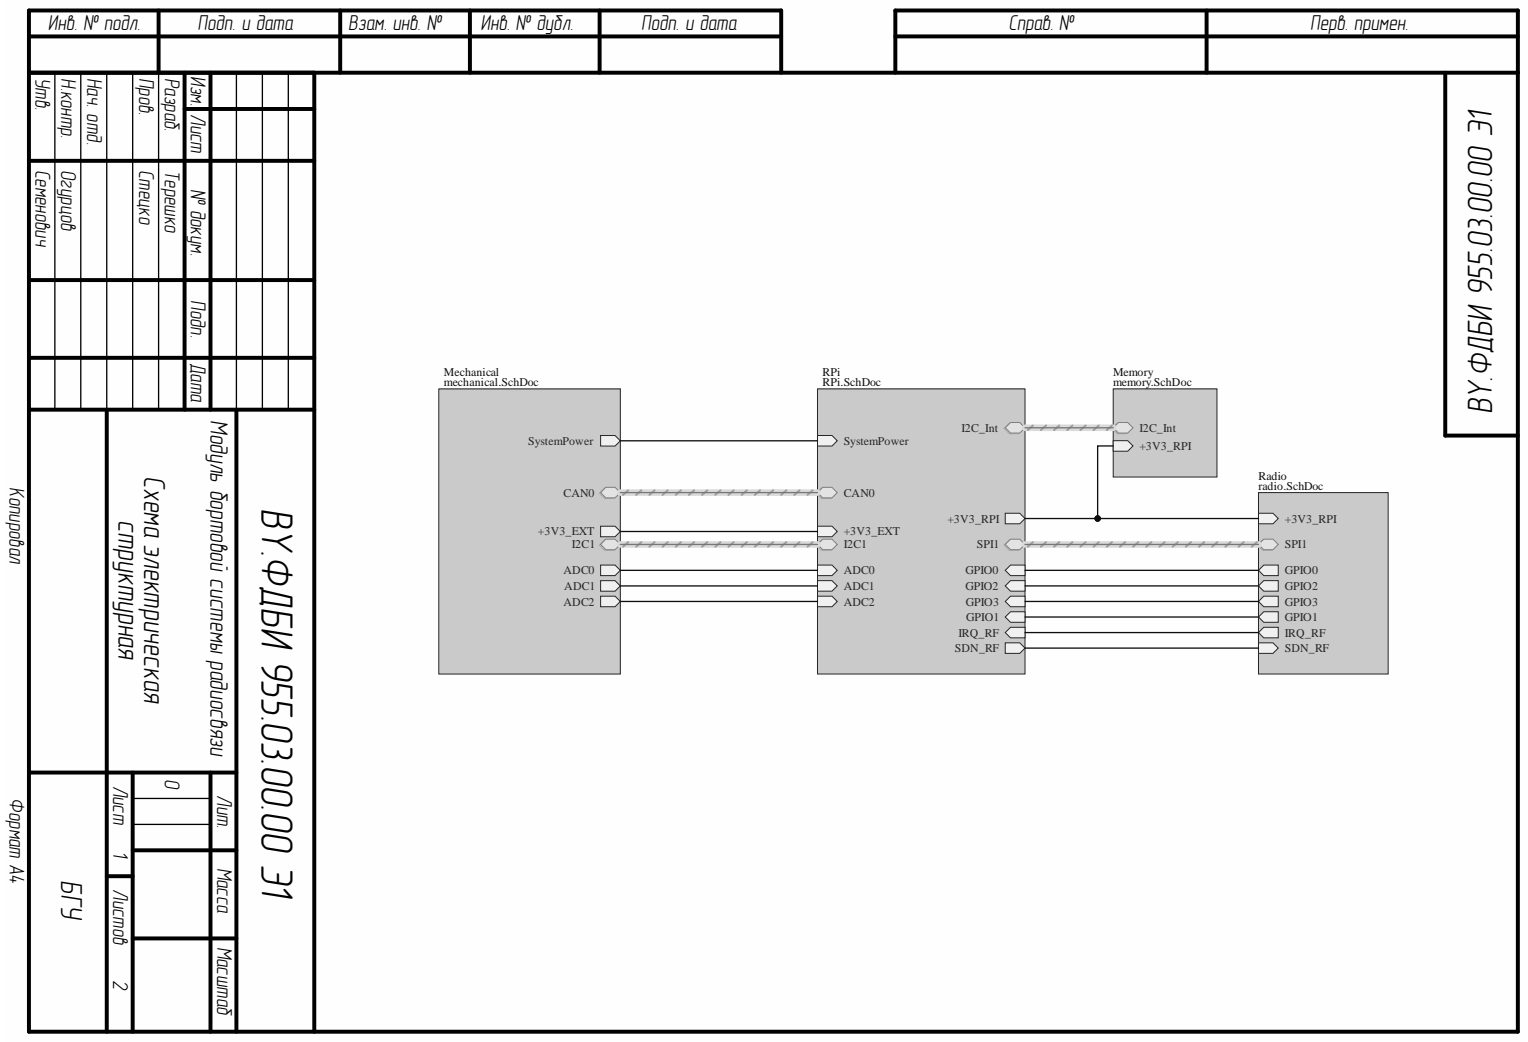
[picture p131: page 1]

Модуль бортовой системы радиосвязи

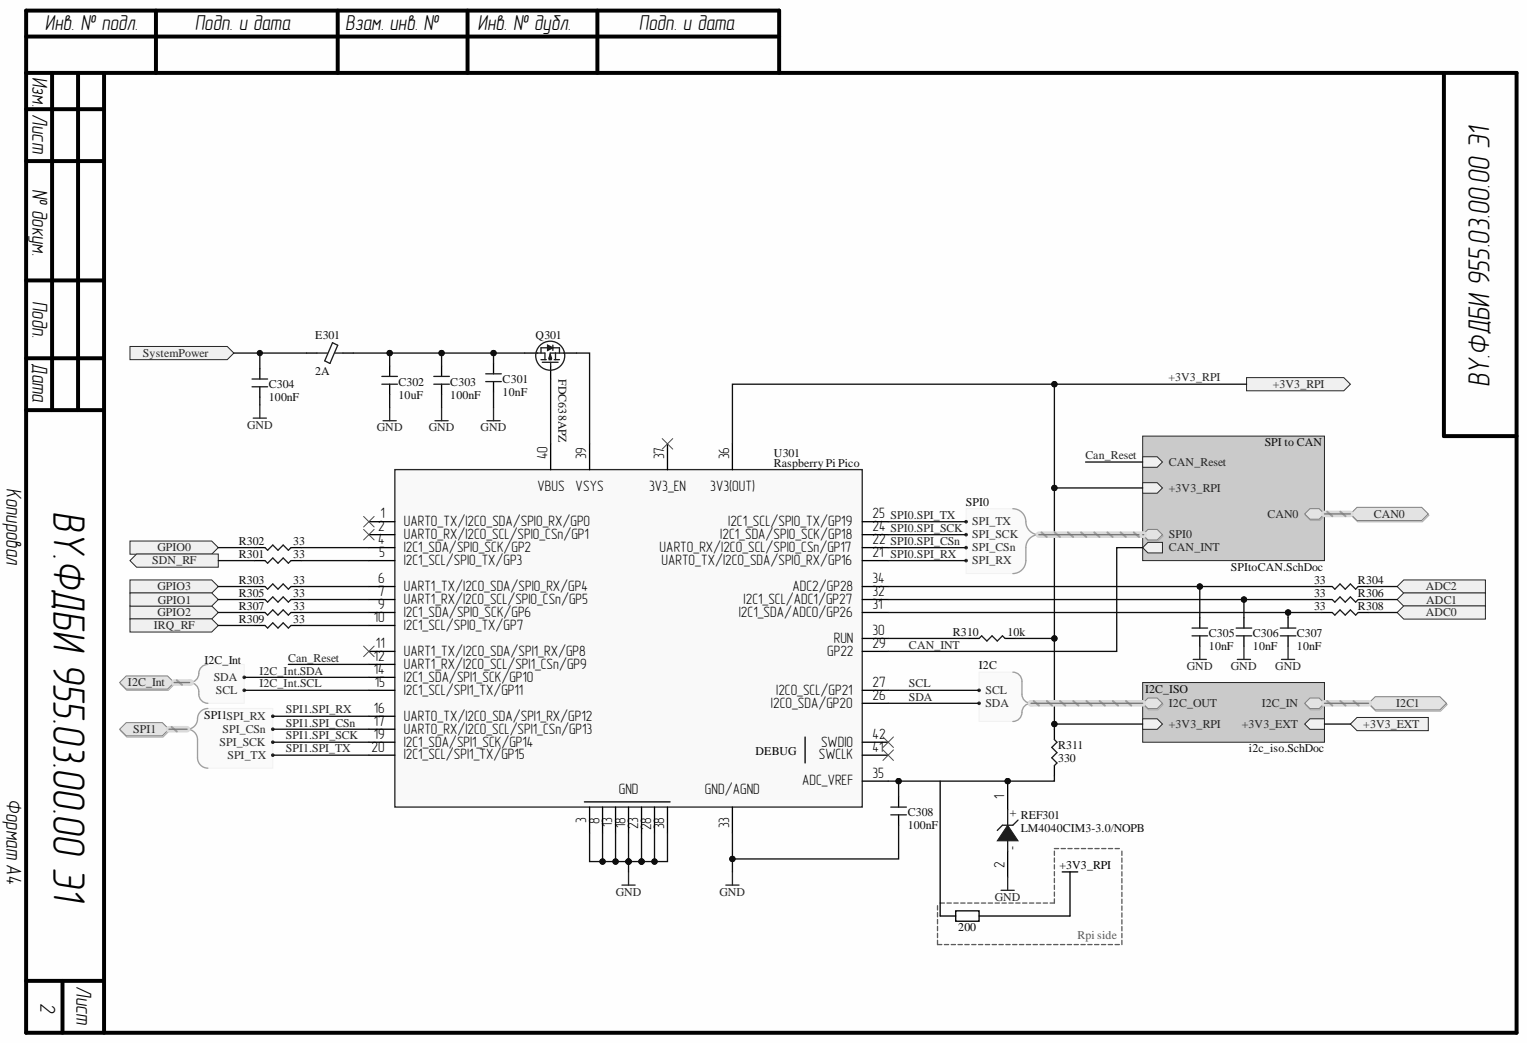
[picture p132: page 2]

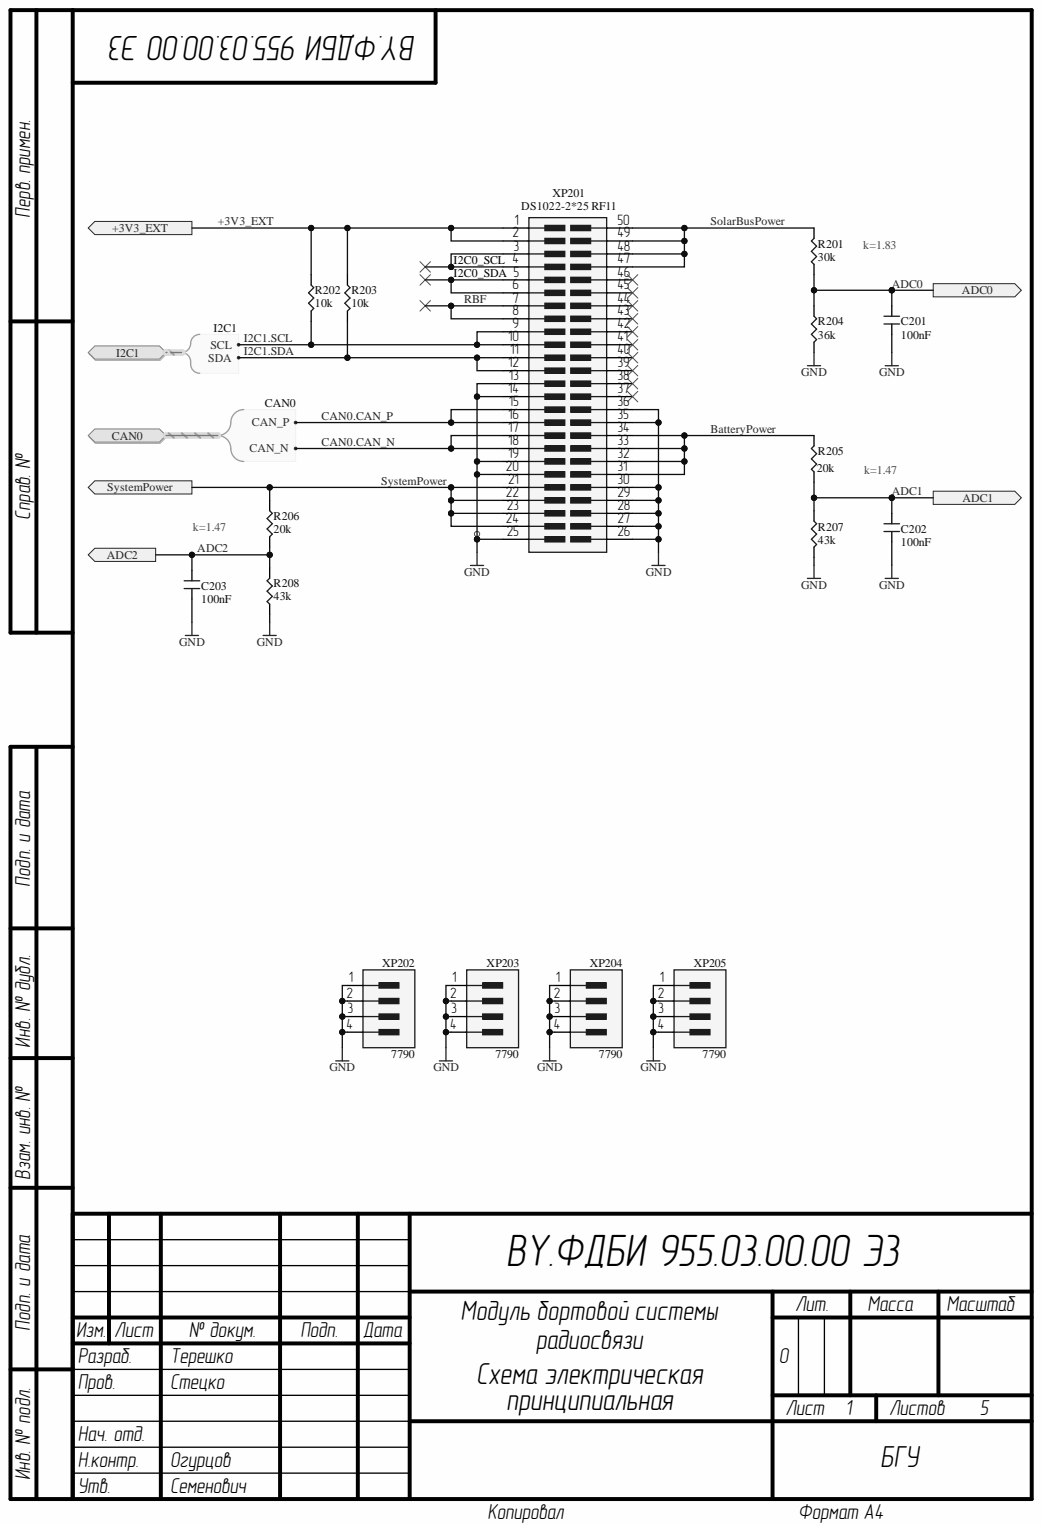
[picture p133: page 3]

I2C0_SCL | 4

22
23
24

BY.ФДБИ 955.03.00.00 Э3

Лит. | Масса | Масштаб

Изм. | Лист | № докум. | Подп. | Дата | | О
Разраб. | | Терешко
Пров. | Стецко
Нач. отд. | | БГУ
Н.контр. | Огурцов
Утв. | Семенович

Лист | Листов 5

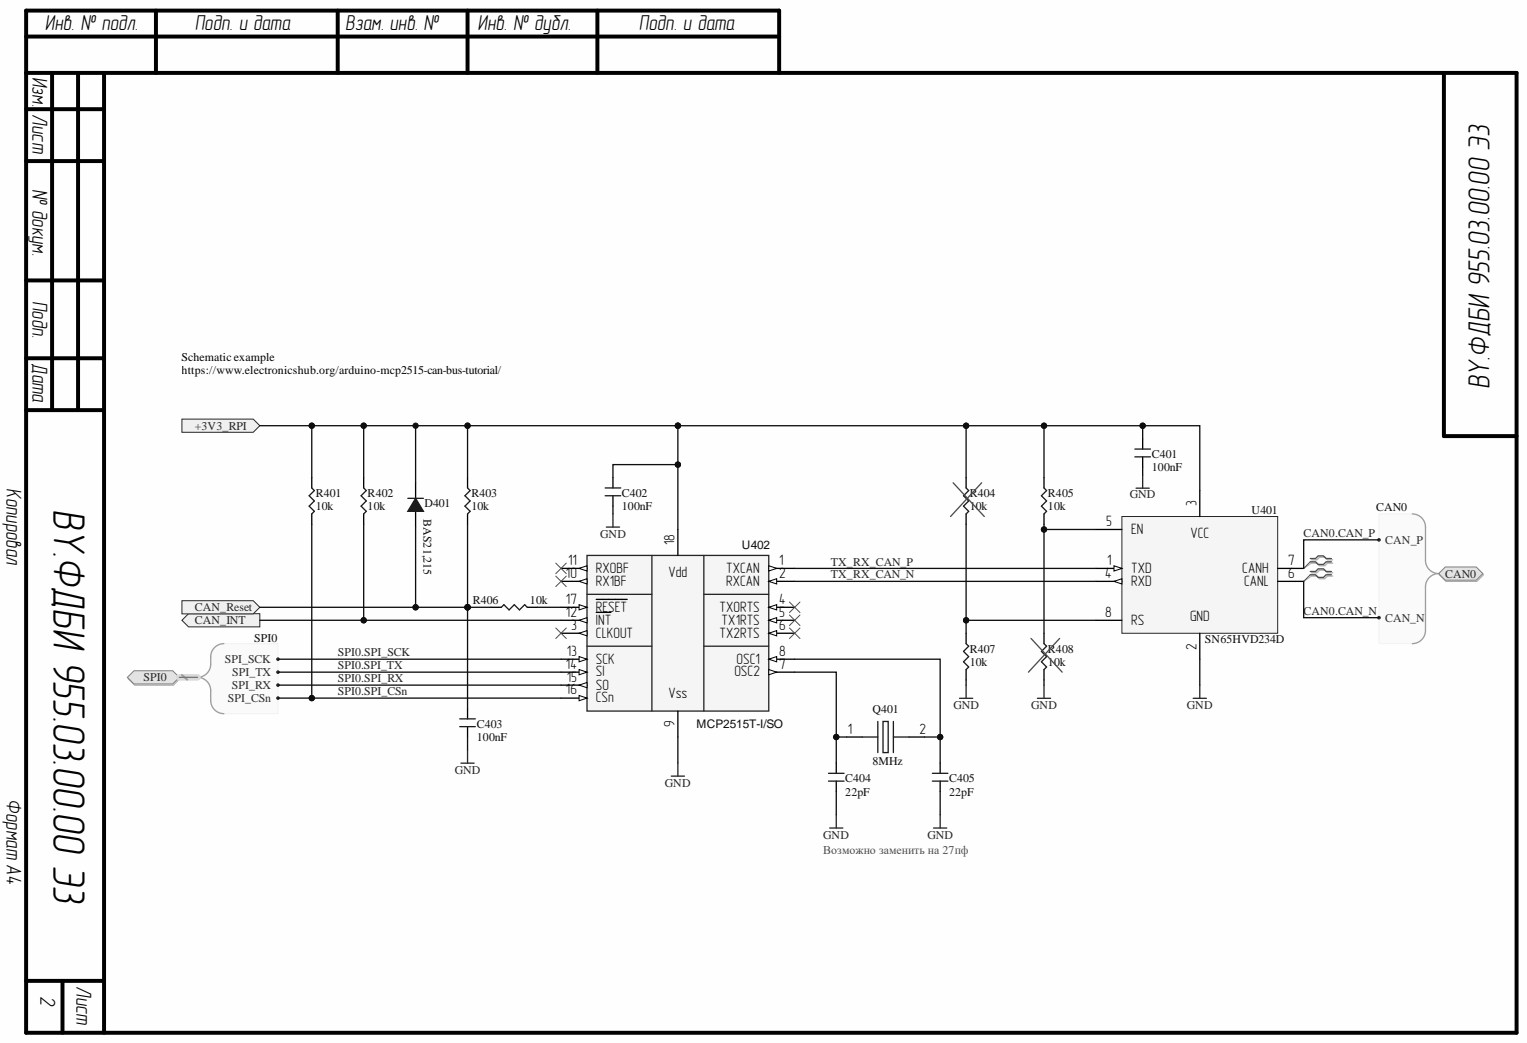
[picture p134: page 4]

№ докум. Лист Изм. Подп. Дата

RXCA N | 2 RX1BF 10

RX0BF 11 RESET 17 INT 12 CLKOUT | TXCAN TX0RTS TX1RTS TX2RTS | 1 Vss9 Vdd18

SI 14 SCK 13 SO 15 CSn 16 | OSC2

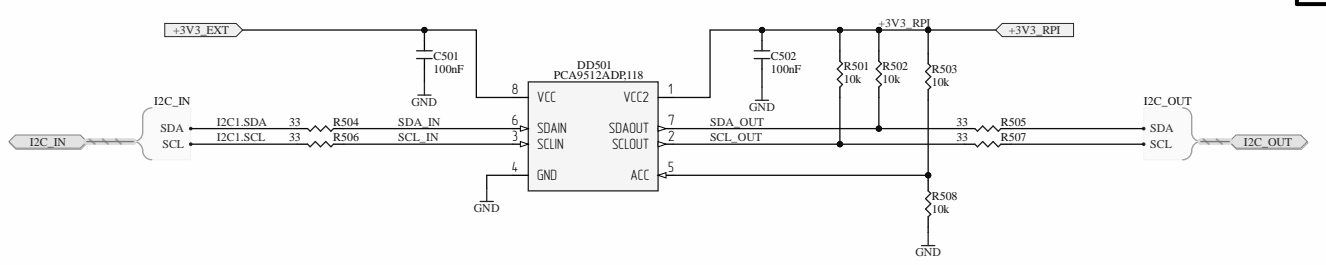
[picture p135: page 5]

№ докум. Лист Изм. Подп. Дата

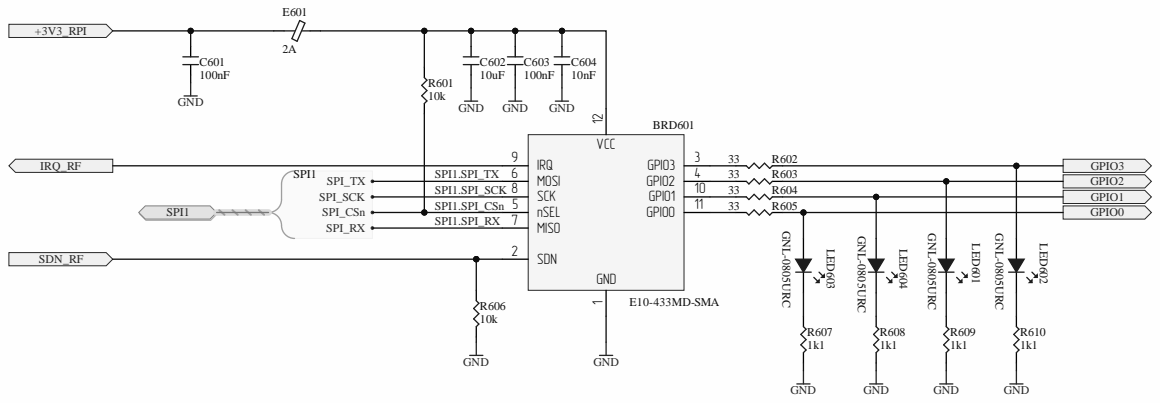
[picture p136: page 6]

№ докум. Лист Изм. Подп. Дата

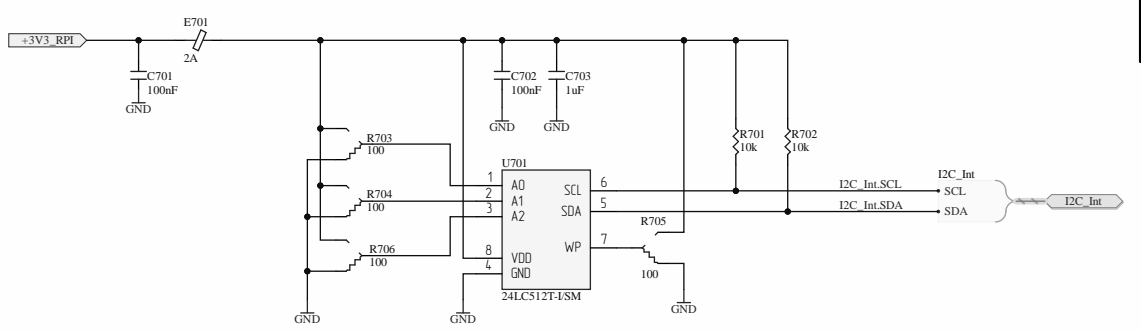
[picture p137: page 7]

№ докум. Лист Изм. Подп. Дата
