6haitandimon/BSUSat2_simulator/docs/КД_CМКА/Схемы/BY.ФДБИ 955.04.00.00 Э1_Э3.pdf

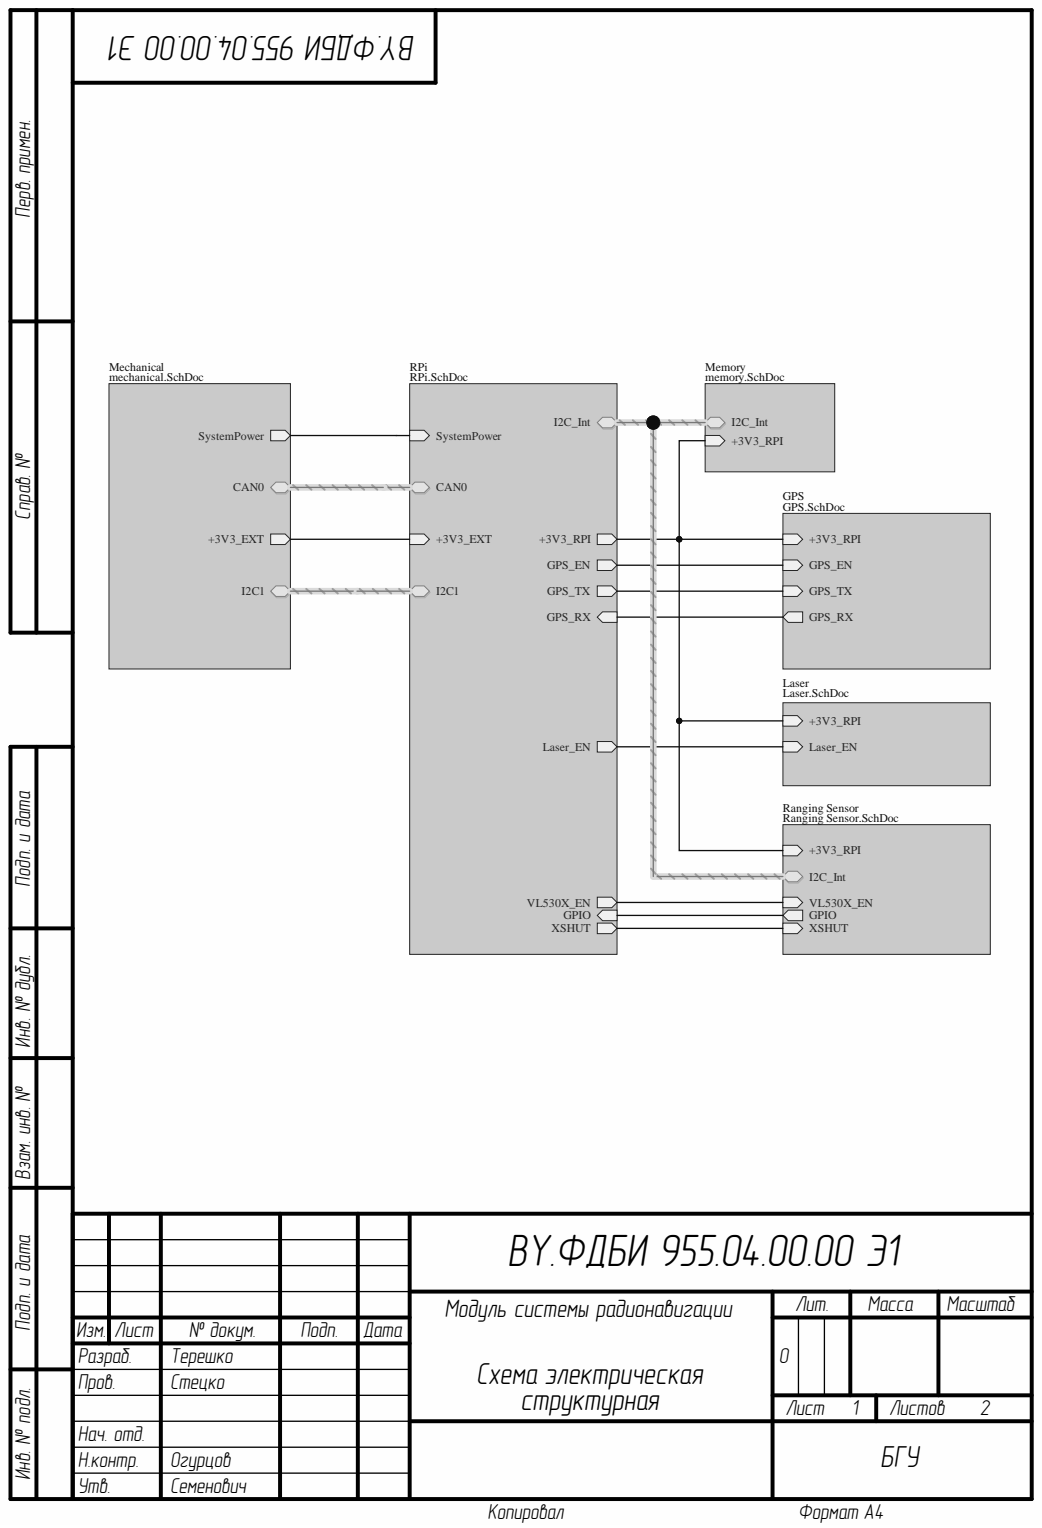
[picture p138: page 1]

Ranging Sensor Ranging Sensor.SchDoc

BY.ФДБИ 955.04.00.00 Э1

Лит. | Масса | Масштаб

Изм. | Лист | № докум. | Подп. | Дата | | О
Разраб. | | Терешко
Пров. | Стецко
Нач. отд. | | БГУ
Н.контр. | Огурцов
Утв. | Семенович

Лист | Листов 2

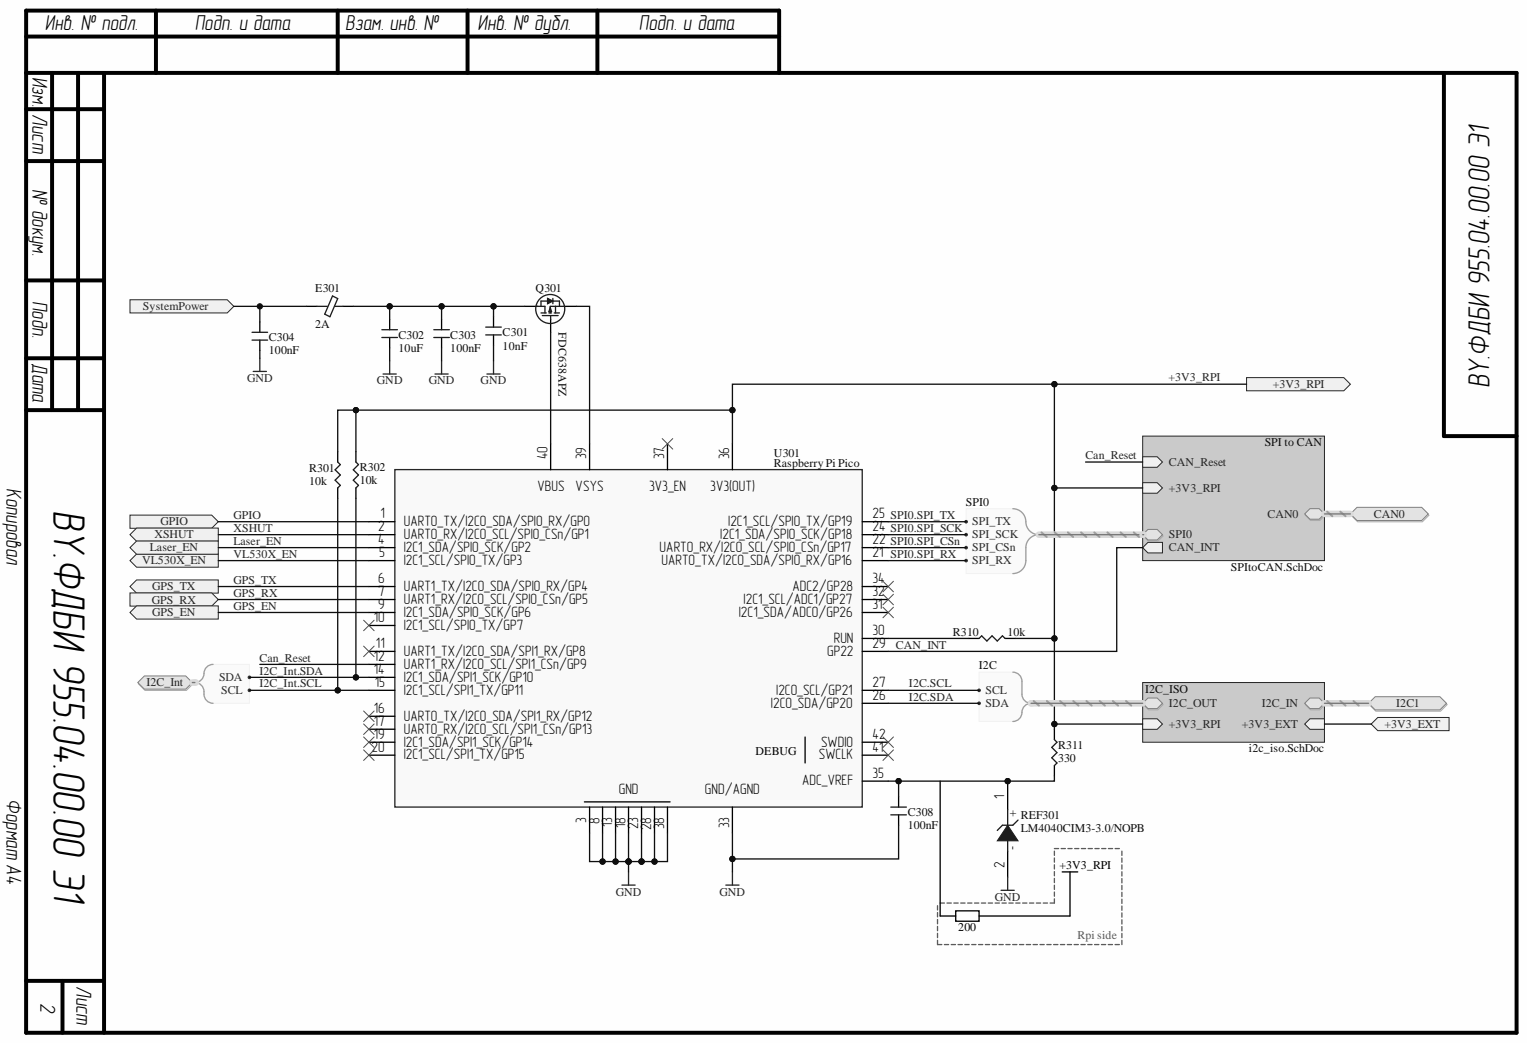
[picture p139: page 2]

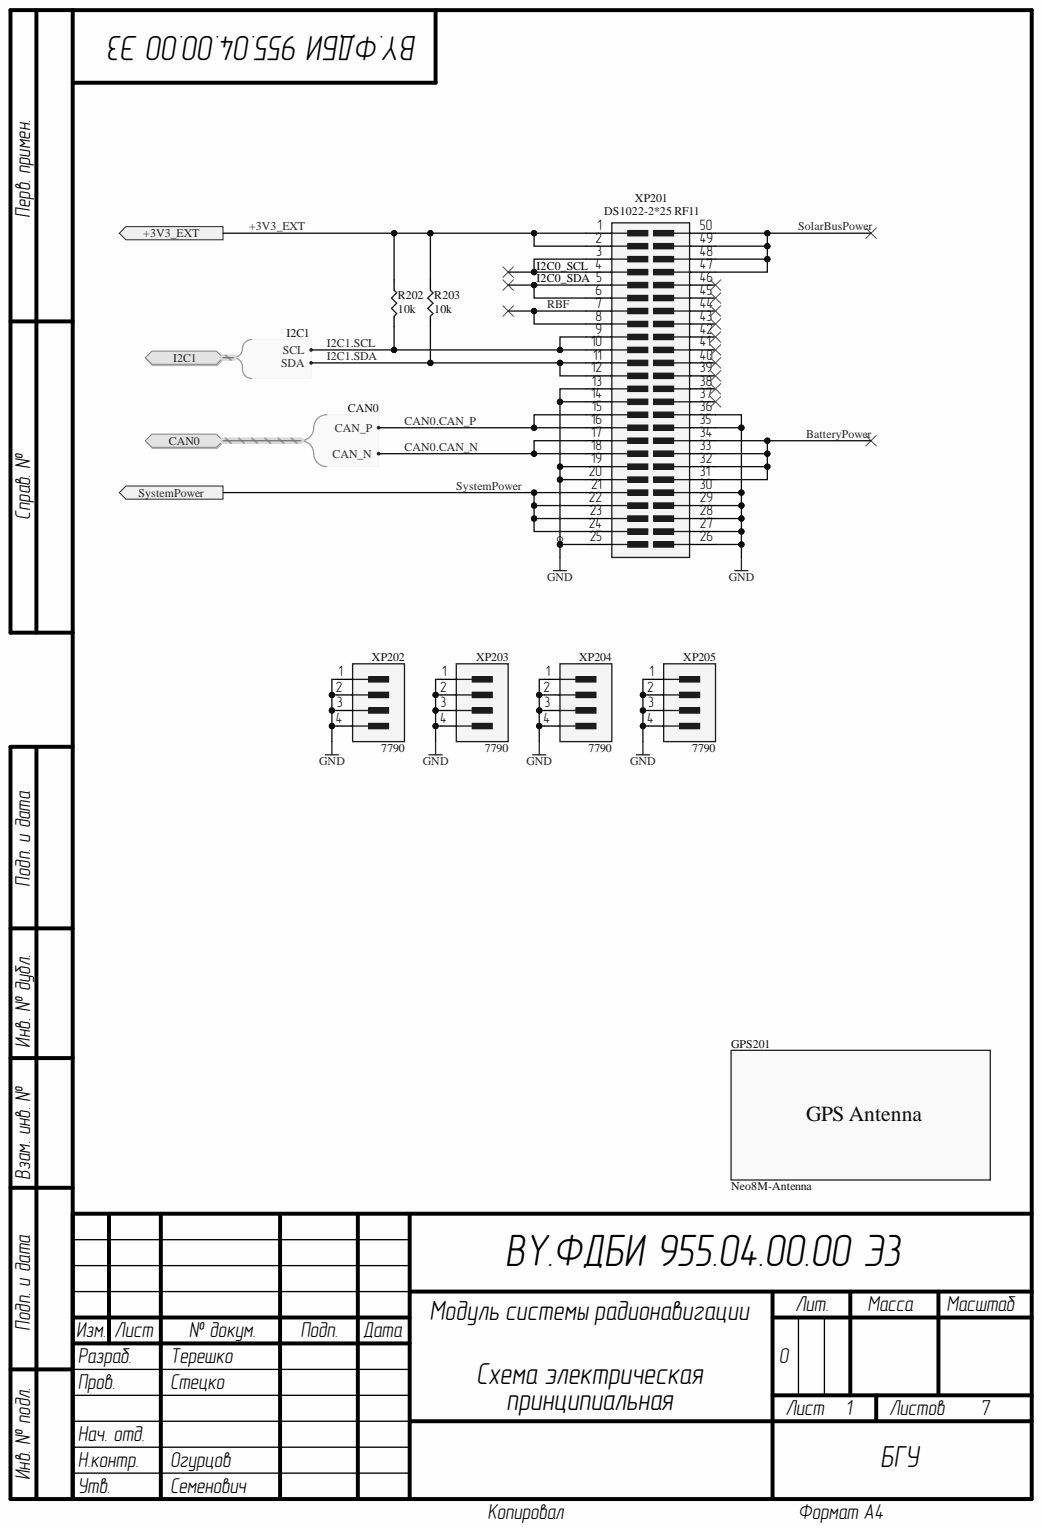
[picture p140: page 3]

14 | | 37
15 | | 36
17 | | 34 33
18
20 | 31
21 | 30
23 | 28
24 | 27
25 | | 26

CAN0.CAN_P | | 16 | 35

BY.ФДБИ 955.04.00.00 Э3

Лит. | Масса | Масштаб

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

Лист | Листов 7

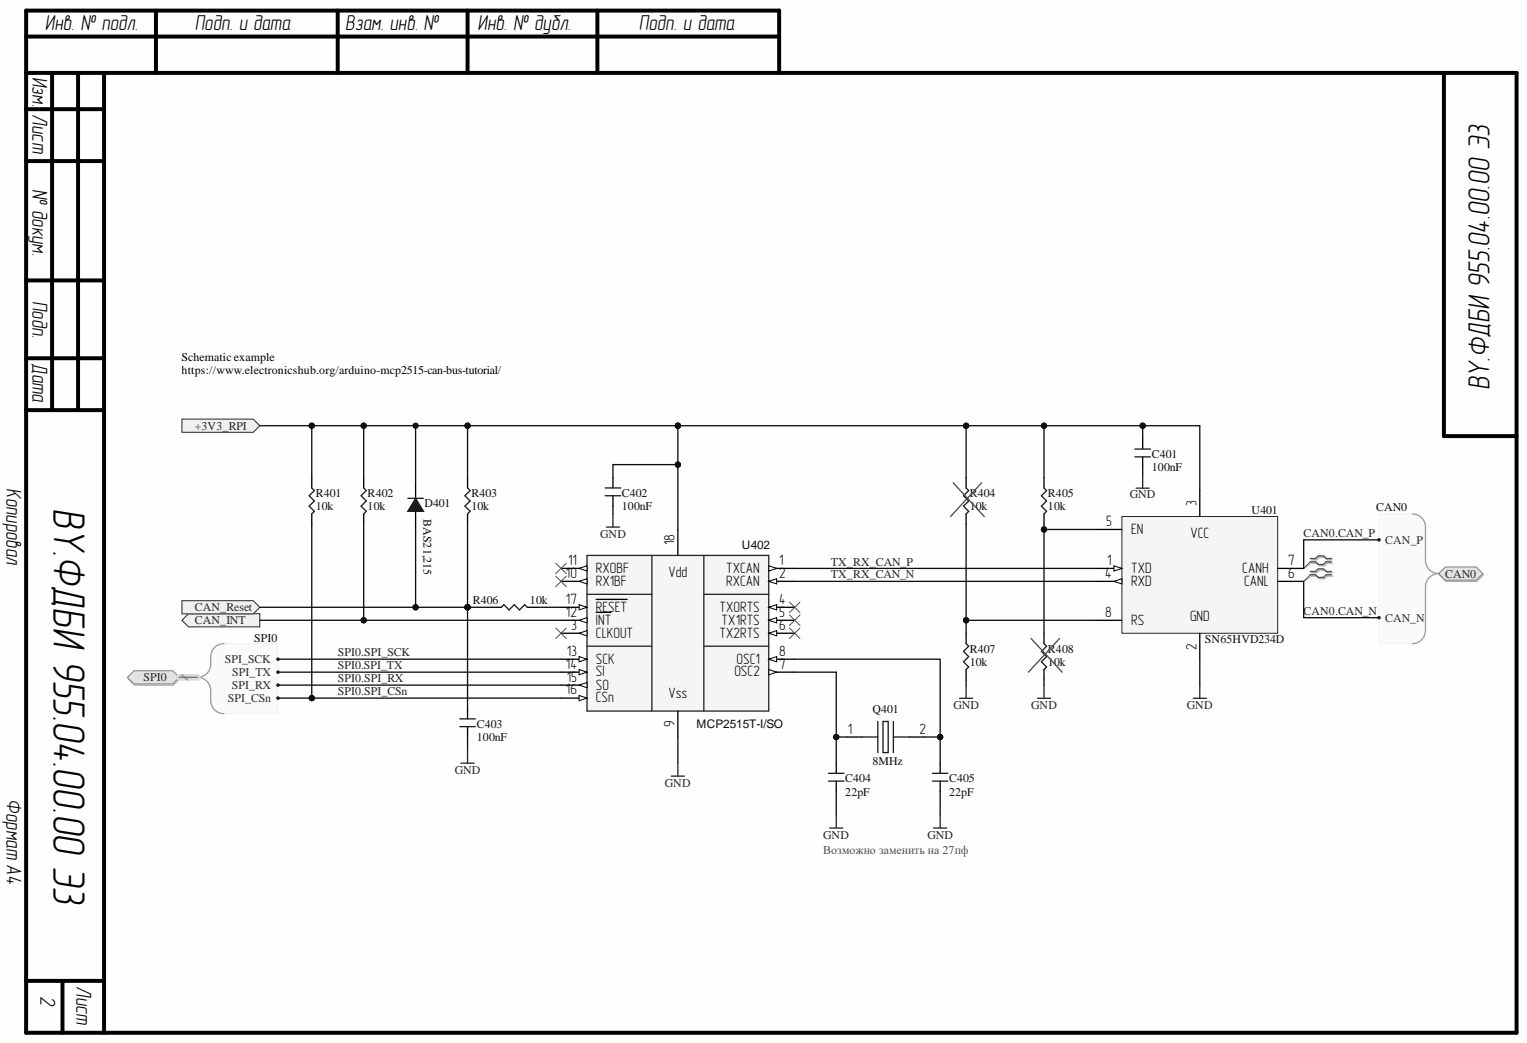
[picture p141: page 4]

№ докум. Лист Изм. Подп. Дата

RXCA N | 2 RX1BF 10

RX0BF 11 RESET 17 INT 12 CLKOUT | TXCAN TX0RTS TX1RTS TX2RTS | 1 Vss9 Vdd18

SI 14 SCK 13 SO 15 CSn 16 | OSC2

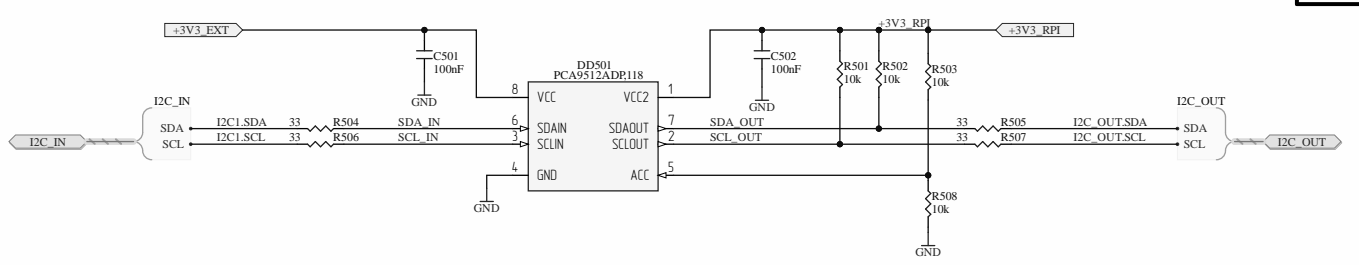
[picture p142: page 5]

№ докум. Лист Изм. Подп. Дата

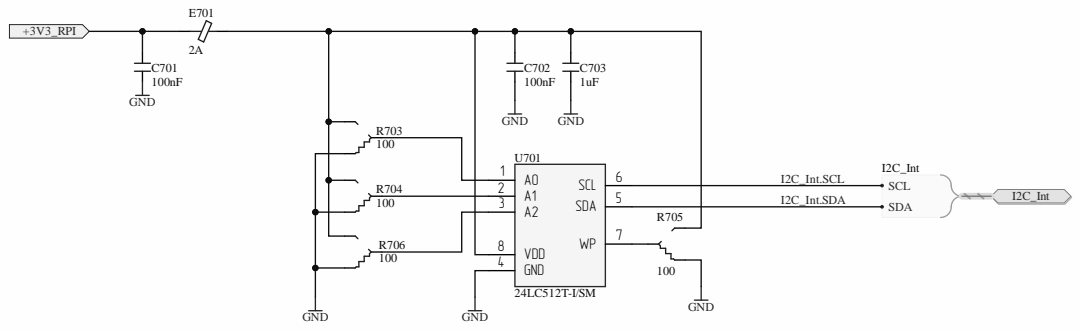
[picture p143: page 6]

№ докум. Лист Изм. Подп. Дата

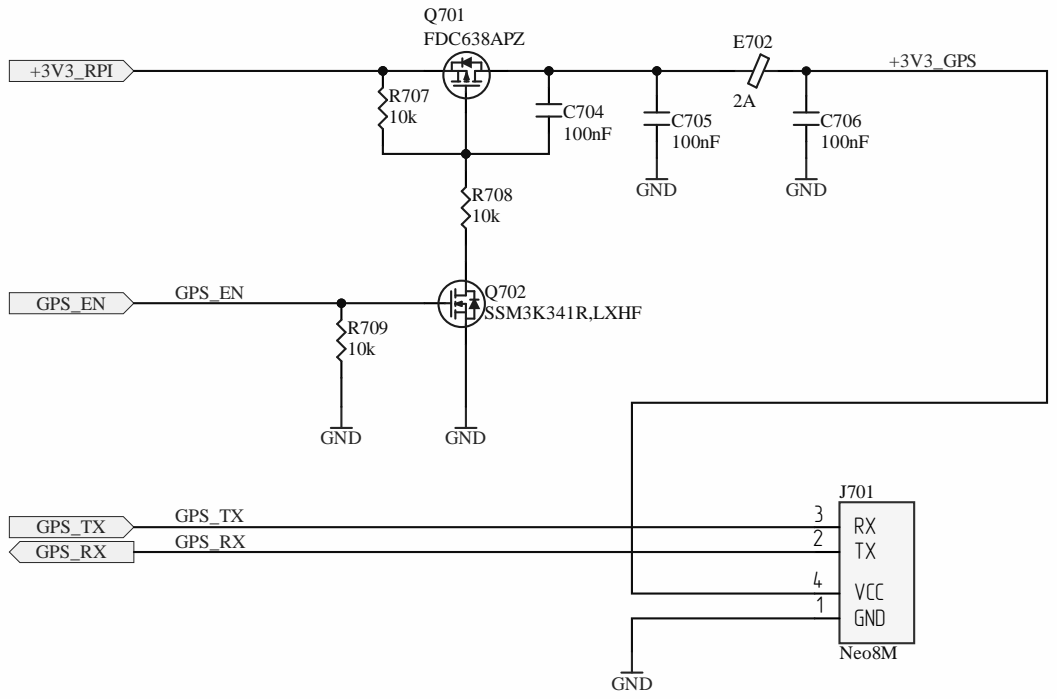
[picture p144: page 7]

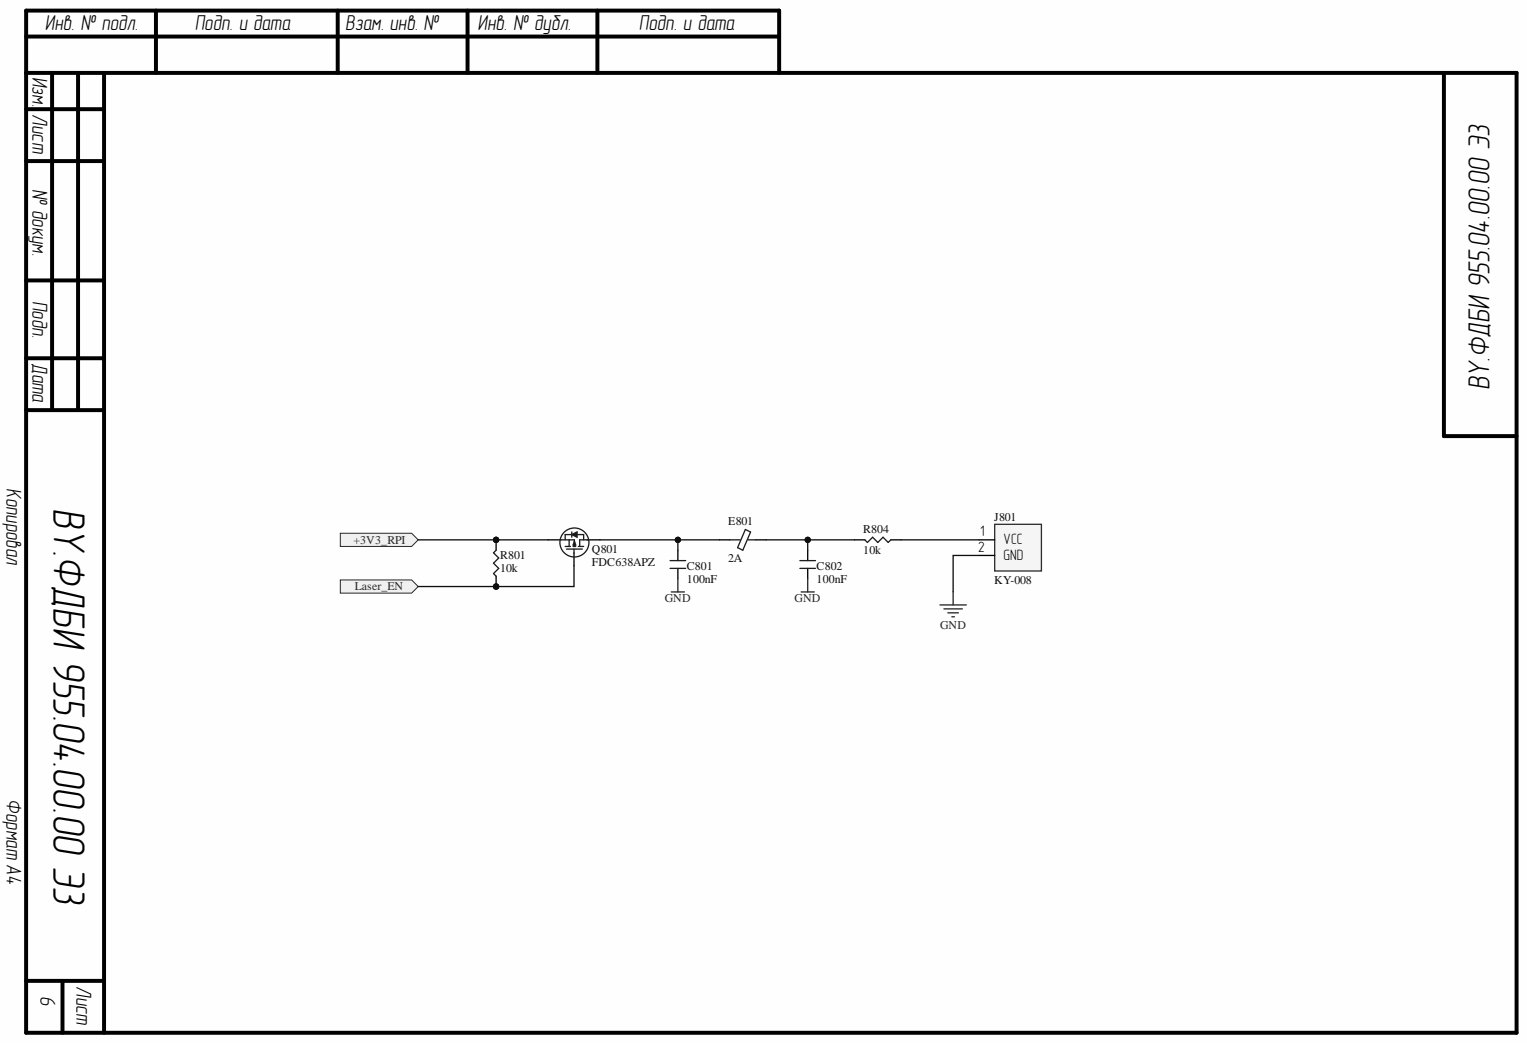
[picture p145: page 8]

№ докум. Лист Изм. Подп. Дата

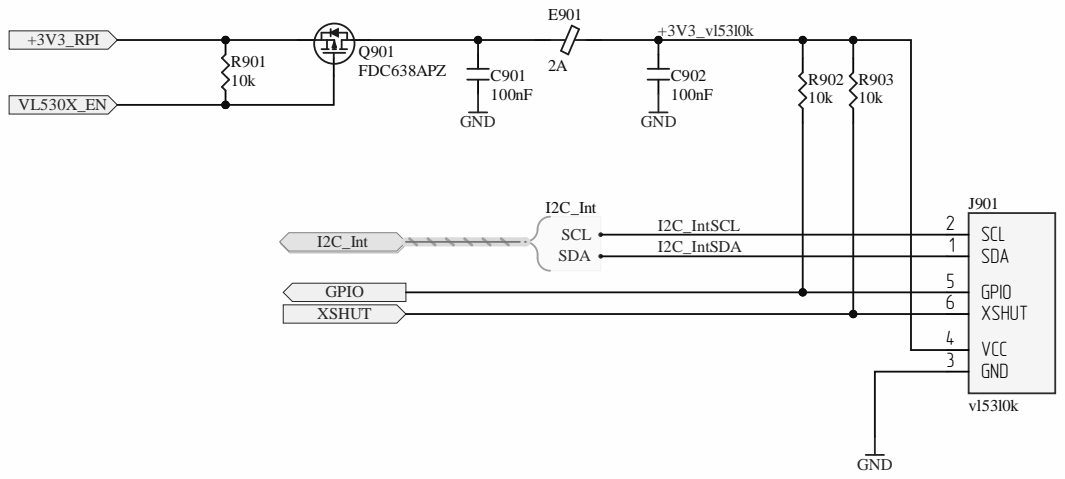
[picture p146: page 9]
