6haitandimon/BSUSat2_simulator/docs/КД_CМКА/Чертежи/3_BY.ФДБИ 955.01.00.00 СБ_0.pdf

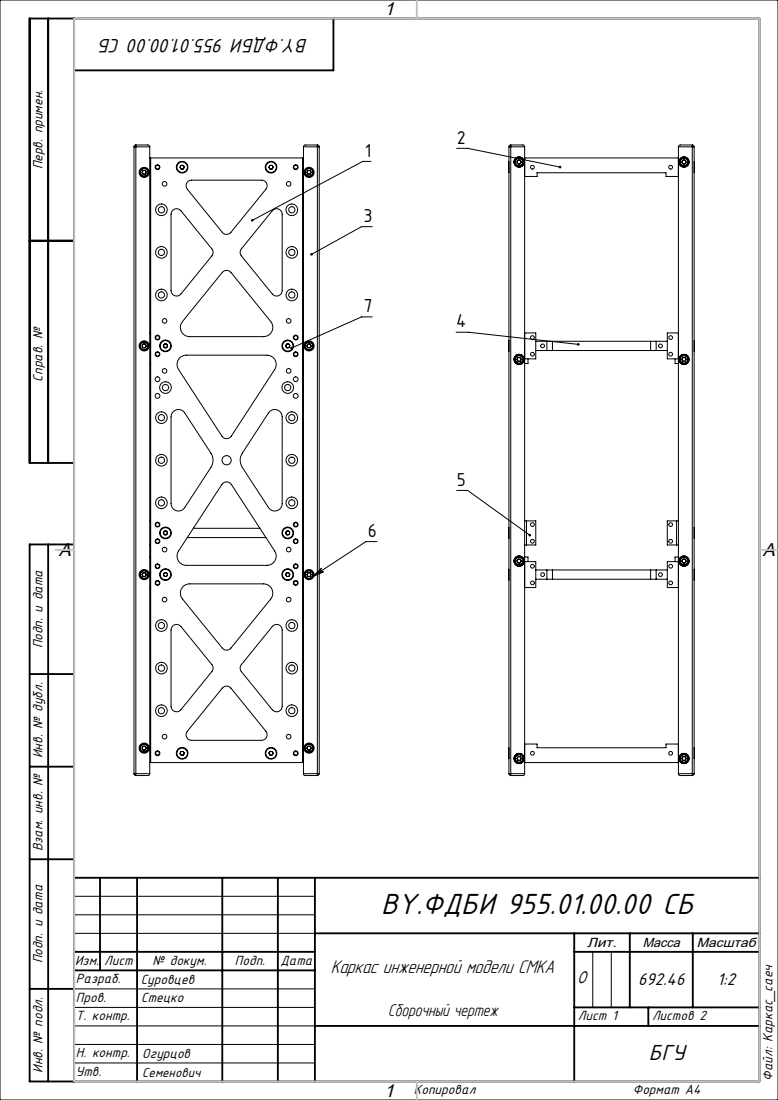
[picture p147: page 1]
Копировал; Формат А4; Файл: Каркас_саеч

Справ. № Перв. примен. Подп. и дата Инв. № дубл. Взам. инв. № Подп. и дата Инв. № подл.

BY.ФДБИ 955.01.00.00 СБ

Каркас инженерной модели СМКА Сборочный чертеж | Лит. | Масса | Масштаб

Изм. | Лист | № докум. | Подп. | Дата | | О | | | 692.46 | 1:2
Разраб. | | Суровцев
Пров. | Стецко
Т. контр. | | | | | Лист 1 | Листов 2

БГУ

Н. контр. | Огурцов
Утв. | Семенович

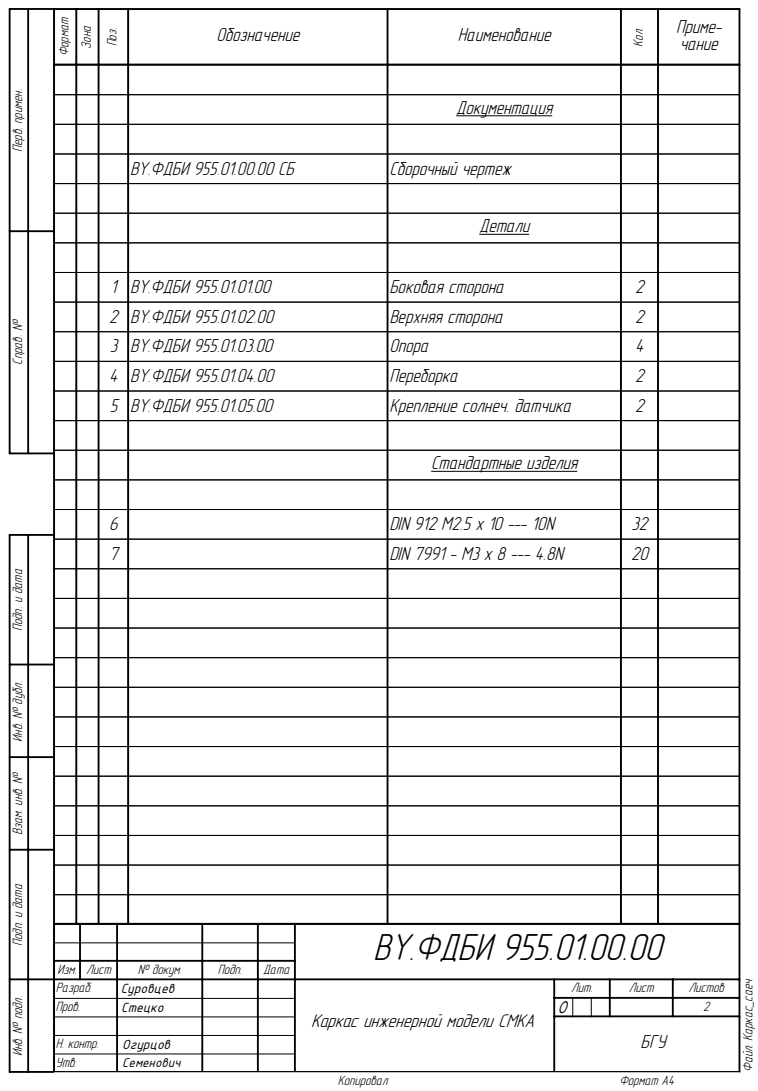
[picture p148: page 2]
BY.ФДБИ 955.01.00.00 СБ; Сборочный чертеж; Стандартные изделия; Формат А4; Файл: Каркас_саеч

Инв. № подл. Подп. и дата Взам. инв. № Инв. № дубл. Подп. и дата Перв. примен. Справ. №

1 | BY.ФДБИ 955.01.01.00 | Боковая сторона | 2
2 BY.ФДБИ 955.01.02.00 | | Верхняя сторона | 2
3 | BY.ФДБИ 955.01.03.00 | Опора | 4
4 BY.ФДБИ 955.01.04.00 | | Переборка | 2
5 | BY.ФДБИ 955.01.05.00 | Крепление солнеч. датчика | 2

6 | DIN 912 M2.5 x 10 --- 10N | 32
7 | DIN 7991 - M3 x 8 --- 4.8N | 20

BY.ФДБИ 955.01.00.00

Изм. | Лист | № докум. | Подп. | Дата
Разраб. | Суровцев | | | Каркас инженерной модели СМКА | Лит. | Лист | Листов
Пров. | Стецко | | | | О | | | | 2

Н. контр. | Огурцов
Утв. | Семенович
