6haitandimon/BSUSat2_simulator/docs/КД_CМКА/Чертежи/4_BY.ФДБИ 955.01.01.00_бок_О.pdf

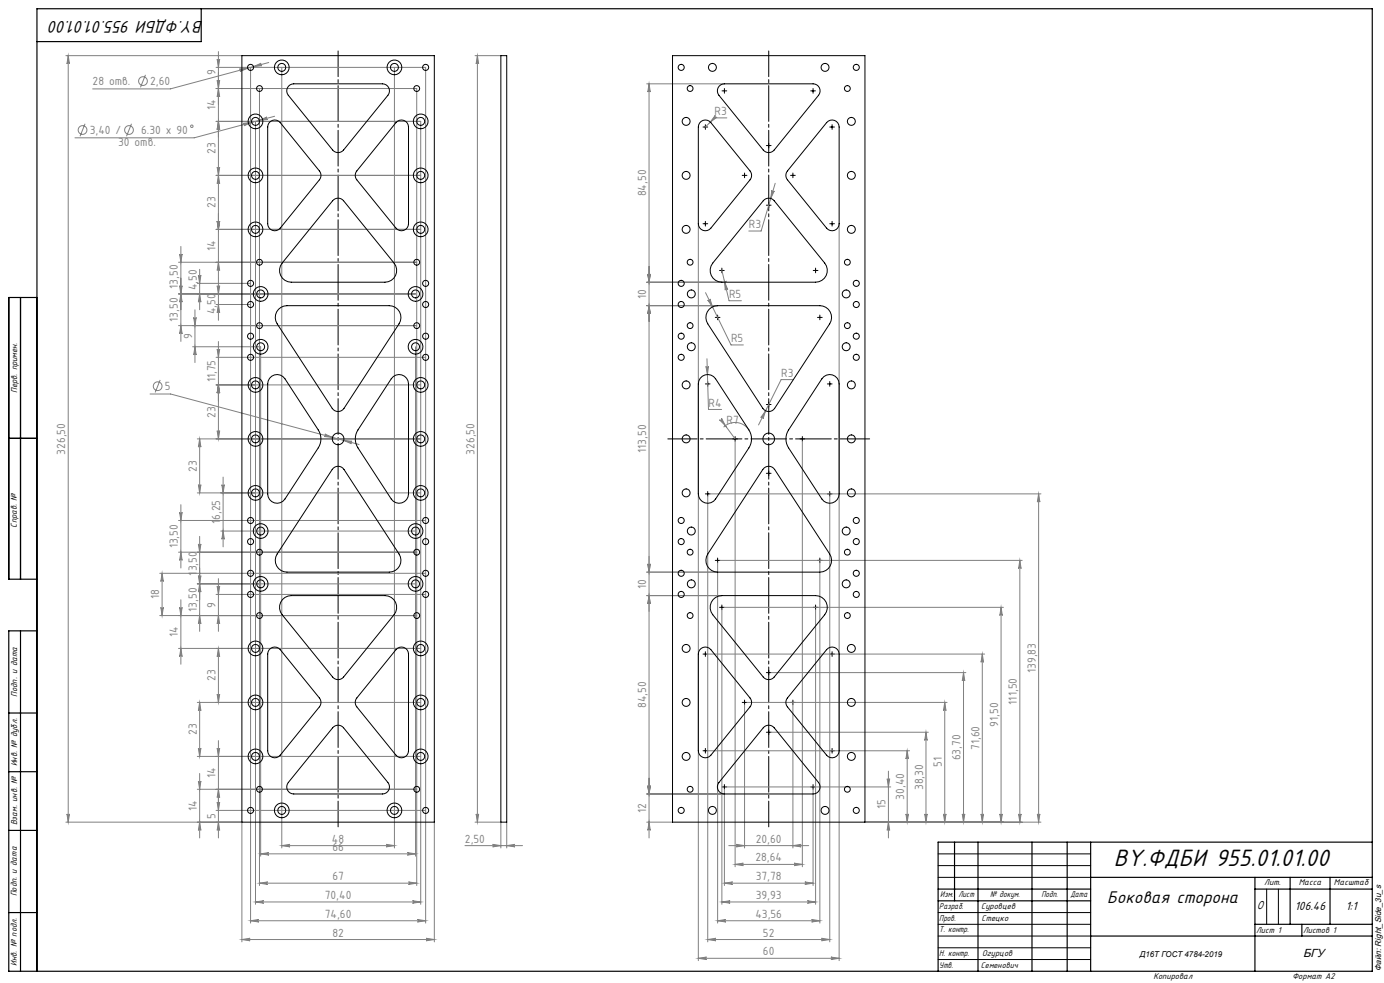
[picture p149: page 1]
28 отв.; 30 отв.; Копировал; Формат А2; Файл: Right_Side_3u_s

Справ. № Перв. примен. Подп. и дата Инв. № дубл. Взам. инв. № Подп. и дата Инв. № подл.

BY.ФДБИ 955.01.01.00

Боковая сторона | Лит. | Масса | Масштаб

Изм. | Лист | № докум. | Подп. | Дата | | О | | | 106.46 | 1:1

Пров. | Стецко
Т. контр. | | | Лист 1 | Листов 1

Н. контр. | Огурцов
Утв. | Семенович

Д16Т ГОСТ 4784-2019 | БГУ
