6haitandimon/BSUSat2_simulator/docs/КД_CМКА/Чертежи/5_BY.ФДБИ 955.01.02.00_верх_О.pdf

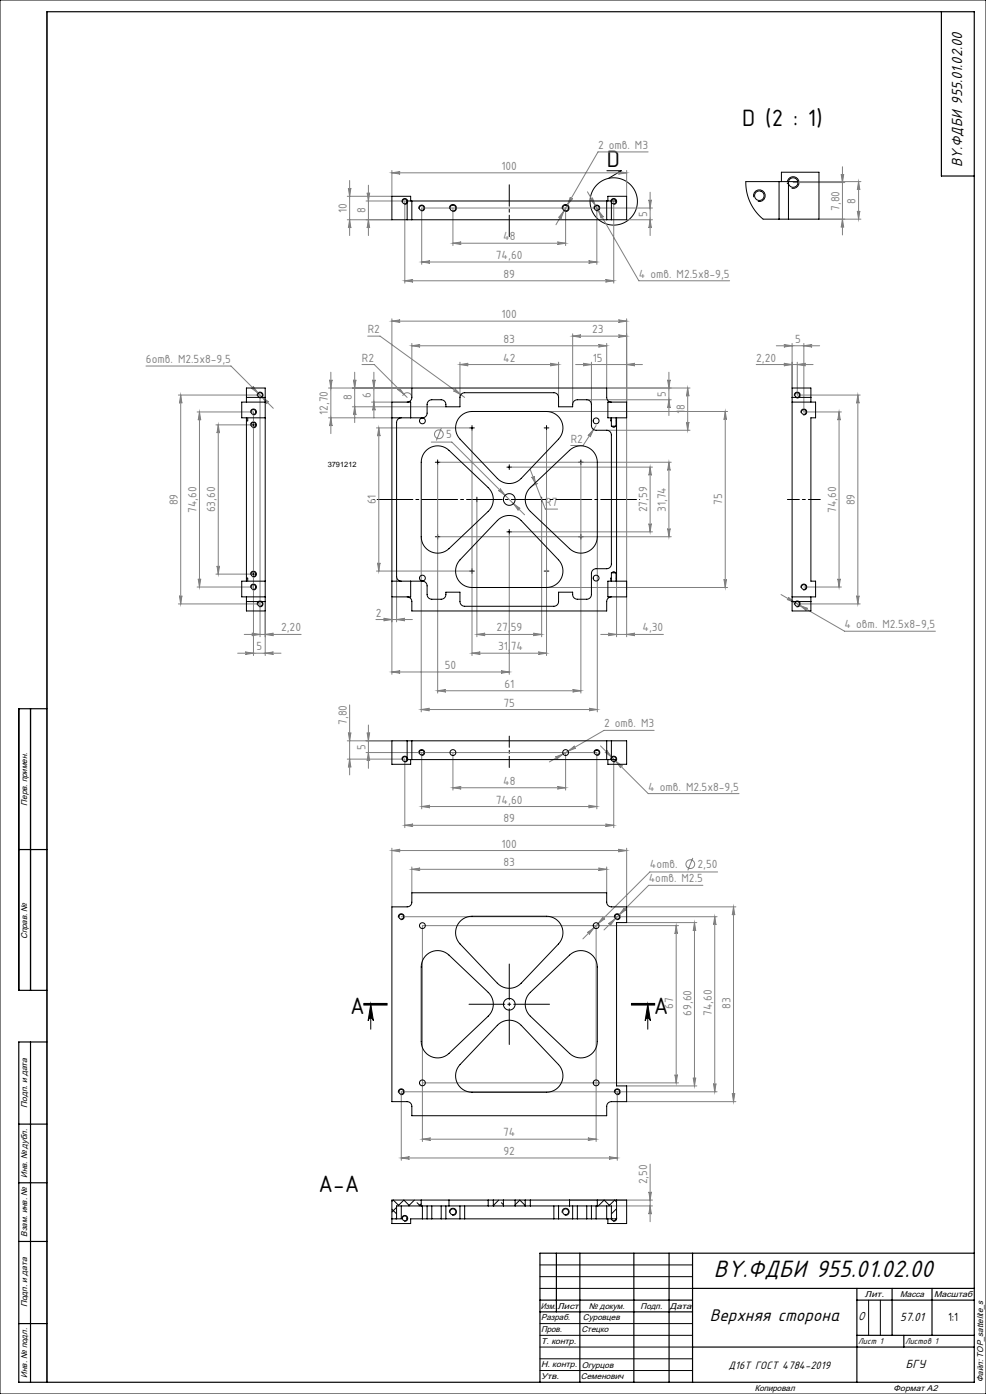
[picture p150: page 1]
4 овт. M2.5х8-9,5; 6отв. M2.5х8-9,5; 2 отв. M3; 4 отв. M2.5х8-9,5; 2 отв. М3; 4отв. M2.5 67; Копировал; Формат А2; BY.ФДБИ 955.01.02.00; Файл: TOP_sattelite_s

Справ. № Перв. примен. Подп. и дата Инв. № дубл. Взам. инв. № Подп. и дата Инв. № подл.

BY.ФДБИ 955.01.02.00

Верхняя сторона | Лит. | Масса | Масштаб

Изм. | Лист № докум. | | Подп. | Дата | | О | | | 57.01 | 1:1
Разраб. | | Суровцев
Пров. | | Стецко
Т. контр. | | | | | Лист 1 | Листов 1

Н. контр. | Огурцов
Утв. | Семенович

Д16Т ГОСТ 4784-2019 | БГУ
