6haitandimon/BSUSat2_simulator/docs/КД_CМКА/Чертежи/6_BY.ФДБИ 955.01.03.00_опора_О.pdf

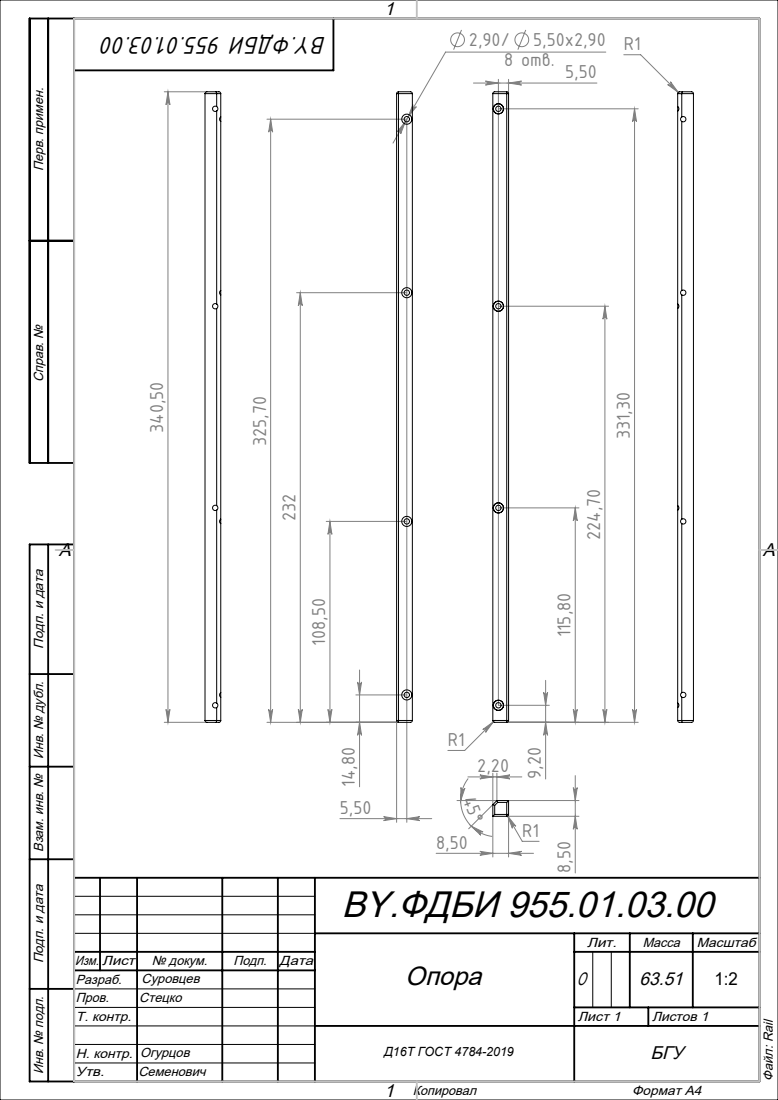
[picture p151: page 1]
2,90/ 5,50x2,90 8 отв.; Копировал; Формат А4; Файл: Rail

Справ. № Перв. примен. Подп. и дата Инв. № дубл. Взам. инв. № Подп. и дата Инв. № подл.

BY.ФДБИ 955.01.03.00

Опора | Лит. | Масса | Масштаб

Изм. | Лист | № докум. | Подп. | Дата | | О | | | 63.51 | 1:2
Разраб. | | Суровцев
Пров. | Стецко
Т. контр. | | | | | Лист 1 | Листов 1

Н. контр. | Огурцов
Утв. | Семенович

Д16Т ГОСТ 4784-2019 | БГУ
