6haitandimon/BSUSat2_simulator/docs/КД_CМКА/Чертежи/7_BY.ФДБИ 955.01.04.00_переборка_О.pdf

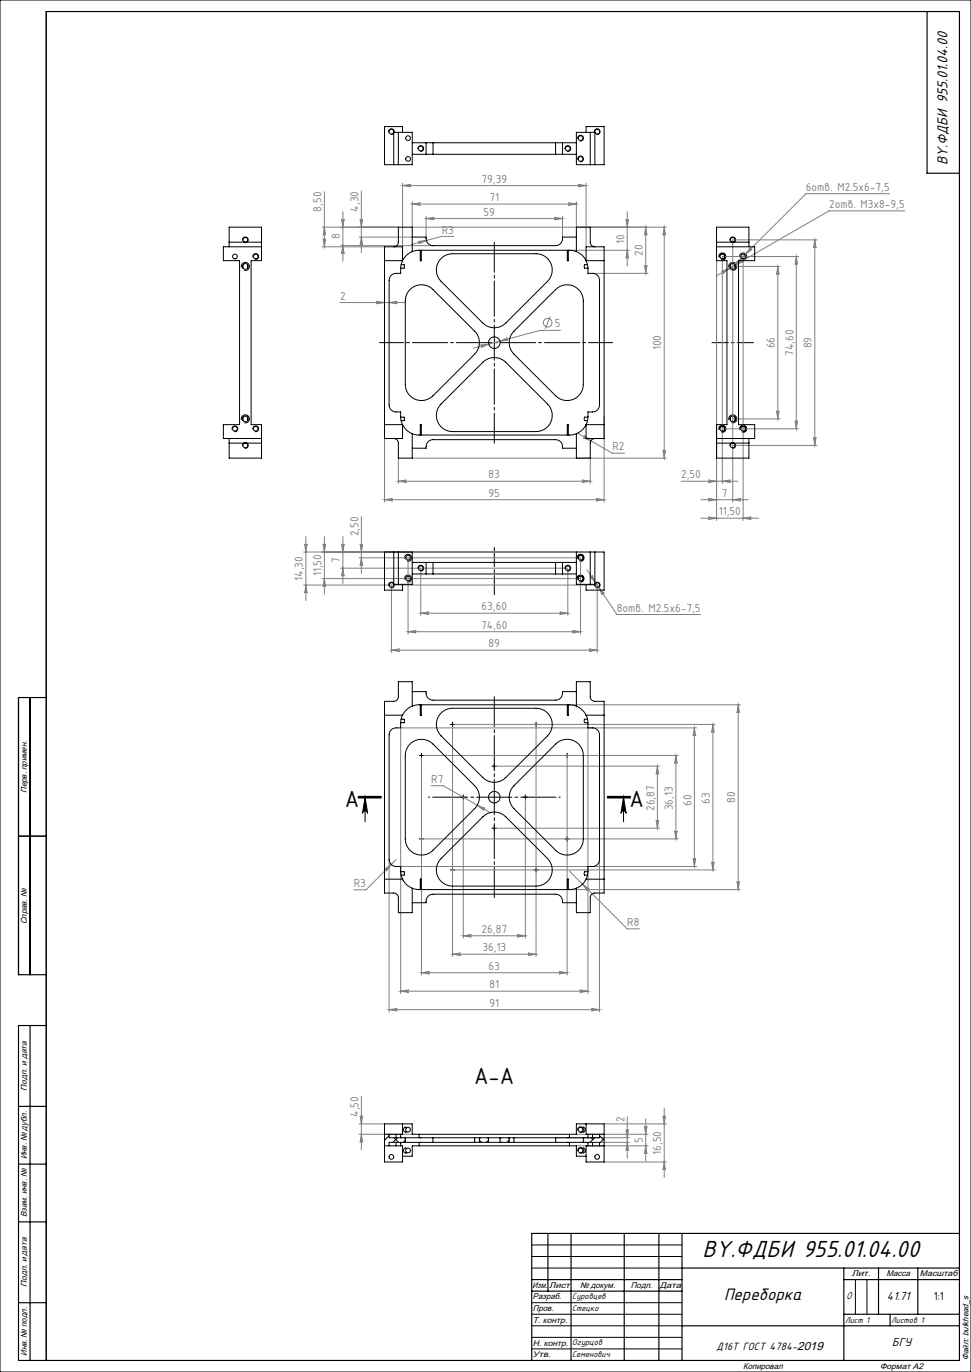
[picture p152: page 1]
2отв. M3х8-9,5; 6отв. M2.5х6-7,5; 8отв. M2.5х6-7,5; Копировал; Формат А2; BY.ФДБИ 955.01.04.00; Файл: bulkhead_s

Справ. № Перв. примен. Подп. и дата Инв. № дубл. Взам. инв. № Подп. и дата Инв. № подл.

BY.ФДБИ 955.01.04.00

Переборка | Лит. | Масса | Масштаб

Изм. | Лист № докум. | | Подп. | Дата | | О | | | 41.71 | 1:1
Разраб. | | Суровцев
Пров. | | Стецко
Т. контр. | | | | | Лист 1 | Листов 1

Н. контр. | Огурцов
Утв. | Семенович

Д16Т ГОСТ 4784-2019 | БГУ
