6haitandimon/BSUSat2_simulator/docs/КД_CМКА/Чертежи/8_BY.ФДБИ 955.01.05.00_креплДатчСолн_O.pdf

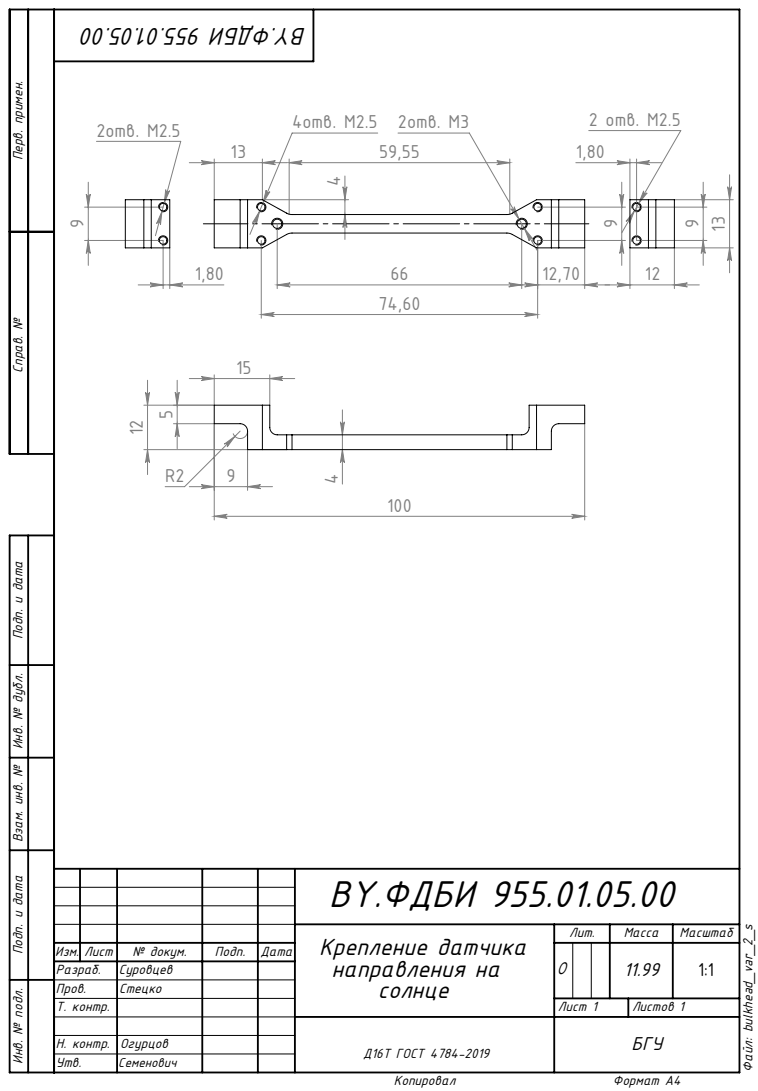
[picture p153: page 1]
2отв. M3; 4отв. M2.5; 2 отв. M2.5; 2отв. M2.5; Копировал; Формат А4; Файл: bulkhead_var_2_s

Справ. № Перв. примен. Подп. и дата Инв. № дубл. Взам. инв. № Подп. и дата Инв. № подл.

BY.ФДБИ 955.01.05.00

Крепление датчика направления на солнце | Лит. | Масса | Масштаб

Изм. | Лист | № докум. | Подп. | Дата | | О | | | 11.99 | 1:1
Разраб. | | Суровцев
Пров. | Стецко
Т. контр. | | | | | Лист 1 | Листов 1

Д16Т ГОСТ 4784-2019 | БГУ

Н. контр. | Огурцов
Утв. | Семенович
