6haitandimon/BSUSat2_simulator/(commit log)

2023-11-12 Add comments to func. Calibration set
2023-11-12 added main to flash on pico
2023-12-03 first driver realization
2024-02-13 add driver to INA3221
2024-02-13 update INA219-driver struct
2024-03-09 add MCP2515 driver
2024-03-09 Update realization
    New realization driver in OOP style
2024-03-16 Обновление структуры ветки
2024-03-16 Базовая конфигурация интового проекта для материнской платы Создание структуры, интеграция Cmake файлов для сборки проекта. Исправление локальных ошибок в конфликтных файлах(создание пространства име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
    [ina219.h, ina3221.h, main.cpp]
2024-03-18 реализация драйвера INA219 на c++
2024-03-22 OOP realization
    INA219, INA3221 переписаны с использованием ООП парадигмы, а так же добавлена инициализация портов и периферии в момент создания объектов
2024-04-01 Схемы бортовой электроники
    [01_Top_Overlay_Silk.GTO, 02_Top_Paste_Mask.GTP, 03_Top_Solder_Mask.GTS, 04_Top_ComponentSide.GTL, 05_Bottom_ComponentSide.GBL, 06_Bottom_Solder_Mask.GBS, 07_Bottom_ComponentSide.GBL, 07_Bottom_Paste_Mask.GBP]
2024-04-04 telemetry struct, can interrupt, refactoring
2024-04-06 New namespace, PCA9554 driver update, INA219 driver update
    The new namespace in INTERRUPT lib, name is INTERRUPT. This is needed for example to add new interrupts for other chips.
    PCA9554: fix bug and optimization code. Update save i2c bus number.
    INA219: add new function - change address. This is needed for example if you have some INA chips on one I2C bus and so as not to create a new object for each.
    [ina219.h, interrupt.cpp, interrupt.h, main.cpp]
2024-04-23 Update drivers
    Update can driver and setup answer from can questions
    [pico-debug.cfg]
2024-04-26 update all drivers and add python telemetry parser
2024-07-30 add a raw data transfer
    [pico-debug.cfg]
2025-01-03 New project struct
    [01_Top_Overlay_Silk.GTO, 02_Top_Paste_Mask.GTP, 03_Top_Solder_Mask.GTS, 04_Top_ComponentSide.GTL, 05_Bottom_ComponentSide.GBL, 06_Bottom_Solder_Mask.GBS, 07_Bottom_ComponentSide.GBL, 07_Bottom_Paste_Mask.GBP]
2025-01-03 Add firs module and update git ignore
    1 In dir models add model MotherBoard.
    1.1 Add cmake file in motherboard.
    1.1 Add print memory usage map
    2 Add new cmake compilation profiles
    2.1 Optimization flash size
2025-01-05 add new branch to develop radio transmitter driver and firmware
2025-01-14 Add base transmit construction (not working) Add base struct to sx127x driver Add nrzi encoder Add scrambler Add hdlc encoder Add ax25 packet struct
    [main.cpp]
2025-01-14 Update driver Add function to load config Add function to disable sync words update registers list§
2025-02-14 Big Update 14.02.2025 17:38
    1. Add new arch to transmit process
    2. Add little realization ProcessFabric
    3. Add arch and realization TimerManager Lib
